CodyMcCodeface69/plantOS-Hydromat/plantos.pdf

# plantos

## started 1 week 13 minutes ago

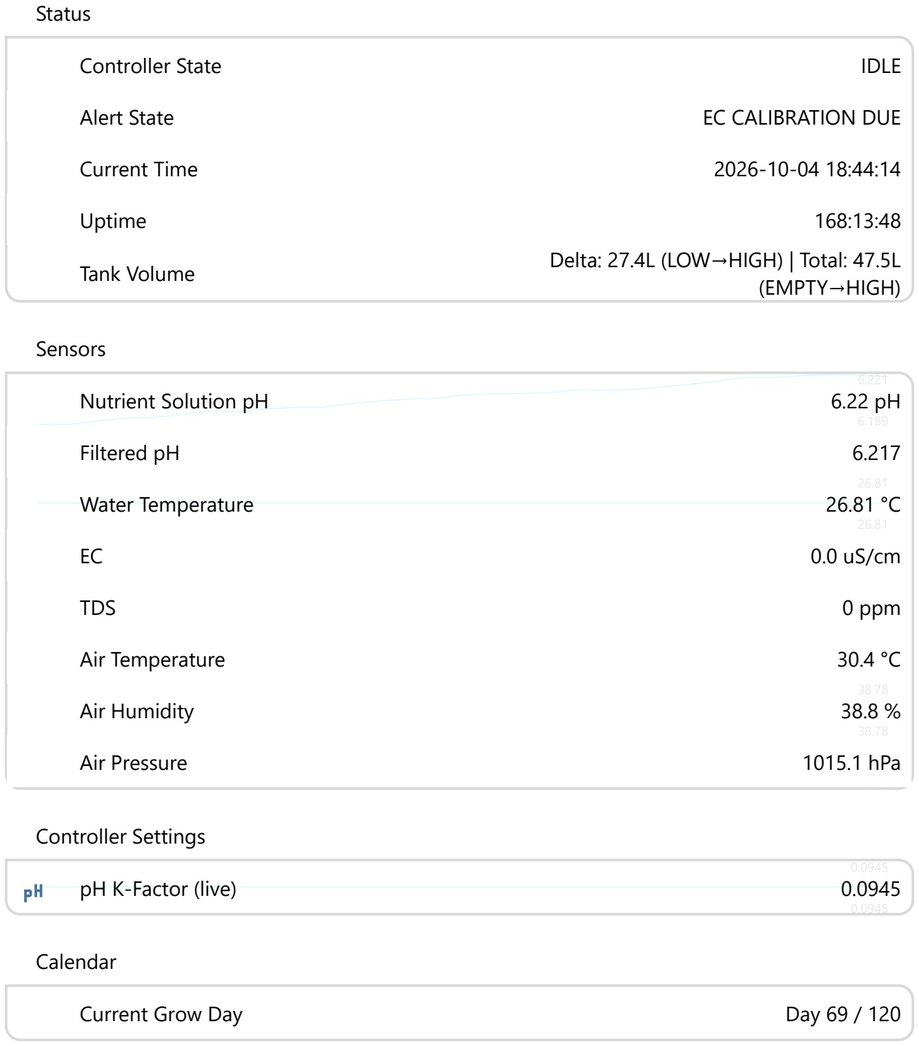
[picture p1: figure]
Status; Sensors; Controller Settings; Calendar; Controller State; IDLE; Alert State; EC CALIBRATION DUE; Current Time; Uptime; (EMPTY→HIGH); Nutrient Solution pH; Filtered pH; Water Temperature; TDS; 0 ppm; Air Temperature; Air Humidity; Air Pressure; 1015.1 hPa; pH K-Factor (live); Current Grow Day; Day 69 / 120

## System

Tank Volume | Delta: 27.4L (LOW→HIGH) | Total: 47.5L
plantos | http://192.168.0.201/
1 von 3 | 04.10.2026, 18:44

## Debug Log

Time | Tag | Message
18:44:07 [status.log… ==============================================================… 18:44:07 [status.log… PLANTOS STATUS - 2026-10-04 18:44:07
18:44:07 [status.log… ==============================================================… 18:44:07 [status.log…
18:44:07 [status.log… **************************************************************… 18:44:07 [status.log… **************************************************************… 18:44:07 [status.log… *** CRITICAL ALERTS ACTIVE ***
18:44:07 [status.log… **************************************************************… 18:44:07 [status.log… **************************************************************… 18:44:07 [status.log…
18:44:07 [status.log… *** ALERT #1: EC_CALIBRATION_DUE
18:44:07 [status.log… *** Brief: EC calibration overdue: 82 days since last
| | calibration
18:44:07 [status.log… *** Active for: 56.0 seconds
18:44:07 [status.log…
18:44:07 [status.log… **************************************************************… 18:44:07 [status.log… **************************************************************… 18:44:07 [status.log… --- NETWORK ---
18:44:07 [status.log… IP: 192.168.0.201 | Web: Online
18:44:07 [status.log… --- HARDWARE ---
18:44:07 [status.log… [✓ 0x76: BME280 Air Sensor[0m
18:44:07 [status.log… [✓ EZO pH Sensor (TX=GPIO18, RX=GPIO19 (uart_bus))[0m 18:44:07 [status.log… [✓ DS18B20 Temperature (GPIO23) - 26.8°C[0m 18:44:07 [status.log… [✓ Shelly Plus 4PM (192.168.0.130) - up 887h37m[0m 18:44:07 [status.log… [✓ Water Level: FULL (H=ON, L=ON)[0m

## Debug: HAL Mirrors

Built-in LED | 0 | 255

255

Water Temperature (HAL) | 26.8°C
Air Temperature (HAL) | 30.4°C
Air Humidity (HAL) | 38.8%
Air Pressure (HAL) | 1015.1 hPa
EC (HAL) | 0 uS/cm

18:44:07 [status.log… --- SENSORS ---
18:44:07 [status.log… pH: 6.22
18:44:07 [status.log… Water Temp: 26.8°C
18:44:07 [status.log… EC: 0 uS/cm / 0.000 mS/cm (TDS: 0 ppm) 18:44:07 [status.log… --- CALENDAR ---
18:44:07 [status.log… Day: 69/120 | pH: 6.0-6.4 | Auto: ON
18:44:07 [status.log… Nutrients (mL/L): A=0.64; B=1.28; C=1.92 18:44:07 [status.log… EC Target: 2200 x 1.00x = 2200 uS/cm
18:44:07 [status.log… --- STATE ---
18:44:07 [status.log… Controller: IDLE | Maintenance: OFF
18:44:07 [status.log… PSM: PH_CORRECTION (Status: 0, Age: 6635815 sec)
18:44:07 [status.log… Active Alerts: 1
18:44:07 [status.log… [31m[1] EC_CALIBRATION_DUE: EC calibration overdue: 82 days since last calibration (56s)[0m 18:44:07 [status.log… ==============================================================… 18:44:07 [status.log… --- WATER LEVEL STATUS ---
18:44:07 [status.log… ┌─────────┐
18:44:07 [status.log… │█████████│ ← HIGH
18:44:07 [status.log… │█████████│
18:44:07 [status.log… │█████████│ ← LOW 18:44:07 [status.log… │█████████│
18:44:07 [status.log… │█████████│ ← EMPTY
18:44:07 [status.log… └─────────┘
18:44:07 [status.log… Water Level: FULL (above HIGH sensor)
18:44:07 [status.log… Sensors: HIGH=ON, LOW=ON, EMPTY=ON
18:44:10 [ezo_ph_uar… pH: 6.22
18:44:11 [plantos_co… [CALIB_REMINDER] EC calibration overdue: 82 days since last calibration
