CodyMcCodeface69/plantOS-Hydromat/Hardware/BOM_HydromatMK1_PCB_HydromatMK1_2026-04-05.csv

No. | Quantity | Comment | Designator | Footprint | Value | Manufacturer Part | Manufacturer | Supplier Part | Supplier | LCSC Part Name | Datasheet
1 | 4 | 5017 | 3V3,5V,12V,GND | TEST-SMD_L2.7-W1.0 |  | 5017 | Keystone | C238130 | LCSC | 5017 | https://item.szlcsc.com/datasheet/5017/237378.html
2 | 1 | 10uF | B_C1 | C0603 | 10uF | CL10A106MO8NQNC | SAMSUNG(三星) | C92487 | LCSC | 10uF ±20% 16V | https://item.szlcsc.com/datasheet/CL10A106MO8NQNC/93680.html
3 | 1 | 100nF | B_C2 | C0603 | 100nF | CC0603KRX7R9BB104 | YAGEO(国巨) | C14663 | LCSC | 100nF ±10% 50V | https://item.szlcsc.com/datasheet/CC0603KRX7R9BB104/15331.html
4 | 1 | 8.2nF | B_C3 | C0805 | 8.2nF | CC0805JRX7R9BB822 | YAGEO(国巨) | C309490 | LCSC | 8.2nF ±5% 50V | https://item.szlcsc.com/datasheet/CC0805JRX7R9BB822/293106.html
5 | 1 | 1nF | B_C4 | C0805 | 1nF | CL21B102KBCNNNC | SAMSUNG(三星) | C46653 | LCSC | 1nF ±10% 50V | https://item.szlcsc.com/datasheet/CL21B102KBCNNNC/47657.html
6 | 1 | 24pF | B_C5 | C0805 | 24pF | 0805CG240J500NT | FH(风华) | C1806 | LCSC | 24pF ±5% 50V | https://item.szlcsc.com/datasheet/0805CG240J500NT/2158.html
7 | 1 | 10uF | B_C6 | C0805 | 10uF | CL21A106KBYQNNE | SAMSUNG(三星) | C2932476 | LCSC | 10uF ±10% 50V | https://item.szlcsc.com/datasheet/CL21A106KBYQNNE/3277789.html
8 | 1 | SS24FL | B_D1 | SOD-123_L2.6-W1.6-LS3.5-RD |  | SS24FL | KEXIN(科信) | C489144 | LCSC | 电压:40V 电流:2A | https://item.szlcsc.com/datasheet/SS24FL/499168.html
9 | 1 | 6.8uH | B_L1 | IND-SMD_L2.5-W2.0_FTC252010S | 6.8uH | FTC252012S6R8MBCA | cjiang(长江微电) | C5832375 | LCSC | 6.8uH ±20% 2A | https://item.szlcsc.com/datasheet/FTC252012S6R8MBCA/6763495.html
10 | 1 | 169kΩ | B_R1 | R0603 | 169kΩ | 0603WAF1693T5E | UNI-ROYAL(厚声) | C22817 | LCSC | 169kΩ ±1% 100mW 厚膜电阻 | https://atta.szlcsc.com/upload/public/pdf/source/20200306/C422600_1E6D84923E4A46A82E41ADD87F860B5C.pdf
11 | 1 | 39.2kΩ | B_R2 | R0603 | 39.2kΩ | 0603WAF3922T5E | UNI-ROYAL(厚声) | C23037 | LCSC | 39.2kΩ ±1% 100mW 厚膜电阻 | https://item.szlcsc.com/datasheet/0603WAF3922T5E/23764.html
12 | 1 | 45.3kΩ | B_R4 | R0805 | 45.3kΩ | FRC0805F4532TS | FOJAN(富捷) | C2933446 | LCSC | 45.3kΩ ±1% 125mW 厚膜电阻 | https://item.szlcsc.com/datasheet/FRC0805F4532TS/3279548.html
13 | 1 | 10.2kΩ | B_R5 | R0805 | 10.2kΩ | FRC0805F1022TS | FOJAN(富捷) | C2933282 | LCSC | 10.2kΩ ±1% 125mW 厚膜电阻
14 | 1 | 10kΩ | B_R6 | R0805 | 10kΩ | FRC0805J103TS | FOJAN(富捷) | C2930231 | LCSC | 10kΩ ±5% 125mW 厚膜电阻
15 | 1 | TPS54232DR | B_U1 | SOIC-8_L4.9-W3.9-P1.27-LS6.0-BL |  | TPS54232DR | TI(德州仪器) | C52653 | LCSC | 28V、2A、1MHz降压DC-DC转换器 | http://www.ti.com/cn/lit/gpn/tps54232
16 | 1 | 22uF | C9 | CASE-B_3528 | 22uF | TAJB226K016RNJ | Kyocera AVX | C8020 | LCSC | 22uF ±10% 16V
17 | 1 | 10uF | C10 | C0805 |  | CL21A106KAYNNNE | SAMSUNG(三星) | C15850 | LCSC
18 | 6 | 100nF | C11,C12,C17,C18,C21,C23 | C0805 | 100nF | CC0805KRX7R9BB104 | YAGEO(国巨) | C49678 | LCSC | 100nF ±10% 50V | https://item.szlcsc.com/datasheet/CC0805KRX7R9BB104/50686.html
19 | 1 | 10uF | C13 | CAP-SMD_L3.2-W1.6-RD-C7171 | 10uF | TAJA106K016RNJ | Kyocera AVX | C7171 | LCSC | 10uF ±10% 16V
20 | 1 | 470uF | C14 | CAP-SMD_BD10.0-L10.3-W10.3-LS11.0-FD | 470uF | RVT1E471M1010 | HONOR(荣誉) | C3351 | LCSC | 470uF ±20% 25V | https://atta.szlcsc.com/upload/public/pdf/source/20210521/C113284_25C86AE95FB541053FE695F13EA8E7D0.pdf
21 | 4 | 10uF | C16,C19,C20,C24 | C0805 | 10uF | GRM21BR71A106KE51L | muRata(村田) | C86038 | LCSC | 10uF ±10% 10V | https://atta.szlcsc.com/upload/public/pdf/source/20200305/C490387_23319AE8C154DEB24C505E6C82A8106A.pdf
22 | 5 | S3B-XH-A-1(LF)(SN) | CN4,CN5,CN6,CN7,CN9 | CONN-TH_S3B-XH-A-1-LF-SN |  | S3B-XH-A-1(LF)(SN) | JST | C163036 | LCSC | 1x3P 间距:2.5mm 弯插 系列:XH | https://item.szlcsc.com/datasheet/S3B-XH-A-1(LF)(SN)/174417.html
23 | 1 | S4B-XH-A(LF)(SN) | CN8 | CONN-TH_S4B-XH-A-LF-SN |  | S4B-XH-A(LF)(SN) | JST | C157925 | LCSC | 1x4P 间距:2.5mm 弯插 系列:XH | https://item.szlcsc.com/datasheet/S4B-XH-A(LF)(SN)/169273.html
24 | 1 | SS54 | D1 | SMA_L4.3-W2.6-LS5.1-RD |  | SS54 | JSMSEMI(杰盛微) | C20609300 | LCSC | 电压:40V 电流:5A | https://item.szlcsc.com/datasheet/SS54/21959862.html
25 | 5 | SS24 | D2,D3,D4,D5,D6 | SMA_L4.3-W2.6-LS5.0-FD |  | SS24 | R+O(宏嘉诚) | C7420362 | LCSC | 电压:40V 电流:2A | https://item.szlcsc.com/datasheet/SS24/8397184.html
26 | 1 | DC-018-2.5A-2.5 | DC2 | DC-IN-TH_DC-018 |  | DC-018-2.5A-2.5 | XKB Connection(中国星坤) | C2880553 | LCSC
27 | 1 | XL-1608UGC-04 | LED1 | LED0603-RD_GREEN |  | XL-1608UGC-04 | XINGLIGHT(成兴光) | C965804 | LCSC | 0603翠绿贴片式发光二极管 | https://item.szlcsc.com/datasheet/XL-1608UGC-04/1051413.html
28 | 4 | ZX-PM2.54-1-16PY | P1,P2,P5,P6 | HDR-TH_16P-P2.54-V-F-1 |  | ZX-PM2.54-1-16PY | Megastar(兆星) | C7499334 | LCSC | 1x16P 间距:2.54mm 直插 | https://item.szlcsc.com/datasheet/ZX-PM2.54-1-16PY/8573995.html
29 | 2 | 2.54-1*8P母环保 | P3,P4 | HDR-TH_8P-P2.54-V-F_2 |  | 2.54-1*8P母环保 | BOOMELE(博穆精密) | C27438 | LCSC | 1x8P 间距:2.54mm 直插 | https://item.szlcsc.com/datasheet/2.54-1*8P%25E6%25AF%258D%25E7%258E%25AF%25E4%25BF%259D/28187.html
30 | 5 | IRLML6244TRPBF | Q1,Q2,Q3,Q4,Q5 | SOT-23-3_L2.9-W1.3-P1.90-LS2.4-BR |  | IRLML6244TRPBF | Infineon(英飞凌) | C143946 | LCSC | 1个N沟道 耐压:20V 电流:6.3A | https://item.szlcsc.com/datasheet/IRLML6244TRPBF/155278.html
31 | 5 | 10kΩ | R1,R4,R5,R14,R16 | R0805 | 10kΩ | 0805W8F1002T5E | UNI-ROYAL(厚声) | C17414 | LCSC | 10kΩ ±1% 125mW 厚膜电阻 | https://item.szlcsc.com/datasheet/0805W8F1002T5E/18102.html
32 | 6 | 100Ω | R2,R3,R13,R15,R17,R22 | R0805 | 100Ω | 0805W8F1000T5E | UNI-ROYAL(厚声) | C17408 | LCSC | 100Ω ±1% 125mW 厚膜电阻 | https://atta.szlcsc.com/upload/public/pdf/source/20200306/C422600_1E6D84923E4A46A82E41ADD87F860B5C.pdf
33 | 1 | 4.7kΩ | R18 | R0805 | 4.7kΩ | 0805W8F4701T5E | UNI-ROYAL(厚声) | C17673 | LCSC | 4.7kΩ ±1% 125mW 厚膜电阻 | https://atta.szlcsc.com/upload/public/pdf/source/20200306/C422600_1E6D84923E4A46A82E41ADD87F860B5C.pdf
34 | 1 | 1kΩ | R23 | R0805 | 1kΩ | FRC0805J102 TS | FOJAN(富捷) | C2907295 | LCSC | 1kΩ ±5% 125mW 厚膜电阻
35 | 5 | S2B-XH-A-1(LF)(SN) | U1,U2,U3,U4,U5 | CONN-TH_S2B-XH-A-1-LF-SN |  | S2B-XH-A-1(LF)(SN) | JST | C163035 | LCSC | 1x2P 间距:2.5mm 弯插 系列:XH | https://item.szlcsc.com/datasheet/S2B-XH-A-1(LF)(SN)/174416.html
36 | 1 | AMS1117-3.3 | U10 | SOT-223-4_L6.5-W3.5-P2.30-LS7.0-BR |  | AMS1117-3.3 | UMW(友台半导体) | C347222 | LCSC | 3.3V 1A 12V | https://item.szlcsc.com/datasheet/AMS1117-3.3/323882.html
37 | 1 | 220kHz | U11 | PWRM-TH_B0303S-1WR3 | 220kHz | B0303S-1WR3 | YLPTEC(易川) | C7468813 | LCSC | DC-DC转换器 | https://item.szlcsc.com/datasheet/B0303S-1WR3/8515946.html
38 | 1 | ADUM1201ARZ-RL7 | U13 | SOIC-8_L4.9-W3.9-P1.27-LS6.0-BL |  | ADUM1201ARZ-RL7 | ADI(亚德诺) | C9669 | LCSC | 双通道数字隔离器（1/1通道方向性） | https://item.szlcsc.com/datasheet/ADUM1201ARZ-RL7/10199.html
