CodyMcCodeface69/plantOS-Hydromat/docs/architecture/MIGRATION_GUIDE.md

# PlantOS Migration Guide: Dual FSM → Unified 3-Layer HAL

This guide helps users migrate from the old dual FSM architecture (Controller + PlantOSLogic) to the new unified 3-layer HAL architecture (PlantOSController).

## Quick Summary

### What Changed?
- **Old**: Two separate FSMs (Controller for hardware, PlantOSLogic for routines)
- **New**: Single unified FSM (PlantOSController) with 12 states
- **Architecture**: Added HAL (Hardware Abstraction Layer) between controller and hardware

### What Stayed The Same?
- ✅ All functionality preserved (pH correction, feeding, water management)
- ✅ Safety features (ActuatorSafetyGate, PSM, WDT)
- ✅ Web interface controls
- ✅ Configuration in plantOS.yaml
- ✅ ESPHome framework and workflow

### Breaking Changes?
- **YAML configuration changes**: Required (component names, IDs)
- **Button lambda calls**: Changed (different API methods)
- **Custom automation**: May need updates (different component IDs)
- **Existing data**: Preserved (NVS, settings, schedules)

## Architecture Comparison

### Old Architecture (Dual FSM)

```
┌─────────────────────────────┐
│ Controller (Hardware FSM)   │
│ - INIT, READY, ERROR       │
│ - LED patterns              │
│ - Sensor monitoring         │
└────────────┬────────────────┘
             │
┌────────────▼────────────────┐
│ PlantOSLogic (App FSM)      │
│ - PH_*, FEEDING_*, WATER_*  │
│ - Routine orchestration     │
└────────────┬────────────────┘
             │
┌────────────▼────────────────┐
│ ActuatorSafetyGate          │
│ - Direct GPIO control       │
└─────────────────────────────┘
```

**Issues**:
- Confusing responsibility split
- Direct hardware access scattered
- Hard to test without hardware
- No clear hardware abstraction

### New Architecture (Unified 3-Layer HAL)

```
┌─────────────────────────────────────┐
│ Layer 1: Unified Controller        │
│ - 12 states (INIT, IDLE, PH_*, etc)│
│ - LED behaviors per state           │
│ - Complete routine orchestration    │
└────────────┬────────────────────────┘
             │ (requests)
┌────────────▼────────────────────────┐
│ Layer 2: ActuatorSafetyGate         │
│ - Validates all commands            │
│ - Enforces safety rules             │
└────────────┬────────────────────────┘
             │ (approved commands)
┌────────────▼────────────────────────┐
│ Layer 3: HAL                        │
│ - Pure hardware interface           │
│ - Wraps ESPHome components          │
└─────────────────────────────────────┘
```

**Benefits**:
- Single unified FSM (clear responsibility)
- Hardware abstraction (testable, portable)
- All hardware access through validation
- Clean layer separation

## Migration Steps

### Step 1: Backup Current Configuration

Before making changes, backup your working configuration:

```bash
# Backup YAML
cp plantOS.yaml plantOS.yaml.backup

# Backup NVS data (if possible via OTA)
# Your PSM events, calendar day, etc. are preserved in NVS
```

### Step 2: Update Git Branch

If you're on the old architecture:

```bash
# Check current branch
git status

# Switch to unified architecture branch
git checkout hydro  # or your main branch with unified controller

# Check what changed
git log --oneline
```

### Step 3: Update plantOS.yaml Configuration

#### 3a. Remove Old Components

**DELETE these sections** (if still present):

```yaml
# OLD - Remove completely
controller:
  id: my_controller
  sensor_source: filtered_ph_sensor
  light_target: system_led

# OLD - Remove completely
plantos_logic:
  id: plant_logic
  hal: hal
  safety_gate: actuator_safety
  calendar: plant_calendar
  persistence: psm
```

#### 3b. Add HAL Component

**ADD this new section**:

```yaml
# Layer 3: Hardware Abstraction Layer
plantos_hal:
  id: hal
  system_led: system_led        # Reference to your RGB LED
  ph_sensor: filtered_ph_sensor # Reference to your pH sensor
```

#### 3c. Update SafetyGate Configuration

**CHANGE**:
```yaml
# OLD
actuator_safety_gate:
  id: actuator_safety
  # ... durations ...
```

**TO**:
```yaml
# NEW - Add HAL dependency
actuator_safety_gate:
  id: actuator_safety
  hal: hal  # NEW: HAL dependency
  acid_pump_max_duration: 30
  nutrient_pump_max_duration: 60
  water_valve_max_duration: 300
  wastewater_pump_max_duration: 180
  air_pump_max_duration: 600
  ramp_duration: 2000
```

#### 3d. Add Unified Controller

**ADD this new section**:

```yaml
# Layer 1: Unified Controller
plantos_controller:
  id: unified_controller
  hal: hal                      # Required
  safety_gate: actuator_safety  # Required
  persistence: psm              # Optional
```

#### 3e. Update Button Configurations

**OLD button calls**:
```yaml
button:
  - platform: template
    name: "Start pH Correction"
    on_press:
      - lambda: id(plant_logic)->start_ph_correction();

  - platform: template
    name: "Toggle Maintenance"
    on_press:
      - lambda: id(plant_logic)->toggle_maintenance_mode(true);
```

**NEW button calls**:
```yaml
button:
  - platform: template
    name: "Start pH Correction"
    on_press:
      - lambda: id(unified_controller)->startPhCorrection();

  - platform: template
    name: "Toggle Maintenance ON"
    on_press:
      - lambda: id(unified_controller)->toggleMaintenanceMode(true);

  - platform: template
    name: "Toggle Maintenance OFF"
    on_press:
      - lambda: id(unified_controller)->toggleMaintenanceMode(false);
```

#### 3f. Update external_components List

**CHANGE**:
```yaml
external_components:
  - source: components
    components: [controller, sensor_dummy, plantos_logic, ...]
```

**TO**:
```yaml
external_components:
  - source: components
    components: [sensor_dummy, sensor_filter, ezo_ph,
                 actuator_safety_gate, calendar_manager,
                 persistent_state_manager, i2c_scanner,
                 time_logger, wdt_manager, i2c_mutex_demo,
                 plantos_hal, plantos_controller]
```

**Removed**: `controller`, `plantos_logic`
**Added**: `plantos_hal`, `plantos_controller`

### Step 4: Build and Flash

```bash
# Clean old build
task clean

# Build new firmware
task build

# Flash to device
task flash

# Monitor logs
task snoop
```

### Step 5: Verify Operation

After flashing, verify these behaviors:

#### Boot Sequence (3 seconds)
- ✅ LED: Red → Yellow → Green
- ✅ Serial: "Boot sequence complete"
- ✅ Transitions to IDLE state

#### IDLE State (Breathing Green)
- ✅ LED: Smooth breathing green (pulsing)
- ✅ Web interface accessible
- ✅ Buttons respond to clicks

#### pH Correction (Manual Test)
1. Click "Start pH Correction" button
2. ✅ LED: Changes to yellow pulse
3. ✅ Serial: "pH measuring: All pumps OFF"
4. ✅ After 5 min: Transitions to PH_CALCULATING
5. ✅ If correction needed: Cyan pulse (PH_INJECTING)
6. ✅ After dosing: Blue pulse (PH_MIXING, 2 min)
7. ✅ Returns to PH_MEASURING or IDLE

#### Maintenance Mode
1. Click "Toggle Maintenance ON"
2. ✅ LED: Solid yellow
3. ✅ Serial: "Maintenance mode ACTIVE - all pumps OFF"
4. ✅ All pumps turned off
5. ✅ Click "Toggle Maintenance OFF"
6. ✅ Returns to IDLE (breathing green)

## API Changes

### Old Controller API (Removed)

```cpp
// components/controller/controller.h
class Controller {
    void reset_to_init();
    void set_verbose(bool verbose);
    bool get_verbose();
    CentralStatusLogger* get_logger();
};
```

### Old PlantOSLogic API (Removed)

```cpp
// components/plantos_logic/PlantOSLogic.h
class PlantOSLogic {
    void start_ph_correction();
    void start_ph_measurement_only();
    void start_feeding();
    void start_fill_tank();
    void start_empty_tank();
    void toggle_maintenance_mode(bool state);
};
```

### New Unified Controller API

```cpp
// components/plantos_controller/controller.h
class PlantOSController {
    // Public API
    void startPhCorrection();           // Start pH correction sequence
    void startFeeding();                // Start nutrient dosing
    void startFillTank();               // Start water fill
    void startEmptyTank();              // Start water empty
    bool toggleMaintenanceMode(bool enable);  // Enter/exit maintenance
    void resetToInit();                 // Reset FSM to INIT

    // Getters
    ControllerState getCurrentState();  // Get current state
    CentralStatusLogger* getStatusLogger();  // Access status logger
};
```

### API Migration Table

| Old API | New API | Notes |
|---|---|---|
| `my_controller->reset_to_init()` | `unified_controller->resetToInit()` | Camel case |
| `plant_logic->start_ph_correction()` | `unified_controller->startPhCorrection()` | Camel case, different ID |
| `plant_logic->start_feeding()` | `unified_controller->startFeeding()` | Camel case, different ID |
| `plant_logic->start_fill_tank()` | `unified_controller->startFillTank()` | Camel case, different ID |
| `plant_logic->start_empty_tank()` | `unified_controller->startEmptyTank()` | Camel case, different ID |
| `plant_logic->toggle_maintenance_mode(true)` | `unified_controller->toggleMaintenanceMode(true)` | Camel case, different ID |
| `my_controller->get_logger()` | `unified_controller->getStatusLogger()` | Camel case, renamed method |
| `my_controller->set_verbose(true)` | ❌ **REMOVED** | Verbose mode removed |
| `plant_logic->start_ph_measurement_only()` | ❌ **REMOVED** | Not implemented yet |

## State Mapping

### Old Controller States → New States

| Old Controller State | New Unified State | Notes |
|---|---|---|
| INIT | INIT | Same (boot sequence) |
| CALIBRATION | ❌ Removed | Not used |
| READY | IDLE | Renamed for clarity |
| ERROR | ERROR | Same |
| ERROR_TEST | ❌ Removed | PSM test removed |

### Old PlantOSLogic States → New States

| Old Logic State | New Unified State | Notes |
|---|---|---|
| IDLE | IDLE | Same |
| PH_CORRECTION_DUE | ❌ Removed | Instant transition |
| PH_MEASURING | PH_MEASURING | Same |
| PH_CALCULATING | PH_CALCULATING | Same |
| PH_INJECTING | PH_INJECTING | Same |
| PH_MIXING | PH_MIXING | Same |
| PH_CALIBRATING | PH_CALIBRATING | Same (not implemented) |
| FEEDING_DUE | ❌ Removed | Instant transition |
| FEEDING_INJECTING | FEEDING | Renamed |
| WATER_MANAGEMENT_DUE | ❌ Removed | Instant transition |
| WATER_FILLING | WATER_FILLING | Same |
| WATER_EMPTYING | WATER_EMPTYING | Same |
| AWAITING_SHUTDOWN | MAINTENANCE | Renamed for clarity |

**Total**: 13 old states → 12 new states (removed redundant "DUE" states)

## LED Patterns

### LED Pattern Changes

| State | Old Pattern | New Pattern | Changed? |
|---|---|---|---|
| INIT | Red→Yellow→Green (3s) | Red→Yellow→Green (3s) | ✅ Same |
| IDLE/READY | Breathing green | Breathing green | ✅ Same |
| MAINTENANCE | Solid yellow | Solid yellow | ✅ Same |
| ERROR | Fast red flash | Fast red flash | ✅ Same |
| PH_MEASURING | Yellow pulse | Yellow pulse | ✅ Same |
| PH_CALCULATING | Yellow fast blink | Yellow fast blink | ✅ Same |
| PH_INJECTING | Cyan pulse | Cyan pulse | ✅ Same |
| PH_MIXING | Blue pulse | Blue pulse | ✅ Same |
| FEEDING | Orange pulse | Orange pulse | ✅ Same |
| WATER_FILLING | Blue solid | Blue solid | ✅ Same |
| WATER_EMPTYING | Purple pulse | Purple pulse | ✅ Same |

**All LED patterns preserved!** Visual behavior unchanged.

## Troubleshooting

### Build Errors

#### Error: "Could not find __init__.py file for component controller"

**Cause**: Old component still referenced in `external_components`

**Fix**: Remove `controller` and `plantos_logic` from components list:
```yaml
external_components:
  - source: components
    components: [sensor_dummy, ..., plantos_hal, plantos_controller]
    # Removed: controller, plantos_logic
```

#### Error: "Component 'my_controller' not found"

**Cause**: Button or automation references old component ID

**Fix**: Change all `my_controller` to `unified_controller`:
```yaml
# OLD
- lambda: id(my_controller)->reset_to_init();

# NEW
- lambda: id(unified_controller)->resetToInit();
```

#### Error: "Component 'plant_logic' not found"

**Cause**: Button or automation references old component ID

**Fix**: Change all `plant_logic` to `unified_controller`:
```yaml
# OLD
- lambda: id(plant_logic)->start_ph_correction();

# NEW
- lambda: id(unified_controller)->startPhCorrection();
```

#### Error: "no member named 'set_verbose'"

**Cause**: Verbose mode was removed (no longer needed)

**Fix**: Remove all verbose mode calls:
```yaml
# OLD - Remove completely
- lambda: id(my_controller)->set_verbose(true);
```

### Runtime Issues

#### LED not lighting up

**Check**:
1. HAL configured with correct LED ID:
   ```yaml
   plantos_hal:
     system_led: system_led  # Must match your light component ID
   ```
2. LED component exists:
   ```yaml
   light:
     - platform: neopixelbus
       id: system_led
   ```

#### pH readings not working

**Check**:
1. HAL configured with correct sensor ID:
   ```yaml
   plantos_hal:
     ph_sensor: filtered_ph_sensor  # Must match your sensor ID
   ```
2. Sensor chain intact:
   ```yaml
   sensor:
     - platform: ezo_ph
       id: raw_ph_sensor
     - platform: sensor_filter
       id: filtered_ph_sensor
       sensor_source: raw_ph_sensor
   ```

#### Pumps not activating

**Check**:
1. SafetyGate has HAL dependency:
   ```yaml
   actuator_safety_gate:
     hal: hal  # REQUIRED
   ```
2. Check serial logs for SafetyGate rejections
3. Verify duration limits not exceeded

#### Buttons don't work

**Check**:
1. Button lambda uses correct ID:
   ```yaml
   - lambda: id(unified_controller)->startPhCorrection();
   ```
2. Method name is camelCase (not snake_case)
3. Controller ID is `unified_controller` (not `my_controller` or `plant_logic`)

## Data Persistence

### What's Preserved Across Migration?

✅ **Preserved** (stored in NVS):
- Calendar Manager current day
- PSM critical events
- Maintenance mode state (if set)
- Component settings

❌ **Not Preserved**:
- Old controller state (irrelevant)
- Old PlantOSLogic state (irrelevant)
- Verbose mode setting (feature removed)

### NVS Namespace Changes

| Old Namespace | New Namespace | Status |
|---|---|---|
| `controller` | ❌ Not used | Old data ignored |
| `plantos_logic` | ❌ Not used | Old data ignored |
| `calendar_manager` | `calendar_manager` | ✅ Preserved |
| `psm` | `psm` | ✅ Preserved |

**Your grow schedule day and PSM events are preserved!**

## Rollback Procedure

If you need to revert to the old architecture:

### Step 1: Git Rollback

```bash
# Find commit before migration
git log --oneline

# Revert to old architecture
git checkout <commit-before-migration>
```

### Step 2: Restore YAML

```bash
# Restore backup
cp plantOS.yaml.backup plantOS.yaml
```

### Step 3: Rebuild and Flash

```bash
task clean
task run
```

**Note**: NVS data preserved, but you'll need to manually restore any YAML configuration changes made during migration.

## Getting Help

### Resources

- **Architecture Docs**: `docs/architecture/` - Diagrams and detailed docs
- **CLAUDE.md**: Updated component reference
- **Performance Analysis**: `docs/PERFORMANCE_ANALYSIS.md`
- **GitHub Issues**: https://github.com/anthropics/claude-code/issues

### Common Questions

**Q: Will my grow schedule be lost?**
A: No, Calendar Manager data is stored in NVS and preserved.

**Q: Do I need to recalibrate my pH sensor?**
A: No, calibration is stored in the EZO chip itself, not affected.

**Q: Will existing automations break?**
A: Only if they reference `my_controller` or `plant_logic`. Update IDs to `unified_controller` and method names to camelCase.

**Q: Is the new architecture slower?**
A: No, it's actually faster! Loop runs at 3,000-9,000 Hz (vs old ~1,000 Hz).

**Q: Can I keep using both architectures?**
A: No, they're incompatible. You must migrate completely.

**Q: What if I have custom components that depend on old controller?**
A: Update them to use `plantos_controller` API instead. See API migration table above.

## Migration Checklist

### Before Migration
- [ ] Backup `plantOS.yaml`
- [ ] Note current grow schedule day (will be preserved, but good to know)
- [ ] Document any custom automations/buttons
- [ ] Git commit current state

### Configuration Changes
- [ ] Add `plantos_hal` component
- [ ] Add `plantos_controller` component
- [ ] Update `actuator_safety_gate` to include `hal` dependency
- [ ] Remove `controller` component (if present)
- [ ] Remove `plantos_logic` component (if present)
- [ ] Update `external_components` list
- [ ] Update all button lambda calls (ID + method names)
- [ ] Update any custom automations

### Testing
- [ ] Build succeeds without errors
- [ ] Flash to device successfully
- [ ] Boot sequence shows Red→Yellow→Green
- [ ] IDLE shows breathing green
- [ ] Web interface loads
- [ ] "Start pH Correction" button works
- [ ] pH correction sequence completes
- [ ] Maintenance mode toggles correctly
- [ ] All pumps respond to commands

### Verification
- [ ] No error logs in serial output
- [ ] Loop frequency ≥1000 Hz (check serial if logging enabled)
- [ ] LED animations smooth
- [ ] All safety features working (SafetyGate, PSM, WDT)

### Documentation
- [ ] Update any custom documentation referencing old architecture
- [ ] Note migration date and version

## Success!

You've successfully migrated to the unified 3-layer HAL architecture! 🎉

**Benefits you now have**:
- ✅ Cleaner, unified FSM (12 states)
- ✅ Better performance (3-9x faster loop)
- ✅ Hardware abstraction (future-proof)
- ✅ Testable architecture (mockable HAL)
- ✅ Clearer responsibility separation
- ✅ All original functionality preserved

Enjoy your upgraded PlantOS system!
