CodyMcCodeface69/plantOS-Hydromat/docs/fixes/RISC-V_ALIGNMENT_FIX.md

# RISC-V Alignment Crash Fix - CriticalEventLog Struct

**Date**: 2026-01-15
**Issue**: Store address misaligned exception (MCAUSE: 0x00000007) at xQueueGiveFromISR
**Platform**: ESP32-C6 (RISC-V), ESPHome
**Status**: ✅ FIXED

## Problem Summary

The ESP32-C6 was experiencing recurring crashes with:

```
MCAUSE: 0x00000007 (Store address misaligned)
Abort PC: 0x420dcf97
RA: 0x40808482 (xQueueGiveFromISR)
Faulty Address (A1): 0x408264fe (NOT 4-byte aligned!)
Stack trace contains: "AutoFeedEnable"
```

## Root Cause: Struct Alignment Issue

The crash was caused by the `CriticalEventLog` struct in the Persistent State Manager component having **misaligned fields** that violated RISC-V alignment requirements.

### The Broken Struct

```cpp
// OLD (CRASHES on ESP32-C6)
struct CriticalEventLog {
    char eventID[32];       // 32 bytes at offset 0
    int64_t timestampSec;   // 8 bytes at offset 32 (MISALIGNED!)
    int32_t status;         // 4 bytes at offset 40
};
```

### Why This Crashed

1. **RISC-V Alignment Requirements**:
   - `int64_t` MUST be on 8-byte boundaries (addresses divisible by 8)
   - `int32_t` MUST be on 4-byte boundaries (addresses divisible by 4)
   - `char` has no alignment requirement

2. **The Problem**:
   - `timestampSec` was at offset 32 (after the 32-byte char array)
   - While 32 is divisible by 4, the compiler may place the struct instance at addresses that aren't 8-byte aligned
   - When NVS operations (which use FreeRTOS queues internally) tried to access `timestampSec`, it caused a hardware exception

3. **Why "AutoFeedEnable" Appeared**:
   - The crash occurred during `psm->loadState(NVS_KEY_AUTO_FEED_ENABLE, true)` in controller.cpp:58
   - This NVS operation internally loaded/saved the `CriticalEventLog` struct
   - The misaligned access to `timestampSec` triggered xQueueGiveFromISR to crash

### ESP32 vs ESP32-C6 Behavior

| Architecture | Behavior on Misaligned Access |
|---|---|
| ESP32 (Xtensa) | Allowed (with performance penalty) |
| ESP32-C6 (RISC-V) | **Hardware exception - instant crash!** |

RISC-V is **strict about alignment** by design. This makes code faster but requires careful struct design.

## The Fix

### 1. Reorder Struct Members (Largest to Smallest)

```cpp
// NEW (FIXED for RISC-V)
struct __attribute__((aligned(8))) CriticalEventLog {
    int64_t timestampSec;   // 8 bytes at offset 0 (8-byte aligned ✓)
    int32_t status;         // 4 bytes at offset 8 (4-byte aligned ✓)
    char eventID[32];       // 32 bytes at offset 12 (no requirement)
};
```

**Why This Works**:
- `timestampSec` is now at offset 0 - guaranteed 8-byte aligned
- `status` is at offset 8 - divisible by 4 ✓
- `eventID` is at offset 12 - char arrays have no alignment requirement
- `__attribute__((aligned(8)))` ensures the struct itself is allocated on 8-byte boundaries

### 2. Updated Constructor

The constructor was updated to match the new field order:

```cpp
CriticalEventLog() {
    timestampSec = 0;      // Initialize first (was third)
    status = 0;            // Initialize second (was fourth)
    memset(eventID, 0, sizeof(eventID));  // Initialize third (was first)
}
```

## Files Modified

### `components/persistent_state_manager/persistent_state_manager.h`

**Lines 13-52**: Complete struct rewrite with:
- Field reordering (largest to smallest)
- Explicit 8-byte alignment attribute
- Detailed comments explaining the RISC-V alignment fix
- Updated constructor initialization order

## Memory Layout Comparison

### Before (BROKEN)
```
Offset  Field           Size  Alignment  Issue
------  ------------    ----  ---------  -----
0       eventID[32]     32    1          OK
32      timestampSec    8     8          MISALIGNED! (if struct base isn't 8-aligned)
40      status          4     4          OK
Total: 48 bytes (with padding)
```

### After (FIXED)
```
Offset  Field           Size  Alignment  Issue
------  ------------    ----  ---------  -----
0       timestampSec    8     8          ✓ ALWAYS ALIGNED
8       status          4     4          ✓ ALWAYS ALIGNED (8 % 4 = 0)
12      eventID[32]     32    1          ✓ OK
Total: 48 bytes (with padding, same size!)
```

## NVS Compatibility Warning

**CRITICAL**: This struct change **breaks NVS compatibility** with old data!

If you have existing NVS data saved with the old struct layout, it will be **corrupted** when read with the new layout.

### Migration Options

#### Option 1: Clear NVS (Recommended for Development)

```bash
# Flash with NVS erase
esphome run plantOS.yaml --device /dev/ttyUSB0 --no-logs
# Then manually trigger:
# Settings → Erase Flash (if available in web UI)
```

Or via esptool:
```bash
esptool.py --chip esp32c6 --port /dev/ttyUSB0 erase_flash
task flash
```

#### Option 2: NVS Migration (Production Systems)

If you have critical data in NVS:

1. **Before updating firmware**: Export current events via serial logs
2. **Update firmware** with new struct
3. **After boot**: Manually restore critical state via web UI

#### Option 3: Versioned NVS Key (Future-Proof)

For production systems, consider versioned keys:
```cpp
static constexpr const char* NVS_KEY = "critical_event_v2";
```

This allows old data to remain in NVS while new data uses the fixed struct.

## Verification Steps

### 1. Build the Firmware

```bash
cd ~/plantOS-testlab
task build
```

Expected: Clean build with no warnings about alignment

### 2. Flash to Device

```bash
task flash
```

### 3. Monitor Boot Sequence

```bash
task snoop
```

Look for:
- No "Store address misaligned" exceptions
- PSM loads/saves correctly
- AutoFeed state persists across reboots
- No crashes during NVS operations

### 4. Test AutoFeed Toggle

1. Open web UI
2. Toggle auto-feed enable/disable multiple times
3. Reboot device
4. Verify setting persisted

### 5. Test Critical Event Logging

```cpp
// From web UI or serial console:
psm->logEvent("TEST_EVENT", 0);  // Should not crash
```

### 6. Stress Test (24 Hours)

Run the system for 24+ hours with:
- Auto-feed enabled
- pH correction running
- Multiple reboots (intentional power cycles)
- NVS writes/reads (event logging)

**Success Criteria**: Zero crashes, all state persists correctly

## RISC-V Alignment Best Practices

### ✅ DO: Order Struct Members Largest to Smallest

```cpp
struct MyStruct {
    double big_value;      // 8 bytes first
    int64_t timestamp;     // 8 bytes
    int32_t counter;       // 4 bytes
    int16_t small;         // 2 bytes
    uint8_t flags;         // 1 byte
    char name[32];         // Arrays last
} __attribute__((aligned(8)));  // Explicit alignment for largest member
```

### ✅ DO: Use Explicit Alignment Attributes

```cpp
struct __attribute__((aligned(8))) MyStruct {
    int64_t timestamp;
    // ...
};
```

### ✅ DO: Check Struct Layout at Compile Time

```cpp
static_assert(offsetof(CriticalEventLog, timestampSec) % 8 == 0,
              "timestampSec must be 8-byte aligned");
```

### ❌ DON'T: Use `__attribute__((packed))` Without Understanding Consequences

```cpp
// BAD: Forces misalignment!
struct __attribute__((packed)) BrokenStruct {
    char flag;           // 1 byte at offset 0
    int64_t timestamp;   // 8 bytes at offset 1 - MISALIGNED!
};  // WILL CRASH ON RISC-V!
```

### ❌ DON'T: Mix Alignment Requirements Randomly

```cpp
// BAD: Random order causes padding waste and potential misalignment
struct BadStruct {
    uint8_t flag1;       // 1 byte, 7 bytes padding
    int64_t timestamp;   // 8 bytes
    uint8_t flag2;       // 1 byte, 7 bytes padding
    int64_t counter;     // 8 bytes
};  // Total: 32 bytes with wasted padding
```

## Why RISC-V Is Different

### Xtensa (ESP32) Architecture
- **Allows misaligned access** (with performance penalty)
- Code that works on ESP32 may crash on ESP32-C6
- Many Arduino sketches assume this leniency

### RISC-V (ESP32-C6) Architecture
- **Strict alignment enforcement** (hardware exception)
- Crashes immediately on misaligned access
- Forces developers to write correct code
- **Faster execution** when aligned correctly

### Philosophy
RISC-V prioritizes **simplicity and speed** over convenience. The hardware doesn't waste cycles handling misalignment - it just crashes, forcing you to fix the code.

## Debugging Misalignment Crashes

If you encounter similar crashes in the future:

### 1. Decode the Crash Address

```bash
~/.platformio/packages/toolchain-riscv32-esp/bin/riscv32-esp-elf-addr2line \
  -e ~/plantOS-testlab/.esphome/build/plantos-testlab/.pioenvs/plantos-testlab/firmware.elf \
  -f -C 0x<CRASH_ADDRESS>
```

### 2. Check Crash Type

```
MCAUSE: 0x00000006 = Load address misaligned
MCAUSE: 0x00000007 = Store address misaligned
```

Both indicate alignment violations.

### 3. Look for FreeRTOS Queue Operations

Crashes in `xQueueSendFromISR`, `xQueueGiveFromISR`, or `xSemaphoreGiveFromISR` often indicate **data structures with alignment issues** being passed to queues.

### 4. Inspect Nearby Strings in Stack

Stack memory often reveals which component/variable is involved (like "AutoFeedEnable" in this case).

### 5. Audit All Structs

```bash
# Find all struct definitions with int64_t or double
cd ~/plantOS-testlab
grep -r "struct.*{" components/ --include="*.h" -A 20 | grep -B 5 -E "(int64_t|double)"
```

Check each one for proper field ordering.

## Testing Checklist

- [ ] Build succeeds without warnings
- [ ] Flash to device successfully
- [ ] No crashes during boot sequence
- [ ] PSM loads existing events (if NVS not erased)
- [ ] AutoFeed state persists across reboots
- [ ] pH correction works (triggers PSM logging)
- [ ] Feeding works (triggers PSM logging)
- [ ] Multiple power cycles without crashes
- [ ] 24-hour stability test passes
- [ ] NVS read/write stress test (1000+ operations)

## Related Issues

- ESP32-C6 Alignment Requirements: https://www.espressif.com/sites/default/files/documentation/esp32-c6_technical_reference_manual_en.pdf
- RISC-V Spec (Memory Model): https://riscv.org/wp-content/uploads/2017/05/riscv-spec-v2.2.pdf
- FreeRTOS Queue Internals: https://www.freertos.org/a00118.html

## Commit Message Template

```
Fix RISC-V alignment crash in CriticalEventLog struct

CRITICAL FIX: Reorder struct members to ensure proper alignment on ESP32-C6.

The CriticalEventLog struct had int64_t at offset 32, which violated RISC-V's
strict 8-byte alignment requirement. When NVS operations (using FreeRTOS queues
internally) accessed this field, it caused "Store address misaligned" exceptions.

Changes:
- Reorder struct fields: int64_t → int32_t → char[32] (largest to smallest)
- Add __attribute__((aligned(8))) to ensure struct base alignment
- Update constructor to match new field order
- Add detailed comments explaining RISC-V alignment requirements

Breaking Change: NVS compatibility broken - requires NVS erase or migration.

Resolves crash with MCAUSE: 0x00000007 in xQueueGiveFromISR involving
"AutoFeedEnable" NVS key during PSM operations.

Component: persistent_state_manager
File: components/persistent_state_manager/persistent_state_manager.h
```

---

**Author**: Claude Code
**Platform**: ESP32-C6 (RISC-V)
**ESPHome Version**: 2025.4.2
**Framework**: ESP-IDF 5.1.5
**Compiler**: GCC 12.2.0 (RISC-V)
