CodyMcCodeface69/plantOS-Hydromat/Hardware/PCB_PCB_HydromatMK1_2026-04-05.pdf

v0.1

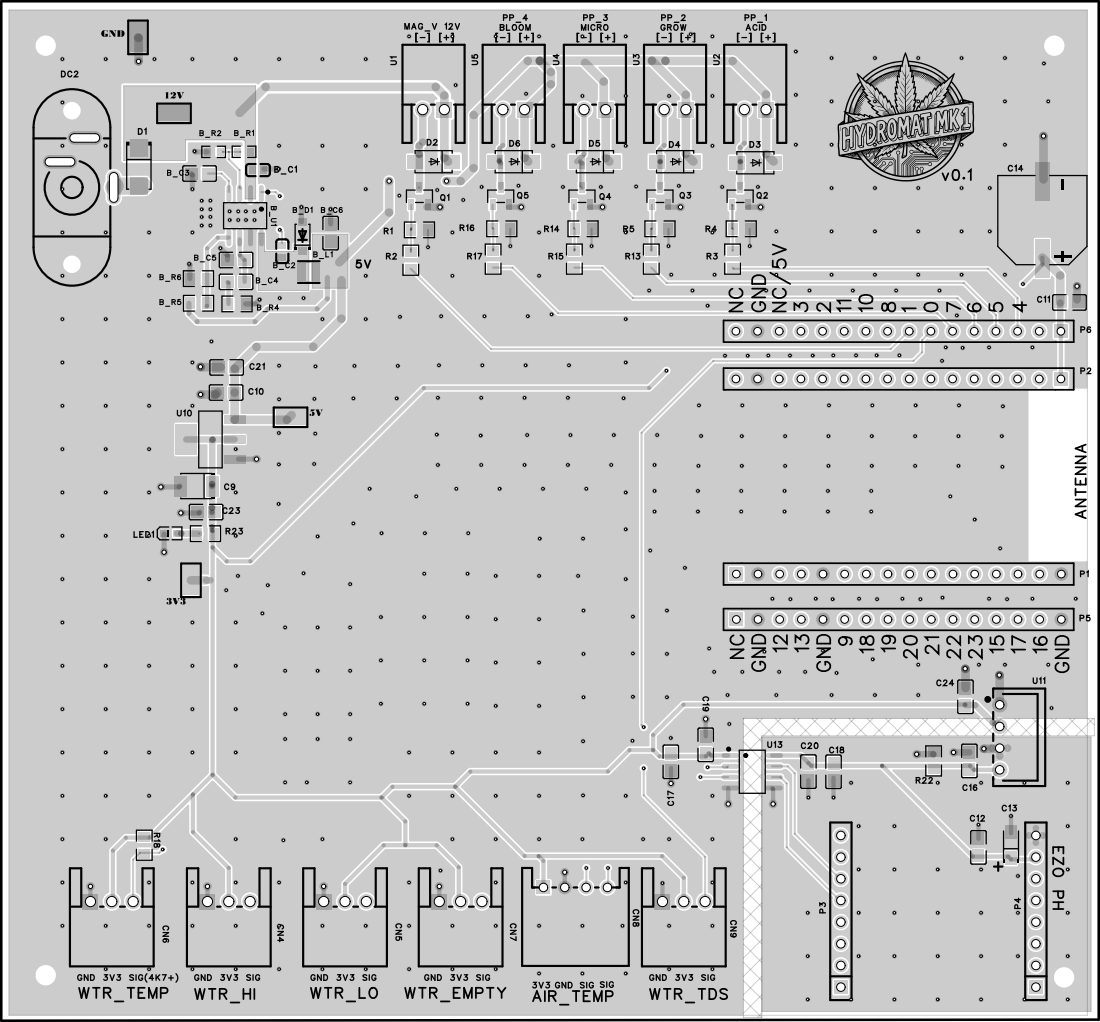
[picture p2: page 1]

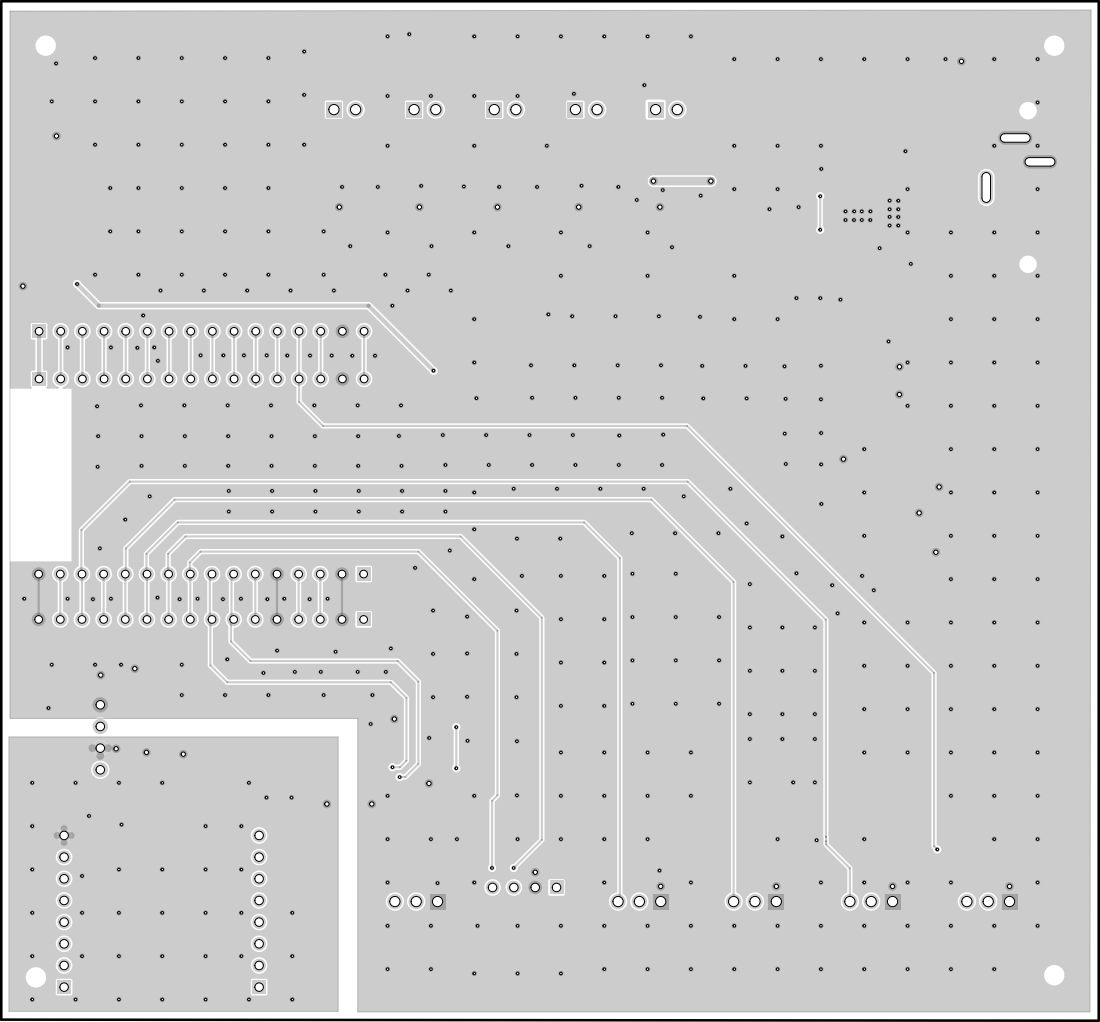
[picture p3: page 2]

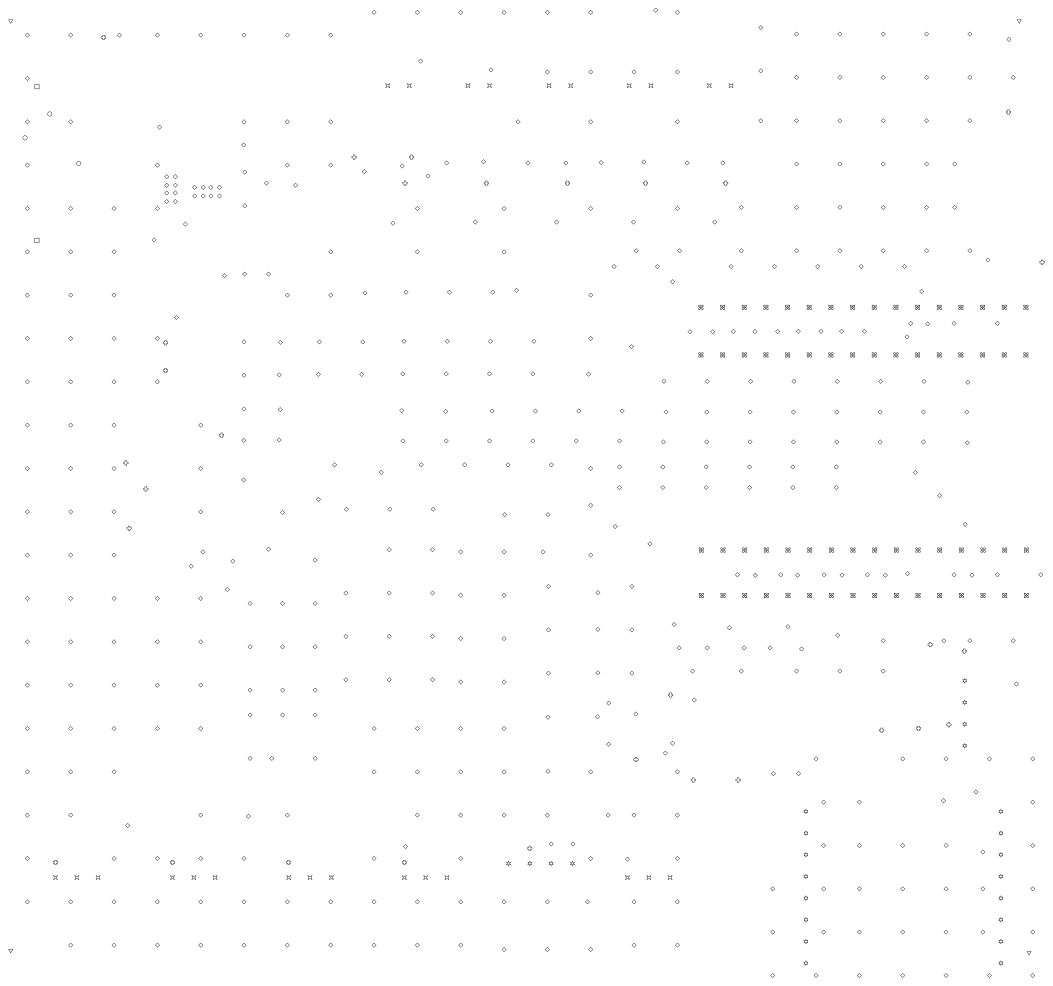
[picture p4: page 3]
