CodyMcCodeface69/plantOS-Hydromat/(list of files, drawings)

Other design files:
Hardware/ProPrj_HydromatMK1_2025-12-27_13-47-41_2026-04-05.epro
