CodyMcCodeface69/plantOS-Hydromat/plantOS.yaml

################################################################################
# PlantOS Hardware Configuration
#
# This file defines the complete hardware setup and component interconnections
# for the ESP32-C6 based plant monitoring system.
################################################################################

################################################################################
# Packages
#
# packages/debug.yaml holds debug-only entities (verbose log switches, GPIO bypass,
# HAL mirror text sensors, Shelly test buttons). They cost RAM, web UI sync time and
# MQTT topics just by existing, so production builds leave them out.
# Debug build: uncomment both lines below and flash.
################################################################################
# packages:
#   debug: !include packages/debug.yaml

esphome:
  name: plantos
  includes:
    - wifi_scan.h
  on_boot:
    # Configure actuator safety gate max durations (in seconds) on boot
    # Each actuator has a safety timeout to prevent accidents
    priority: -100  # Run after all components are initialized
    then:
      - lambda: |-
          ESP_LOGI("esphome", "Configuring actuator safety gate max durations");
          id(actuator_safety)->setMaxDuration("WaterValve", 600);       // 10 min - water fill max
          id(actuator_safety)->setMaxDuration("AcidPump", 30);          // 30 sec - pH dosing (covers PH_MAX_DOSE_ML=10mL at lowered flow rate)
          id(actuator_safety)->setMaxDuration("NutrientPumpA", 120);    // 120 sec - nutrient A (large doses at peak grow days)
          id(actuator_safety)->setMaxDuration("NutrientPumpB", 120);    // 120 sec - nutrient B
          id(actuator_safety)->setMaxDuration("NutrientPumpC", 120);    // 120 sec - nutrient C
          id(actuator_safety)->setMaxDuration("AirPump", 0);            // 0 = unlimited (24/7 operation)
          id(actuator_safety)->setMaxDuration("WastewaterPump", 1800);  // 30 min - slow pump

          // Configure air pump cycling (disabled by default for Normal mode 24/7)
          ESP_LOGI("esphome", "Configuring air pump cycling");
          id(actuator_safety)->setCyclingPeriods("AirPump", 120, 60);  // Default: 2 min ON, 1 min OFF
          id(actuator_safety)->enableCycling("AirPump", false);        // Default: Normal mode (24/7)

          // Sync restored §15 PWM slider values into the HAL pump config so the
          // slider is the single source of truth for pump duty cycle across reboots
          ESP_LOGI("esphome", "Syncing PWM slider values into HAL pump config");
          id(hal)->setPumpPwm("AcidPump",      id(pwm_gpio4_slider).state / 100.0f);
          id(hal)->setPumpPwm("NutrientPumpA", id(pwm_gpio5_slider).state / 100.0f);
          id(hal)->setPumpPwm("NutrientPumpB", id(pwm_gpio6_slider).state / 100.0f);
          id(hal)->setPumpPwm("NutrientPumpC", id(pwm_gpio7_slider).state / 100.0f);

          // Push EMA K-factor updates to the slider (only fires after a correction cycle, not on manual drag)
          id(unified_controller)->set_ph_k_update_callback([](float k) {
              id(ph_k_factor_slider).publish_state(k);
          });

esp32:
  board: esp32-c6-devkitc-1
  variant: esp32c6
  framework:
    # ESP-IDF is chosen over Arduino for:
    # - Better RISC-V support on ESP32-C6 (newer chip architecture)
    # - More direct hardware access and lower-level control
    # - Better performance for real-time LED control (RMT peripheral)
    # - Official Espressif support and documentation
    type: esp-idf
    version: recommended
    sdkconfig_options:
      # HTTP Connection Fix: Reduce TIME_WAIT socket exhaustion
      # Problem: Each HTTP request creates a TCP connection that enters TIME_WAIT for 120s
      # ESP32 lwIP has only 10 max sockets by default, causing ESP_ERR_HTTP_CONNECT errors
      # Solution: Reduce TCP_MSL from 60s to 5s (TIME_WAIT = 2×MSL = 10s instead of 120s)
      CONFIG_LWIP_TCP_MSL: "5000"        # 5s MSL = 10s TIME_WAIT (was 60s = 120s TIME_WAIT)
      CONFIG_LWIP_MAX_SOCKETS: "16"      # 16 sockets (was 10) for headroom

logger:
  # DEBUG level enables detailed component logging for development
  # This helps diagnose FSM state transitions and sensor callbacks
  # In production, consider INFO or WARN to reduce log noise
  level: DEBUG
  initial_level: DEBUG
  # ESP32-C6 uses built-in USB Serial/JTAG controller for logging
  # This must be explicitly configured or boot will hang
  hardware_uart: USB_SERIAL_JTAG

  # Component-specific log level overrides
  # Use the "Debug: Logging" web UI switches to toggle verbose logging for these components
  logs:
    adc: NONE              # Suppress ADC component messages
    light: INFO            # Suppress LED brightness/color debug messages
    sensor: INFO           # Suppress sensor state updates (web UI verbose toggle)
    text_sensor: INFO      # Suppress text sensor state updates (web UI verbose toggle)
    ezo_ph_uart: DEBUG      # Suppress EZO pH UART debug logs (web UI verbose toggle)
    sensor_filter: WARN    # Suppress sensor filter buffer logs (web UI verbose toggle)
    dallas.temp.sensor: INFO  # Suppress Dallas temp sensor logs (web UI verbose toggle)
    plantos_controller: INFO  # Suppress controller PSM check logs (web UI verbose toggle)
    plantos_hal: WARN       # Suppress HAL debug logs
    gpio_status: INFO      # Suppress GPIO status logs (web UI verbose toggle)
    component: ERROR       # Suppress component timing warnings (web UI verbose toggle)
    esp-idf: INFO          # Suppress ESP-IDF GPIO logs (web UI verbose toggle)
    time: WARN             # Suppress time synchronization logs (web UI verbose toggle)
    http_request: WARN
    wifi: WARN
    shelly_poll: WARN   # Suppress Shelly polling logs
    ledc.output: WARN  # Suppress LEDC output logs
    tds_sensor: INFO   # TDS/EC sensor logs
    template.number: INFO  # Suppress template number logs


wifi:
  # Credentials stored in secrets.yaml (gitignored) for security
  # This allows OTA updates and web interface access
  networks:
    - ssid: !secret wifi_ssid
      password: !secret wifi_password
      bssid: !secret wifi_bssid  # Optional: Fix to specific AP for stability

  # Static IP configuration for consistent web UI access
  # Uncomment if you want a fixed IP address
  manual_ip:
    static_ip: 192.168.0.201
    gateway: 192.168.0.1
    subnet: 255.255.255.0
    # DNS is REQUIRED with a static IP: setting manual_ip stops DHCP, so without
    # an explicit resolver the device has none (dns1 defaults to 0.0.0.0 = unset).
    # NTP pool hostnames then never resolve and the SNTP clock never syncs, even
    # though raw-IP traffic (Shelly, web UI, API) keeps working.
    dns1: 1.1.1.1     # router/gateway resolver
    dns2: 192.168.0.1         # public fallback

  # WiFi optimization for mesh networks (TP-Link Deco, etc.)
  # These settings improve compatibility with WiFi mesh systems
  # Mesh settings: Deactivate Fast Roaming and Beamforming, Deactivate Mesh for plantOS client, Deactivate 5 GHz band
  power_save_mode: none    # Disable power saving for better connectivity
  # fast_connect: true       # Skip channel scanning for faster connection

  # Force WiFi B/G mode by disabling 802.11n/ac features
  # This helps with mesh network compatibility and web server access
  # output_power: 8.5dB      # Lower output power for better mesh compatibility
  # enable_btm: false        # Disable 802.11v BSS Transition Management
  # enable_rrm: false        # Disable 802.11k Radio Resource Management

  # Reboot on connection failure after timeout
  # Helps recover from transient WiFi issues without manual intervention
  reboot_timeout: 2min

  # Update status logger with IP address when WiFi connects
  # Also activate air pump once on connection
  on_connect:
    - lambda: |-
        auto ip = wifi::global_wifi_component->get_ip_addresses()[0].str();
        id(unified_controller)->getStatusLogger()->updateIP(ip);
        id(unified_controller)->getStatusLogger()->updateWebServerStatus(true, false);
        ESP_LOGI("wifi", "IP address: %s", ip.c_str());

    # Wait 2 seconds for network stack to fully initialize
    - delay: 2s

    # Activate air pump once on WiFi connect (single command, no periodic health checks)
    # DISABLED: Boot-time HTTP causes socket exhaustion - manually ensure Shelly air pump is ON
    - lambda: |-
        ESP_LOGI("wifi", "WiFi connected - air pump activation disabled (manual control)");
        // id(unified_controller)->activateAirPump();

    # # Perform online connectivity check
    # - logger.log: "Performing online connectivity check (ping www.google.com)..."
    # # Start timeout handler first (will be stopped if HTTP succeeds)
    # - script.execute: connectivity_check_timeout
    # - http_request.get:
    #     url: http://www.google.com/generate_204
    #     on_response:
    #       then:
    #         - lambda: |-
    #             // Note: Any successful response (even error codes) means network is working
    #             // Only timeouts indicate mesh network issues
    #             ESP_LOGI("wifi", "✓ Online connectivity check PASSED - HTTP response received");
    #             id(unified_controller)->getStatusLogger()->updateWebServerStatus(true, true);
    #         # Stop the timeout script since we got a response
    #         - script.stop: connectivity_check_timeout

  # ==============================================================
  # FALLBACK ACCESS POINT (AP) FOR DEBUGGING
  # IMPORTANT: If the device cannot connect to the main WiFi network,
  # it creates this temporary WiFi network. Connect to it to view
  # live logs in your browser at http://192.168.4.1
  # ==============================================================
  ap:
    ssid: "PlantOS-Fallback"
    password: "debug123"
ota:
  # ESPHome OTA allows firmware updates over WiFi without USB cable
  # Critical for deployed devices in hard-to-reach locations (e.g., greenhouse)
  - platform: esphome

web_server:
  # Provides real-time sensor data and component control via browser
  # Accessible at device IP on port 80 (standard HTTP)
  # Useful for debugging and monitoring without serial connection
  version: 3
  port: 80
  # local: embed the frontend that ships with this ESPHome version (2025.4.2).
  # The default js_url (https://oi.esphome.io/v3/www.js) always serves the LATEST
  # frontend, which expects a `domain` field in SSE state events that 2025.4 doesn't
  # send. It then ignores an entity until it has seen 3 state events, so buttons,
  # switches and numbers (one event each) never appeared. Drop this after an ESPHome upgrade
  # only if the remote frontend matches the firmware again.
  local: true
  # UI categories - every entity is assigned via web_server.sorting_group_id.
  # Lower sorting_weight appears first. Debug groups sit at the bottom.
  sorting_groups:
    - id: sg_status
      name: "Status"
      sorting_weight: 10
    - id: sg_sensors
      name: "Sensors"
      sorting_weight: 20
    - id: sg_controller_actions
      name: "Controller"
      sorting_weight: 30
    - id: sg_controller_settings
      name: "Controller Settings"
      sorting_weight: 40
    - id: sg_calendar
      name: "Calendar"
      sorting_weight: 50
    - id: sg_actuators
      name: "Actuators"
      sorting_weight: 60
    - id: sg_system
      name: "System"
      sorting_weight: 70
    - id: sg_debug_logging
      name: "Debug: Logging"
      sorting_weight: 80
    - id: sg_debug_gpio
      name: "Debug: GPIO Bypass & PWM"
      sorting_weight: 90
    - id: sg_debug_hal
      name: "Debug: HAL Mirrors"
      sorting_weight: 100

# API for Home Assistant integration and external service calls
# reboot_timeout: 0s disables the "no API client connected" reboot behavior
# (web UI uses HTTP on port 80, not the ESPHome API)
api:
  reboot_timeout: 0s

################################################################################
# MQTT - Time-Series Vitals Logging
#
# Publishes a clean JSON snapshot of all vitals (pH, EC, temps, water levels) to
# `plantos/vitals` every 30s for off-device, long-term storage. Coexists with the
# native `api:` above (both stay enabled) so OTA, web UI, and Home Assistant keep
# working unchanged. Broker lives on Hetzner; the ESP32 connects OUTBOUND over TLS,
# so no inbound ports need to be opened on the home router.
#
# `discovery: false` because consumers (Telegraf) read the raw `plantos/vitals`
# topic, not Home Assistant MQTT discovery. Flip to true later if HA is added.
# `reboot_timeout: 0s` keeps the device running normally if the broker is down.
################################################################################
mqtt:
  broker: !secret mqtt_broker
  port: 8883
  username: !secret mqtt_user
  password: !secret mqtt_password
  topic_prefix: plantos
  discovery: false
  reboot_timeout: 0s
  certificate_authority: !secret mqtt_ca_cert

################################################################################
# HTTP Request Component - For Online Connectivity Check
#
# Used to verify internet connectivity by attempting to fetch a known URL.
# Google's connectivity check endpoint returns HTTP 204 (No Content) when
# online, which is a lightweight test that doesn't consume bandwidth.
################################################################################
http_request:
  id: http_client
  useragent: esphome/plantOS
  timeout: 5s  # Reduced from 5s - fail fast, rely on multi-attempt retries
  verify_ssl: false  # Skip SSL verification for simple connectivity test

################################################################################
# Time Synchronization: NTP
#
# Synchronizes the ESP32's system time with Network Time Protocol (NTP) servers.
# This enables accurate timestamping for logs, sensor data, and scheduled actions.
################################################################################
time:
  - platform: sntp
    id: sntp_time
    servers:
      - 0.pool.ntp.org
      - 1.pool.ntp.org
      - 2.pool.ntp.org
    timezone: "CET-1CEST,M3.5.0,M10.5.0/3"
    update_interval: 60s
    on_time_sync:
      then:
        - logger.log:
            level: WARN
            format: "NTP sync OK: time is now valid"

external_components:
  # Points to local custom components directory
  # ESPHome will compile and link C++ code from here alongside generated code
  - source: components
    components: [sensor_dummy, sensor_filter, ezo_ph_uart,
                 actuator_safety_gate, calendar_manager, persistent_state_manager,
                 i2c_scanner, wdt_manager, plantos_hal,
                 plantos_controller, tds_sensor, alert_service]
  # ADC fix for ESP32-C6 (oneshot API - built-in ADC doesn't compile on C6)
  # Ref: https://github.com/esphome/issues/issues/5363
  - source:
      type: git
      url: https://github.com/leon-v/esphome
      ref: adc_one_shot_C2
    components: [adc]
    refresh: 0s

# I²C Buses - Requires 4.7kΩ external pull-ups to 3.3V on each bus
i2c:
  - id: i2c_bus
    sda: GPIO20  # BME280 air temperature sensor
    scl: GPIO21
    scan: false  # Disable ESPHome's automatic scan (we use our custom scanner)
    frequency: 100kHz

# UART for EZO pH sensor - TX: GPIO18, RX: GPIO19, 9600 baud
uart:
  id: uart_bus
  tx_pin: GPIO18  # ESP32-C6 TX → EZO RX
  rx_pin: GPIO19  # ESP32-C6 RX ← EZO TX
  baud_rate: 9600
  data_bits: 8
  parity: NONE
  stop_bits: 1

# I²C Scanner - validates critical devices at boot and periodically
i2c_scanner:
  - id: my_i2c_scanner
    i2c_id: i2c_bus
    scan_on_boot: true
    scan_interval: 60s
    verbose: false
    status_logger: unified_controller
    critical_devices:
      - address: 0x76
        name: "BME280 Air Sensor"


################################################################################
# Visual Feedback: WS2812 RGB LED
#
# The built-in LED serves as the primary user interface, displaying system
# state via color and animation patterns controlled by the FSM.
################################################################################
light:
  - platform: esp32_rmt_led_strip
    # ESP32-C6-DevKitC-1 has a WS2812 RGB LED hard-wired to GPIO 8
    pin: 8
    num_leds: 1
    rgb_order: RGB
    name: "Built-in LED"
    id: system_led
    chipset: WS2812
    # internal: the FSM animates this LED; publishing every frame flooded the web UI (SSE),
    # MQTT and API. The HAL also throttles updates (ESPHomeHAL::setSystemLED).
    internal: true

    # default_transition_length: 0s disables automatic color smoothing
    # WHY: The FSM controller implements its own timing and animations
    # (breathing effect, blinking). ESPHome's built-in transitions would
    # interfere with precise FSM-driven visual feedback, creating lag or
    # blending between states. Instant transitions give the controller
    # full control over every frame.
    default_transition_length: 0s

################################################################################
# PWM Outputs: Actuator Control via Logic Level MOSFETs
#
# Five actuators controlled by 3.3V logic level MOSFETs with PWM support:
# - GPIO1: Magnetic Valve (fresh water inlet) - MagValve on PCB
# - GPIO4: pH Pump (acid dosing for pH down) - PP_1 on PCB
# - GPIO5: Grow Pump (grow phase nutrients)  - PP_2 on PCB → HAL: NutrientPumpA → Calendar: nutrient_A_ml_per_liter
# - GPIO6: Micro Pump (micronutrients)       - PP_3 on PCB → HAL: NutrientPumpB → Calendar: nutrient_B_ml_per_liter
# - GPIO7: Bloom Pump (bloom phase nutrients)- PP_4 on PCB → HAL: NutrientPumpC → Calendar: nutrient_C_ml_per_liter
#
# Using LEDC (LED PWM Controller) for both on/off and PWM control
# Frequency: 1000 Hz (1 kHz) - suitable for most pumps and valves
# All outputs are active HIGH (3.3V = ON/OPEN, 0V = OFF/CLOSED)
################################################################################
output:
  - platform: ledc
    id: mag_valve_output
    pin: GPIO1
    frequency: 1000 Hz
    zero_means_zero: true  # 0% duty cycle = truly off

  - platform: ledc
    id: pump_ph_output
    pin: GPIO4
    frequency: 1000 Hz
    zero_means_zero: true

  - platform: ledc
    id: pump_grow_output
    pin: GPIO5
    frequency: 1000 Hz
    zero_means_zero: true

  - platform: ledc
    id: pump_micro_output
    pin: GPIO6
    frequency: 1000 Hz
    zero_means_zero: true

  - platform: ledc
    id: pump_bloom_output
    pin: GPIO7
    frequency: 1000 Hz
    zero_means_zero: true

  # NOTE: Wastewater pump now controlled via Shelly Plus 4PM Socket 2 (HTTP control)
  # GPIO-based control removed to free GPIO23 for DS18B20 temperature sensor
  # - platform: ledc
  #   id: pump_wastewater_output
  #   pin: GPIO23
  #   frequency: 1000 Hz
  #   zero_means_zero: true

################################################################################
# 1-Wire Bus: For DS18B20 Temperature Sensor
#
# DS18B20 is a digital temperature sensor that uses the 1-Wire protocol.
# Only requires a single data line plus ground (can parasitic power from data).
# Requires 4.7kΩ pull-up resistor between data line and 3.3V.
#
# GPIO3 - WTR_TEMP on PCB
# Wastewater pump now controlled via Shelly Plus 4PM Socket 2 (HTTP control).
# AirPump actuator now controlled via Shelly Plus 4PM Socket 0 (HTTP control).
################################################################################
one_wire:
  - platform: gpio
    pin: GPIO3
    id: one_wire_bus

# Sensor Configuration
sensor:
  # Temperature Sensor: DS18B20 Digital Temperature Sensor
  #
  # DS18B20 is a 1-Wire digital temperature sensor providing accurate readings
  # from -55°C to +125°C with ±0.5°C accuracy between -10°C and +85°C.
  # Connected to GPIO3 (WTR_TEMP on PCB) via one_wire bus.
  #
  # HARDWARE: Requires 4.7kΩ pull-up resistor between data line (GPIO3) and 3.3V
  # WIRING:
  #   - Red wire (VCC) -> 3.3V
  #   - Black wire (GND) -> GND
  #   - Yellow wire (DATA) -> GPIO3 (with 4.7kΩ pull-up to 3.3V)
  - platform: dallas_temp
    one_wire_id: one_wire_bus
    id: water_temperature
    name: "Water Temperature"
    update_interval: 60s     # Update temperature every 60 seconds
    accuracy_decimals: 2     # Display 2 decimal places (e.g., 24.50°C)
    resolution: 12           # 12-bit resolution (0.0625°C per bit, ~750ms conversion)
    web_server:
      sorting_group_id: sg_sensors
      sorting_weight: 30

  # Environmental Sensor: BME280 Temperature/Humidity/Pressure Sensor
  #
  # BME280 is a combined environmental sensor providing:
  # - Temperature: -40°C to +85°C (±1°C accuracy)
  # - Humidity: 0-100% RH (±3% accuracy)
  # - Pressure: 300-1100 hPa (±1 hPa accuracy)
  #
  # Connected via I²C bus (GPIO20=SDA, GPIO21=SCL) at address 0x76 or 0x77
  # AIR_TEMP on PCB
  #
  # HARDWARE: Requires 4.7kΩ pull-up resistors on SDA/SCL to 3.3V (already present on I²C bus)
  # WIRING:
  #   - VCC -> 3.3V
  #   - GND -> GND
  #   - SDA -> GPIO20 (I²C SDA with 4.7kΩ pull-up)
  #   - SCL -> GPIO21 (I²C SCL with 4.7kΩ pull-up)
  #
  # NOTE: This sensor is non-critical - system operates normally if not present
  # FIXED: Changed platform from 'bme280' to 'bme280_i2c' (ESPHome 2024.2.0+ requirement)
  - platform: bme280_i2c
    i2c_id: i2c_bus
    address: 0x76           # Default address (some modules use 0x77)
    update_interval: 60s    # Update environmental data every 60 seconds

    temperature:
      id: bme280_temperature
      name: "Air Temperature"
      accuracy_decimals: 1
      oversampling: 16x     # High oversampling for accuracy
      web_server:
        sorting_group_id: sg_sensors
        sorting_weight: 60

    humidity:
      id: bme280_humidity
      name: "Air Humidity"
      accuracy_decimals: 1
      oversampling: 16x
      web_server:
        sorting_group_id: sg_sensors
        sorting_weight: 70

    pressure:
      id: bme280_pressure
      name: "Air Pressure"
      accuracy_decimals: 1
      oversampling: 16x
      web_server:
        sorting_group_id: sg_sensors
        sorting_weight: 80

  # TDS/EC Sensor: KS0429 TDS Meter V1.0 via ADC
  #
  # Reads water conductivity (EC) for nutrient monitoring.
  # Uses leon-v ADC fork for ESP32-C6 compatibility (oneshot API).
  # Signal chain: ADC voltage → tds_sensor (median filter + temp comp + polynomial) → EC (uS/cm)
  #
  # HARDWARE: KS0429 TDS Meter V1.0
  #   - VCC -> 3.3V (supports 3.3-5.5V)
  #   - GND -> GND
  #   - Signal -> GPIO0 (ADC1_CH0)
  #   - Output range: 0-2.3V (0-1000ppm TDS)
  - platform: adc
    id: tds_adc_raw
    pin: GPIO0
    name: "TDS ADC Raw Voltage"
    internal: true
    update_interval: 100ms
    samples: 5

  # TDS Sensor: Median filter + temperature compensation + KS0429 polynomial
  # Converts raw ADC voltage to EC (uS/cm)
  # EC (uS/cm) = 133.42*V^3 - 255.86*V^2 + 857.39*V (compensated for temperature)
  - platform: tds_sensor
    id: ec_sensor
    name: "EC"
    sensor_source: tds_adc_raw
    temperature_sensor: water_temperature
    sample_count: 30
    default_temperature: 25.0
    update_interval: 5s
    accuracy_decimals: 1
    web_server:
      sorting_group_id: sg_sensors
      sorting_weight: 40

  # Sensor Filter: Robust Averaging with Outlier Rejection
  #
  # Filters the raw sensor data using robust averaging to reject outliers.
  # This improves data quality by removing sensor spikes, noise, and glitches.
  - id: sensor_filtered_id
    platform: sensor_filter
    name: "Filtered pH"
    accuracy_decimals: 3  # Display 3 decimal places (e.g., 2.936)
    web_server:
      sorting_group_id: sg_sensors
      sorting_weight: 20

    # sensor_source: The raw sensor to filter
    sensor_source: ph_sensor_real

    # window_size: Number of readings to collect before calculating average
    # 5 readings = faster first result (5 minutes with 60s update interval)
    # Note: EZO pH sensor already has sliding_window_moving_average filter
    window_size: 5

    # reject_percentage: Percentage to reject from each end (0.0 to 0.5)
    # 0.10 = reject 10% lowest + 10% highest = 20% total outlier rejection
    # With 5 readings: rejects 0.5 from each end (rounds to nearest)
    reject_percentage: 0.10


  # Live EMA-adapted K-factor used by the acid dosing formula
  - platform: template
    name: "pH K-Factor (live)"
    id: ph_k_factor_sensor
    icon: "mdi:ph"
    accuracy_decimals: 4
    update_interval: 30s
    lambda: 'return id(unified_controller)->get_ph_k_factor();'
    web_server:
      sorting_group_id: sg_controller_settings
      sorting_weight: 160

################################################################################
# Binary Sensors: Water Level Sensors (XKC-Y23-V)
#
# Three capacitive non-contact water level sensors for tank monitoring and
# automatic feeding:
# - HIGH sensor (GPIO17): Tank full indicator - WTR_HI on PCB
# - LOW sensor (GPIO23): Auto-feed trigger level - WTR_LO on PCB
# - EMPTY sensor (GPIO22): Minimum safe level (prevents pump dry-running) - WTR_Empty on PCB
#
# 5 Tank States (3-Sensor System):
# - HIGH=ON, LOW=ON:         FULL (above HIGH)
# - HIGH=OFF, LOW=ON:        NORMAL (between HIGH and LOW)
# - HIGH=OFF, LOW=OFF, EMPTY=ON:  LOW (auto-feed trigger zone ⚡)
# - HIGH=OFF, LOW=OFF, EMPTY=OFF: EMPTY (danger - below safe level ⚠️)
# - HIGH=ON, LOW=OFF:        ERROR (invalid - check wiring)
################################################################################
binary_sensor:
  # XKC-Y23-V Water Level HIGH Sensor (GPIO17 - WTR_HI)
  # Triggers when water reaches high level (tank near full)
  - platform: gpio
    id: water_level_high_sensor
    name: "Water Level HIGH"
    web_server:
      sorting_group_id: sg_sensors
      sorting_weight: 90
    pin:
      number: GPIO17
      mode:
        input: true
        pulldown: true  # Pull down when sensor not active
    filters:
      # Debounce: sensor must be stable for 500ms to prevent water ripple false triggers
      - delayed_on: 500ms
      - delayed_off: 500ms
    on_press:
      then:
        - logger.log: "Water level HIGH detected - tank near full"
    on_release:
      then:
        - logger.log: "Water level HIGH cleared - tank below high level"

  # XKC-Y23-V Water Level LOW Sensor (GPIO23 - WTR_LO)
  # Triggers when water reaches auto-feed trigger level (moved up from original position)
  # When OFF (with EMPTY=ON), triggers automatic feeding once per day
  - platform: gpio
    id: water_level_low_sensor
    name: "Water Level LOW"
    web_server:
      sorting_group_id: sg_sensors
      sorting_weight: 100
    pin:
      number: GPIO23
      mode:
        input: true
        pulldown: true  # Pull down when sensor not active
    filters:
      # Debounce: sensor must be stable for 500ms to prevent water ripple false triggers
      - delayed_on: 500ms
      - delayed_off: 500ms
    on_press:
      then:
        - logger.log: "Water level LOW detected - tank above auto-feed trigger"
    on_release:
      then:
        - logger.log: "Water level LOW cleared - entering auto-feed trigger zone"

  # XKC-Y23-V Water Level EMPTY Sensor (GPIO22 - WTR_Empty)
  # Triggers when water is at absolute minimum safe level
  # Prevents pump dry-running during drain operations
  - platform: gpio
    id: water_level_empty_sensor
    name: "Water Level EMPTY"
    web_server:
      sorting_group_id: sg_sensors
      sorting_weight: 110
    pin:
      number: GPIO22
      mode:
        input: true
        pulldown: true  # Pull down when sensor not active
    filters:
      # Debounce: sensor must be stable for 500ms to prevent water ripple false triggers
      - delayed_on: 500ms
      - delayed_off: 500ms
    on_press:
      then:
        - logger.log: "Water level EMPTY detected - water at minimum safe level"
    on_release:
      then:
        - logger.log: "Water level EMPTY cleared - DANGER: Tank below safe level!"


################################################################################
# Text Sensor: Controller State (00 - Kern-Status)
#
# Publishes the current unified controller FSM state to the web UI.
# Shows state names: INIT, IDLE, SHUTDOWN, PAUSE, ERROR, PH_MEASURING,
#                    PH_CALCULATING, PH_INJECTING, PH_MIXING, PH_CALIBRATING,
#                    FEEDING, WATER_FILLING, WATER_EMPTYING
################################################################################
text_sensor:
  - platform: template
    name: "Controller State"
    id: controller_state_text
    # Lambda returns current controller state as string
    lambda: |-
      return id(unified_controller)->getStateAsString();
    # Update every 5s to show real-time state changes
    update_interval: 5s
    web_server:
      sorting_group_id: sg_status
      sorting_weight: 10

  - platform: template
    name: "Alert State"
    id: alert_state_text
    # Lambda returns current alert state in short form (Clear, pH Critical, etc.)
    lambda: |-
      return id(unified_controller)->getStatusLogger()->getAlertStateShort();
    # Update every 5s to show real-time alert changes
    update_interval: 5s
    web_server:
      sorting_group_id: sg_status
      sorting_weight: 20

  - platform: template
    name: "Uptime"
    id: uptime_text
    web_server:
      sorting_group_id: sg_status
      sorting_weight: 40
    lambda: |-
      uint32_t sec = millis() / 1000;
      uint32_t h = sec / 3600;
      uint32_t m = (sec % 3600) / 60;
      uint32_t s = sec % 60;
      char buf[12];
      snprintf(buf, sizeof(buf), "%02u:%02u:%02u", h, m, s);
      return {buf};
    update_interval: 1s

  # TDS in ppm derived from EC (EC * 0.5) - only exists as this text sensor
  - platform: template
    name: "TDS"
    id: tds_ppm_text
    web_server:
      sorting_group_id: sg_sensors
      sorting_weight: 50
    lambda: |-
      if (id(hal)->hasECValue()) {
        char buf[32];
        snprintf(buf, sizeof(buf), "%.0f ppm", id(hal)->readEC() * 0.5f);
        return {buf};
      } else {
        return {"N/A"};
      }
    update_interval: 10s

  - platform: template
    name: "Tank Volume"
    id: tank_volume_text
    web_server:
      sorting_group_id: sg_status
      sorting_weight: 50
    # Lambda returns configured tank volumes from HAL
    # Delta: Volume from LOW to HIGH (for normal daily feeding)
    # Total: Volume from EMPTY to HIGH (for reservoir change)
    lambda: |-
      char buf[80];
      float delta = id(hal)->getTankVolumeDelta();
      float total = id(hal)->getTotalTankVolume();
      snprintf(buf, sizeof(buf), "Delta: %.1fL (LOW→HIGH) | Total: %.1fL (EMPTY→HIGH)", delta, total);
      return {buf};
    # Update every 60 seconds (static configuration value)
    update_interval: 60s

  - platform: template
    name: "Current Time"
    id: current_time_text
    web_server:
      sorting_group_id: sg_status
      sorting_weight: 30
    # Lambda returns current time from SNTP
    lambda: |-
      auto time = id(sntp_time)->now();
      if (time.is_valid()) {
        char buf[64];
        snprintf(buf, sizeof(buf), "%04d-%02d-%02d %02d:%02d:%02d",
                 time.year, time.month, time.day_of_month,
                 time.hour, time.minute, time.second);
        return {buf};
      } else {
        return {"Not initialized"};
      }
    # Update every 1 second to show real-time clock
    update_interval: 1s

  - platform: template
    name: "Current Grow Day"
    id: current_grow_day_text
    web_server:
      sorting_group_id: sg_calendar
      sorting_weight: 10
    # Lambda returns current grow day from calendar manager
    lambda: |-
      uint8_t day = id(plant_calendar)->get_current_day();
      char buf[32];
      snprintf(buf, sizeof(buf), "Day %d / 120", day);
      return {buf};
    # Update every 60 seconds
    update_interval: 60s

################################################################################
# Button: Controller Management and Manual Routines
#
# Provides manual control over the system controller and PlantOS routines.
################################################################################
button:
  # === System Control & Restart ===
  - platform: restart
    name: "Reboot Device"
    id: restart_button
    web_server:
      sorting_group_id: sg_system
      sorting_weight: 10

  - platform: template
    name: "Set to INIT"
    web_server:
      sorting_group_id: sg_controller_actions
      sorting_weight: 40
    on_press:
      # Lambda action calls the unified controller's resetToInit() method
      # This triggers an immediate transition to INIT state (clears errors, resets FSM)
      then:
        - lambda: |-
            ESP_LOGI("button", "Reset Controller button pressed");
            id(unified_controller)->resetToInit();

  # === Operation Sequences ===
  # State: FEEDING
  - platform: template
    name: "Add Nutrients"
    web_server:
      sorting_group_id: sg_controller_actions
      sorting_weight: 50
    on_press:
      # Start nutrient dosing only (assumes tank is already filled)
      # State: FEEDING
      # Use when tank is already at correct level and just needs nutrients
      then:
        - lambda: |-
            ESP_LOGI("button", "========================================");
            ESP_LOGI("button", "ADD NUTRIENTS REQUESTED");
            ESP_LOGI("button", "State: FEEDING");
            ESP_LOGI("button", "========================================");
            id(unified_controller)->startFeeding();

  # States: WATER_FILLING -> PH_PROCESSING
  - platform: template
    name: "Fill Tank"
    web_server:
      sorting_group_id: sg_controller_actions
      sorting_weight: 60
    on_press:
      # Fill tank then check/correct pH
      # States: WATER_FILLING → PH_PROCESSING
      then:
        - lambda: |-
            ESP_LOGI("button", "========================================");
            ESP_LOGI("button", "FILL TANK REQUESTED");
            ESP_LOGI("button", "States: WATER_FILLING → PH_PROCESSING");
            ESP_LOGI("button", "========================================");
            id(unified_controller)->startFillTank();

  # State: WATER_EMPTYING
  - platform: template
    name: "Empty Tank"
    web_server:
      sorting_group_id: sg_controller_actions
      sorting_weight: 70
    on_press:
      # Drain tank until EMPTY sensor triggers
      # State: WATER_EMPTYING
      then:
        - lambda: |-
            ESP_LOGI("button", "========================================");
            ESP_LOGI("button", "EMPTY TANK REQUESTED");
            ESP_LOGI("button", "State: WATER_EMPTYING");
            ESP_LOGI("button", "========================================");
            id(unified_controller)->startEmptyTank();

  # States: FEED_FILLING -> FEEDING -> PH_PROCESSING
  - platform: template
    name: "Feed"
    web_server:
      sorting_group_id: sg_controller_actions
      sorting_weight: 80
    on_press:
      # Complete feeding operation: fill tank, add nutrients, correct pH
      # States: FEED_FILLING → FEEDING → PH_PROCESSING
      # Uses Tank Volume Delta for nutrient dosing
      then:
        - lambda: |-
            ESP_LOGI("button", "========================================");
            ESP_LOGI("button", "FEED OPERATION REQUESTED");
            ESP_LOGI("button", "States: FEED_FILLING → FEEDING → PH_PROCESSING");
            ESP_LOGI("button", "Using: Tank Volume Delta (normal feed)");
            ESP_LOGI("button", "========================================");
            id(unified_controller)->startFeed();

  # States: WATER_EMPTYING -> FEED_FILLING -> FEEDING -> PH_PROCESSING
  - platform: template
    name: "Reservoir Change"
    web_server:
      sorting_group_id: sg_controller_actions
      sorting_weight: 90
    on_press:
      # Complete reservoir change: empty, fill, add nutrients, correct pH
      # States: WATER_EMPTYING → FEED_FILLING → FEEDING → PH_PROCESSING
      # Uses Total Tank Volume for nutrient dosing
      then:
        - lambda: |-
            ESP_LOGI("button", "========================================");
            ESP_LOGI("button", "RESERVOIR CHANGE REQUESTED");
            ESP_LOGI("button", "States: WATER_EMPTYING → FEED_FILLING → FEEDING → PH_PROCESSING");
            ESP_LOGI("button", "Using: Total Tank Volume (reservoir change)");
            ESP_LOGI("button", "========================================");
            id(unified_controller)->startReservoirChange();

  - platform: template
    name: "Print Status Report"
    icon: "mdi:file-document-outline"
    web_server:
      sorting_group_id: sg_system
      sorting_weight: 15
    on_press:
      - lambda: id(unified_controller)->requestStatusReport();

  - platform: template
    name: "Reconnect WiFi"
    web_server:
      sorting_group_id: sg_system
      sorting_weight: 20
    on_press:
      # Force WiFi to disconnect and reconnect
      # Useful for troubleshooting mesh network connectivity issues
      then:
        - logger.log: "Forcing WiFi reconnection..."
        - wifi.disable:
        - delay: 2s
        - wifi.enable:
        - logger.log: "WiFi reconnection initiated"

  - platform: template
    name: "WiFi Scan"
    web_server:
      sorting_group_id: sg_system
      sorting_weight: 30
    on_press:
      then:
        - lambda: |-
            ESP_LOGI("wifi_scan", "=== WiFi Scan started ===");
            wifi_scan_config_t scan_config = {};
            scan_config.show_hidden = true;
            scan_config.scan_type = WIFI_SCAN_TYPE_ACTIVE;
            scan_config.scan_time.active.min = 50;
            scan_config.scan_time.active.max = 150;
            esp_err_t err = esp_wifi_scan_start(&scan_config, true);
            if (err != ESP_OK) {
              ESP_LOGE("wifi_scan", "Scan failed: %s", esp_err_to_name(err));
              return;
            }
            uint16_t ap_count = 0;
            esp_wifi_scan_get_ap_num(&ap_count);
            ESP_LOGI("wifi_scan", "Found: %d access points", ap_count);
            if (ap_count == 0) return;
            wifi_ap_record_t *ap_list = (wifi_ap_record_t*)malloc(ap_count * sizeof(wifi_ap_record_t));
            if (!ap_list) { ESP_LOGE("wifi_scan", "malloc failed"); return; }
            esp_wifi_scan_get_ap_records(&ap_count, ap_list);
            for (int i = 0; i < ap_count; i++) {
              ESP_LOGI("wifi_scan", "[%2d] SSID: %-32s  BSSID: %02X:%02X:%02X:%02X:%02X:%02X  RSSI: %4d dBm  Ch: %2d",
                       i + 1, (char*)ap_list[i].ssid,
                       ap_list[i].bssid[0], ap_list[i].bssid[1], ap_list[i].bssid[2],
                       ap_list[i].bssid[3], ap_list[i].bssid[4], ap_list[i].bssid[5],
                       (int)ap_list[i].rssi, ap_list[i].primary);
            }
            free(ap_list);
            ESP_LOGI("wifi_scan", "=== WiFi Scan complete ===");

  # === System State Control ===
  # All actuators OFF, calendar disabled
  - platform: template
    name: "Set to SHUTDOWN"
    web_server:
      sorting_group_id: sg_controller_actions
      sorting_weight: 10
    on_press:
      # Transition to SHUTDOWN state
      # - Turns off all actuators
      # - Disables calendar and time-based events
      # - Persists across power cycles
      # - Only "Set to IDLE" can exit this state
      then:
        - lambda: |-
            ESP_LOGI("button", "Set to SHUTDOWN button pressed");
            id(unified_controller)->setToShutdown();

  # Actuator states kept, calendar disabled
  - platform: template
    name: "Set to PAUSE"
    web_server:
      sorting_group_id: sg_controller_actions
      sorting_weight: 20
    on_press:
      # Transition to PAUSE state
      # - Maintains actuator states
      # - Disables calendar and time-based events
      # - Persists across power cycles
      # - Only "Set to IDLE" can exit this state
      then:
        - lambda: |-
            ESP_LOGI("button", "Set to PAUSE button pressed");
            id(unified_controller)->setToPause();

  - platform: template
    name: "Set to IDLE"
    web_server:
      sorting_group_id: sg_controller_actions
      sorting_weight: 30
    on_press:
      # Transition to IDLE state
      # - Only way to exit SHUTDOWN or PAUSE states
      # - Clears state persistence from NVS
      # - Re-enables calendar and time-based events
      then:
        - lambda: |-
            ESP_LOGI("button", "Set to IDLE button pressed");
            id(unified_controller)->setToIdle();

  # === Operations & Override ===
  # States: EC_PROCESSING -> EC_CALCULATING -> EC_FEEDING -> EC_MIXING -> EC_MEASURING -> PH_PROCESSING
  - platform: template
    name: "EC Correction"
    web_server:
      sorting_group_id: sg_controller_actions
      sorting_weight: 100
    on_press:
      then:
        - lambda: |-
            ESP_LOGI("button", "========================================");
            ESP_LOGI("button", "EC CORRECTION REQUESTED");
            ESP_LOGI("button", "States: EC_PROCESSING → EC_CALCULATING → EC_FEEDING → EC_MIXING → EC_MEASURING → PH_PROCESSING");
            ESP_LOGI("button", "========================================");
            id(unified_controller)->startEcCheck();

  # All pumps OFF immediately, then SHUTDOWN
  - platform: template
    name: "Emergency Stop"
    web_server:
      sorting_group_id: sg_controller_actions
      sorting_weight: 110
    on_press:
      then:
        - lambda: |-
            ESP_LOGW("button", "========================================");
            ESP_LOGW("button", "EMERGENCY STOP REQUESTED");
            ESP_LOGW("button", "All pumps OFF immediately → SHUTDOWN");
            ESP_LOGW("button", "========================================");
            id(unified_controller)->emergencyStop();

  # Nutrient mix for the mother plant, volume set via "Mother Mix Volume"
  - platform: template
    name: "Mother Plant Nutrients"
    web_server:
      sorting_group_id: sg_controller_actions
      sorting_weight: 120
    on_press:
      then:
        - lambda: |-
            float vol = id(mother_volume_liters).state;
            ESP_LOGI("button", "========================================");
            ESP_LOGI("button", "MOTHER PLANT NUTRIENT MIX REQUESTED");
            ESP_LOGI("button", "  Volume : %.1f L", vol);
            ESP_LOGI("button", "  Dose A : %.2f mL", vol * 1.44f);
            ESP_LOGI("button", "  Dose B : %.2f mL", vol * 0.96f);
            ESP_LOGI("button", "  Dose C : %.2f mL", vol * 0.48f);
            ESP_LOGI("button", "========================================");
            id(unified_controller)->startMotherNutrients(vol);

  # === Logging & Cleanup ===
  - platform: template
    name: "Clear PSM Alerts"
    web_server:
      sorting_group_id: sg_controller_actions
      sorting_weight: 140
    on_press:
      # Lambda action calls the PSM's clearEvent() method
      # This clears any critical events logged to NVS
      then:
        - lambda: |-
            id(psm)->clearEvent();

  # === Time & NTP ===
  - platform: template
    name: "Force NTP Sync"
    web_server:
      sorting_group_id: sg_system
      sorting_weight: 40
    on_press:
      then:
        - lambda: |-
            // SNTPComponent::update() is a no-op for USE_ESP_IDF; call setup() to properly
            // stop and restart SNTP (stops running daemon, reconfigures servers, re-inits).
            ESP_LOGW("ntp", "Force NTP sync — restarting SNTP daemon");
            ESP_LOGW("ntp", "  Time valid before restart: %s",
                     id(sntp_time)->now().is_valid() ? "YES" : "NO");
            id(sntp_time)->setup();
            ESP_LOGW("ntp", "  SNTP restarted — on_time_sync callback will fire when synced");

  # === pH & Measurement ===
  - platform: template
    name: "Start pH Calibration"
    web_server:
      sorting_group_id: sg_controller_settings
      sorting_weight: 200
    on_press:
      # Start 3-point pH calibration sequence
      # Calibration points: 4.00 (low), 7.00 (mid), 10.01 (high)
      # Follow serial log prompts to insert probe into each buffer solution
      then:
        - lambda: |-
            ESP_LOGI("button", "Start pH Calibration button pressed");
            id(unified_controller)->startPhCalibration();

  - platform: template
    name: "Start pH Correction"
    web_server:
      sorting_group_id: sg_controller_actions
      sorting_weight: 130
    on_press:
      # Start the full pH correction sequence
      # Includes measurement, calculation, dosing, and mixing
      then:
        - lambda: |-
            id(unified_controller)->startPhCorrection();

  # === pH Temperature Compensation ===
  - platform: template
    name: "pH Temp Compensation (Auto)"
    web_server:
      sorting_group_id: sg_controller_settings
      sorting_weight: 220
    on_press:
      # Read current water temperature and send to EZO pH sensor
      # This ensures pH readings are compensated for current temperature
      then:
        - logger.log: "Reading current water temperature for pH compensation"
        - lambda: |-
            if (id(hal)->hasTemperature()) {
              float temp = id(hal)->readTemperature();
              ESP_LOGI("button", "Sending temperature compensation: %.1f°C", temp);
              if (id(hal)->sendPhTemperatureCompensation(temp)) {
                ESP_LOGI("button", "Temperature compensation successful");
              } else {
                ESP_LOGE("button", "Temperature compensation failed");
              }
            } else {
              ESP_LOGE("button", "Temperature sensor not available");
            }

  - platform: template
    name: "pH Temp Compensation (Manual)"
    web_server:
      sorting_group_id: sg_controller_settings
      sorting_weight: 230
    on_press:
      # Manual temperature compensation for testing or when temp sensor fails
      # Default: 19.5°C (typical hydroponic solution temperature)
      then:
        - logger.log: "Sending manual temperature compensation (19.5°C)"
        - lambda: |-
            float manual_temp = 19.5;  // Default temperature
            ESP_LOGI("button", "Sending manual temperature compensation: %.1f°C", manual_temp);
            if (id(hal)->sendPhTemperatureCompensation(manual_temp)) {
              ESP_LOGI("button", "Manual temperature compensation successful");
            } else {
              ESP_LOGE("button", "Manual temperature compensation failed");
            }

  - platform: template
    name: "Check pH Calibration Status"
    web_server:
      sorting_group_id: sg_controller_settings
      sorting_weight: 210
    on_press:
      # Query EZO pH sensor calibration status
      # Returns number of calibration points: 0, 1, 2, or 3
      # 3 points = fully calibrated (mid, low, high)
      then:
        - logger.log: "Querying EZO pH calibration status (Cal,?)"
        - lambda: |-
            id(hal)->queryPhCalibrationStatus();

  # === EC Calibration ===
  - platform: template
    name: "Start EC Calibration"
    web_server:
      sorting_group_id: sg_controller_settings
      sorting_weight: 240
    on_press:
      then:
        - lambda: |-
            id(unified_controller)->setEcCalibrationTarget(id(ec_calibration_target).state);
            id(unified_controller)->startEcCalibration();

  # Resets the EC calibration factor back to 1.0
  - platform: template
    name: "Reset EC Calibration"
    web_server:
      sorting_group_id: sg_controller_settings
      sorting_weight: 260
    on_press:
      then:
        - lambda: id(unified_controller)->resetEcCalibration();

  # === Actuator Timed Tests ===
  - platform: template
    name: "Test Magnetic Valve (3s)"
    web_server:
      sorting_group_id: sg_actuators
      sorting_weight: 110
    on_press:
      # Turn ON magnetic valve for 3 seconds, then auto turn OFF
      # Maps to "WaterValve" actuator ID
      then:
        - lambda: |-
            ESP_LOGI("button", "Testing Magnetic Valve for 3 seconds");
            if (id(actuator_safety)->executeCommand("WaterValve", true, 10)) {
              ESP_LOGI("button", "Magnetic Valve ON - will auto turn OFF after 3s");
            } else {
              ESP_LOGW("button", "Magnetic Valve test command rejected");
            }
        - delay: 3s
        - lambda: |-
            if (id(actuator_safety)->executeCommand("WaterValve", false)) {
              ESP_LOGI("button", "Magnetic Valve auto-OFF after 3s");
            }

  - platform: template
    name: "Test pH Pump (10s)"
    web_server:
      sorting_group_id: sg_actuators
      sorting_weight: 120
    on_press:
      # Turn ON pH pump for 10 seconds at current PWM slider value
      # Maps to "AcidPump" actuator ID
      then:
        - lambda: |-
            // PWM comes from the configured value (set via the "Acid Pump PWM" slider)
            float pwm_percent = id(hal)->getPumpConfig("AcidPump").pwm_intensity * 100.0f;

            // Log calibration instructions
            ESP_LOGI("button", "=== pH Pump Calibration Test ===");
            ESP_LOGI("button", "Test run started (10s) at %.0f%% PWM", pwm_percent);
            ESP_LOGI("button", "Please measure the volume in mL.");
            ESP_LOGI("button", "After measurement: Divide mL by 10 to get mL/s flow rate.");
            ESP_LOGI("button", "Update 'pump_ph_flow_rate_ml_s' and the 'Acid Pump PWM' slider.");

            // Turn on pump (PWM intensity read from config inside HAL)
            id(hal)->setPump("AcidPump", true);

        - delay: 10s
        - lambda: |-
            // Turn off pump
            id(hal)->setPump("AcidPump", false);
            ESP_LOGI("button", "pH Pump auto-OFF after 10s");
            ESP_LOGI("button", "================================");

  - platform: template
    name: "Test Grow Pump (10s)"
    web_server:
      sorting_group_id: sg_actuators
      sorting_weight: 130
    on_press:
      # Turn ON grow pump for 10 seconds at current PWM slider value
      # Maps to "NutrientPumpA" actuator ID
      then:
        - lambda: |-
            // PWM comes from the configured value (set via the "Grow Pump PWM" slider)
            float pwm_percent = id(hal)->getPumpConfig("NutrientPumpA").pwm_intensity * 100.0f;

            // Log calibration instructions
            ESP_LOGI("button", "=== Grow Pump Calibration Test ===");
            ESP_LOGI("button", "Test run started (10s) at %.0f%% PWM", pwm_percent);
            ESP_LOGI("button", "Please measure the volume in mL.");
            ESP_LOGI("button", "After measurement: Divide mL by 10 to get mL/s flow rate.");
            ESP_LOGI("button", "Update 'pump_grow_flow_rate_ml_s' and the 'Grow Pump PWM' slider.");

            // Turn on pump (PWM intensity read from config inside HAL)
            id(hal)->setPump("NutrientPumpA", true);

        - delay: 10s
        - lambda: |-
            // Turn off pump
            id(hal)->setPump("NutrientPumpA", false);
            ESP_LOGI("button", "Grow Pump auto-OFF after 10s");
            ESP_LOGI("button", "===================================");

  - platform: template
    name: "Test Micro Pump (10s)"
    web_server:
      sorting_group_id: sg_actuators
      sorting_weight: 140
    on_press:
      # Turn ON micro pump for 10 seconds at current PWM slider value
      # Maps to "NutrientPumpB" actuator ID
      then:
        - lambda: |-
            // PWM comes from the configured value (set via the "Micro Pump PWM" slider)
            float pwm_percent = id(hal)->getPumpConfig("NutrientPumpB").pwm_intensity * 100.0f;

            // Log calibration instructions
            ESP_LOGI("button", "=== Micro Pump Calibration Test ===");
            ESP_LOGI("button", "Test run started (10s) at %.0f%% PWM", pwm_percent);
            ESP_LOGI("button", "Please measure the volume in mL.");
            ESP_LOGI("button", "After measurement: Divide mL by 10 to get mL/s flow rate.");
            ESP_LOGI("button", "Update 'pump_micro_flow_rate_ml_s' and the 'Micro Pump PWM' slider.");

            // Turn on pump (PWM intensity read from config inside HAL)
            id(hal)->setPump("NutrientPumpB", true);

        - delay: 10s
        - lambda: |-
            // Turn off pump
            id(hal)->setPump("NutrientPumpB", false);
            ESP_LOGI("button", "Micro Pump auto-OFF after 10s");
            ESP_LOGI("button", "====================================");

  - platform: template
    name: "Test Bloom Pump (10s)"
    web_server:
      sorting_group_id: sg_actuators
      sorting_weight: 150
    on_press:
      # Turn ON bloom pump for 10 seconds at current PWM slider value
      # Maps to "NutrientPumpC" actuator ID
      then:
        - lambda: |-
            // PWM comes from the configured value (set via the "Bloom Pump PWM" slider)
            float pwm_percent = id(hal)->getPumpConfig("NutrientPumpC").pwm_intensity * 100.0f;

            // Log calibration instructions
            ESP_LOGI("button", "=== Bloom Pump Calibration Test ===");
            ESP_LOGI("button", "Test run started (10s) at %.0f%% PWM", pwm_percent);
            ESP_LOGI("button", "Please measure the volume in mL.");
            ESP_LOGI("button", "After measurement: Divide mL by 10 to get mL/s flow rate.");
            ESP_LOGI("button", "Update 'pump_bloom_flow_rate_ml_s' and the 'Bloom Pump PWM' slider.");

            // Turn on pump (PWM intensity read from config inside HAL)
            id(hal)->setPump("NutrientPumpC", true);

        - delay: 10s
        - lambda: |-
            // Turn off pump
            id(hal)->setPump("NutrientPumpC", false);
            ESP_LOGI("button", "Bloom Pump auto-OFF after 10s");
            ESP_LOGI("button", "====================================");

  # === Precision Dosing Tests (2cl/20mL) ===
  - platform: template
    name: "Test Grow Pump (2cl = 20mL)"
    web_server:
      sorting_group_id: sg_actuators
      sorting_weight: 210
    on_press:
      # Test precise volume output: 2cl (20mL) from Grow Pump
      # Uses HAL pumpflow() to convert mL to seconds based on calibration
      then:
        - lambda: |-
            // Use HAL pumpflow to calculate duration for 20mL
            float target_ml = 20.0f;
            float duration_s = id(hal)->pumpflow("NutrientPumpA", target_ml);

            ESP_LOGI("button", "=== Grow Pump 2cl Test ===");
            ESP_LOGI("button", "Target: %.1f mL (2cl)", target_ml);
            ESP_LOGI("button", "Calculated duration: %.2f seconds", duration_s);
            ESP_LOGI("button", "Using configured PWM and flow rate from HAL");

            // Turn on pump using configured PWM intensity
            id(hal)->setPump("NutrientPumpA", true);

        # Wait for calculated duration (convert to milliseconds)
        - delay: !lambda "return (uint32_t)(id(hal)->pumpflow(\"NutrientPumpA\", 20.0f) * 1000);"

        - lambda: |-
            // Turn off pump
            id(hal)->setPump("NutrientPumpA", false);
            ESP_LOGI("button", "Grow Pump OFF - 2cl test complete");
            ESP_LOGI("button", "Please verify 20mL was dispensed");
            ESP_LOGI("button", "==========================");

  - platform: template
    name: "Test pH Pump (2cl = 20mL)"
    web_server:
      sorting_group_id: sg_actuators
      sorting_weight: 220
    on_press:
      # Test precise volume output: 2cl (20mL) from pH Pump
      # Uses HAL pumpflow() to convert mL to seconds based on calibration
      then:
        - lambda: |-
            // Use HAL pumpflow to calculate duration for 20mL
            float target_ml = 20.0f;
            float duration_s = id(hal)->pumpflow("AcidPump", target_ml);

            ESP_LOGI("button", "=== pH Pump 2cl Test ===");
            ESP_LOGI("button", "Target: %.1f mL (2cl)", target_ml);
            ESP_LOGI("button", "Calculated duration: %.2f seconds", duration_s);
            ESP_LOGI("button", "Using configured PWM and flow rate from HAL");

            // Turn on pump using configured PWM intensity
            id(hal)->setPump("AcidPump", true);

        # Wait for calculated duration (convert to milliseconds)
        - delay: !lambda "return (uint32_t)(id(hal)->pumpflow(\"AcidPump\", 20.0f) * 1000);"

        - lambda: |-
            // Turn off pump
            id(hal)->setPump("AcidPump", false);
            ESP_LOGI("button", "pH Pump OFF - 2cl test complete");
            ESP_LOGI("button", "Please verify 20mL was dispensed");
            ESP_LOGI("button", "==========================");

  - platform: template
    name: "Test Micro Pump (2cl = 20mL)"
    web_server:
      sorting_group_id: sg_actuators
      sorting_weight: 230
    on_press:
      # Test precise volume output: 2cl (20mL) from Micro Pump
      # Uses HAL pumpflow() to convert mL to seconds based on calibration
      then:
        - lambda: |-
            // Use HAL pumpflow to calculate duration for 20mL
            float target_ml = 20.0f;
            float duration_s = id(hal)->pumpflow("NutrientPumpB", target_ml);

            ESP_LOGI("button", "=== Micro Pump 2cl Test ===");
            ESP_LOGI("button", "Target: %.1f mL (2cl)", target_ml);
            ESP_LOGI("button", "Calculated duration: %.2f seconds", duration_s);
            ESP_LOGI("button", "Using configured PWM and flow rate from HAL");

            // Turn on pump using configured PWM intensity
            id(hal)->setPump("NutrientPumpB", true);

        # Wait for calculated duration (convert to milliseconds)
        - delay: !lambda "return (uint32_t)(id(hal)->pumpflow(\"NutrientPumpB\", 20.0f) * 1000);"

        - lambda: |-
            // Turn off pump
            id(hal)->setPump("NutrientPumpB", false);
            ESP_LOGI("button", "Micro Pump OFF - 2cl test complete");
            ESP_LOGI("button", "Please verify 20mL was dispensed");
            ESP_LOGI("button", "==========================");

  - platform: template
    name: "Test Bloom Pump (2cl = 20mL)"
    web_server:
      sorting_group_id: sg_actuators
      sorting_weight: 240
    on_press:
      # Test precise volume output: 2cl (20mL) from Bloom Pump
      # Uses HAL pumpflow() to convert mL to seconds based on calibration
      then:
        - lambda: |-
            // Use HAL pumpflow to calculate duration for 20mL
            float target_ml = 20.0f;
            float duration_s = id(hal)->pumpflow("NutrientPumpC", target_ml);

            ESP_LOGI("button", "=== Bloom Pump 2cl Test ===");
            ESP_LOGI("button", "Target: %.1f mL (2cl)", target_ml);
            ESP_LOGI("button", "Calculated duration: %.2f seconds", duration_s);
            ESP_LOGI("button", "Using configured PWM and flow rate from HAL");

            // Turn on pump using configured PWM intensity
            id(hal)->setPump("NutrientPumpC", true);

        # Wait for calculated duration (convert to milliseconds)
        - delay: !lambda "return (uint32_t)(id(hal)->pumpflow(\"NutrientPumpC\", 20.0f) * 1000);"

        - lambda: |-
            // Turn off pump
            id(hal)->setPump("NutrientPumpC", false);
            ESP_LOGI("button", "Bloom Pump OFF - 2cl test complete");
            ESP_LOGI("button", "Please verify 20mL was dispensed");
            ESP_LOGI("button", "==========================");

  # === Calendar Day Control ===
  - platform: template
    name: "Calendar Day +1"
    web_server:
      sorting_group_id: sg_calendar
      sorting_weight: 20
    on_press:
      # Advance calendar to next day
      # Useful for manually advancing grow cycle or skipping days
      then:
        - lambda: |-
            ESP_LOGI("button", "Calendar Day +1 button pressed");
            if (id(plant_calendar)->advance_day()) {
              ESP_LOGI("button", "Advanced to day %d", id(plant_calendar)->get_current_day());
              // Update text sensor immediately
              id(current_grow_day_text).update();
            } else {
              ESP_LOGE("button", "Failed to advance calendar day");
            }

  - platform: template
    name: "Calendar Day -1"
    web_server:
      sorting_group_id: sg_calendar
      sorting_weight: 30
    on_press:
      # Go back to previous calendar day
      # Useful for extending a growth phase or correcting accidental advances
      then:
        - lambda: |-
            ESP_LOGI("button", "Calendar Day -1 button pressed");
            if (id(plant_calendar)->go_back_day()) {
              ESP_LOGI("button", "Went back to day %d", id(plant_calendar)->get_current_day());
              // Update text sensor immediately
              id(current_grow_day_text).update();
            } else {
              ESP_LOGE("button", "Failed to go back calendar day");
            }

################################################################################
# PlantOS HAL (Hardware Abstraction Layer) - Layer 3
#
# Provides platform-agnostic hardware interface for the unified Controller.
# Phase 2 implementation - hardware actuators connected.
################################################################################
plantos_hal:
  id: hal
  system_led: system_led
  ph_sensor: ph_sensor_real  # Real EZO pH UART sensor with filtering
  ph_sensor_component: ezo_ph_uart_component  # EZO pH UART component for calibration and direct readings
  temperature_sensor: water_temperature  # DS18B20 temperature sensor on GPIO3 (WTR_TEMP)
  ec_sensor: ec_sensor                   # TDS/EC sensor (KS0429 via ADC on GPIO0)
  tds_sensor_component: ec_sensor        # TDS sensor component for EC calibration factor (NVS)
  water_level_high_sensor: water_level_high_sensor  # XKC-Y23-V capacitive sensor on GPIO17 (WTR_HI)
  water_level_low_sensor: water_level_low_sensor  # XKC-Y23-V capacitive sensor on GPIO23 (WTR_LO - auto-feed trigger level)
  water_level_empty_sensor: water_level_empty_sensor  # XKC-Y23-V capacitive sensor on GPIO22 (WTR_Empty - minimum safe level)
  time_source: sntp_time  # SNTP time source for clock-based scheduling

  # Actuator GPIO Outputs (Phase 2: Hardware Control - 5 GPIO actuators)
  # NOTE: Using outputs instead of switches to avoid circular dependency
  # Pump Mapping: Grow=NutrientPumpA, Micro=NutrientPumpB, Bloom=NutrientPumpC
  mag_valve_output: mag_valve_output        # GPIO1 - Magnetic valve (fresh water inlet) - MagValve on PCB
  pump_ph_output: pump_ph_output            # GPIO4 - pH pump (acid dosing) - PP_1 on PCB
  pump_grow_output: pump_grow_output        # GPIO5 - Grow pump (NutrientPumpA → nutrient_A_ml_per_liter) - PP_2 on PCB
  pump_micro_output: pump_micro_output      # GPIO6 - Micro pump (NutrientPumpB → nutrient_B_ml_per_liter) - PP_3 on PCB
  pump_bloom_output: pump_bloom_output      # GPIO7 - Bloom pump (NutrientPumpC → nutrient_C_ml_per_liter) - PP_4 on PCB

  # Shelly HTTP Switches (MVP: AirPump, WastewaterPump, GrowLight via Shelly Plus 4PM @ 192.168.0.130)
  air_pump_switch: air_pump_shelly_switch           # Shelly Socket 0 - Air pump for pH mixing
  wastewater_pump_switch: wastewater_pump_shelly_switch  # Shelly Socket 2 - Tank drainage
  grow_light_switch: grow_light_shelly_switch       # Shelly Socket 3 - Grow light

  # ActuatorSafetyGate reference (for state sync on Shelly poll - consolidated HTTP)
  actuator_safety_gate: actuator_safety

  # Tank Volume Configuration (for mL/L dosing calculations)
  # Tank Volume Delta: Measured volume between LOW and HIGH water level sensors
  # Used for normal daily feeding operations (auto-feed fills from LOW to HIGH)
  tank_volume_delta_liters: 27.4    # Volume from LOW to HIGH sensors | 57x37x13cm = 27.417L

  # Total Tank Volume: Measured volume from EMPTY to HIGH water level sensors
  # Used for complete reservoir change operations (drains to EMPTY, refills to HIGH)
  total_tank_volume_liters: 47.5    # Volume from EMPTY to HIGH sensors | 57x37x22.5cm = 47.498L

  # Magnetic Valve Flow Rate (for automated water addition)
  # IMPORTANT: Calibrate using 10s test button (even though valve is ON/OFF only)
  mag_valve_flow_rate_ml_s: 100.0    # Magnetic valve: mL/second when OPEN (CALIBRATED 2026-06-06: 300mL/3s)

  # Pump Calibration Configuration (flow rates and PWM intensities)
  # IMPORTANT: Update these values after calibration using 10s test buttons
  # Formula: flow_rate_ml_s = (measured_mL) / 10
  # Pump Mapping: Grow=NutrientPumpA, Micro=NutrientPumpB, Bloom=NutrientPumpC
  pump_ph_flow_rate_ml_s: 2.35        # pH pump: mL/second @ configured PWM (CALIBRATED 2026-06-06: 23.5mL/10s @ 100%)
  pump_ph_pwm_intensity: 100%        # pH pump: PWM intensity (0-100%, CALIBRATED: 100%@5V)
  pump_grow_flow_rate_ml_s: 1.75     # Grow pump (NutrientPumpA): mL/second @ configured PWM (CALIBRATED 2026-06-06: 17.5mL/10s @ 100%)
  pump_grow_pwm_intensity: 100%      # Grow pump (NutrientPumpA): PWM intensity (0-100%, CALIBRATED: 100%@5V)
  pump_micro_flow_rate_ml_s: 0.75    # Micro pump (NutrientPumpB): mL/second @ configured PWM (CALIBRATED 2026-06-06: 7.5mL/10s @ 100%)
  pump_micro_pwm_intensity: 100%     # Micro pump (NutrientPumpB): PWM intensity (0-100%, CALIBRATED: 100%@5V)
  pump_bloom_flow_rate_ml_s: 0.75    # Bloom pump (NutrientPumpC): mL/second @ configured PWM (CALIBRATED 2026-06-06: 7.5mL/10s @ 100%)
  pump_bloom_pwm_intensity: 100%     # Bloom pump (NutrientPumpC): PWM intensity (0-100%, CALIBRATED: 100%@5V)

  # pH Reading Configuration
  ph_reading_interval: 2h     # How often to check pH (default: 2 hours)
  ph_min: 5.5                  # Lower pH threshold (default: 5.5)
  ph_max: 6.2                  # Upper pH threshold (default: 6.2)
                               # If pH is outside this range, controller will
                               # transition to PH_PROCESSING state and decide
                               # whether to start pH correction

################################################################################
# PlantOS Unified Controller (Layer 1) - Phase 8
#
# Unified controller managing:
# - System FSM with 12 states
# - LED behaviors via LedBehaviorSystem
# - HAL integration for sensors/LED
# - SafetyGate integration for actuators
# - StatusLogger (owned internally, not injected)
# - PSM integration for crash recovery
#
# Architecture: Controller → SafetyGate → HAL → Hardware
################################################################################
alert_service:
  id: alerts

plantos_controller:
  id: unified_controller
  hal: hal                       # Hardware abstraction layer
  safety_gate: actuator_safety   # Actuator control with safety enforcement
  persistence: psm               # Persistent state manager for crash recovery
  calendar: plant_calendar       # Calendar manager for grow schedule and nutrient dosing
  time_source: sntp_time         # NTP time source for automatic day calculation
  alert_service: alerts          # Alert dispatching (log backend; future: Telegram, HA)

  # Grow Cycle Configuration
  # grow_start_date: Date when grow cycle day 1 started (YYYY-MM-DD format)
  # Controller calculates current day by comparing NTP time to this start date
  # Example: "2025-12-30" means Dec 30, 2025 is day 1 of the 120-day cycle
  # If not set, falls back to calendar manager's manual day counter (NVS-persisted)
  grow_start_date: "2025-12-30"

  # Night Mode Configuration
  night_mode_enabled: true      # Night mode enabled by default (22:00–09:00)
  night_mode_start_hour: 22     # Hour when night mode starts (0-23, default: 22 = 10 PM)
  night_mode_end_hour: 9        # Hour when night mode ends (0-23, default: 9 = 9 AM)
                                # During night mode: no pH correction, feeding, or water filling

  # Status Logger Configuration
  enable_status_reports: false  # Enable/disable periodic status reports (default: false, use "System Status Reports" switch)
  status_report_interval: 60s   # How often to print status reports (default: 30s)
  verbose_mode: false           # Enable instant verbose logging of all events (default: false)
                                # Verbose mode logs state changes, sensor readings, and actuator
                                # commands in real-time without waiting for periodic reports.
                                # Note: LED changes are automatically filtered out.
  enable_420_mode: true         # Enable 420 easter egg at 4:20 AM/PM (default: true)
                                # When enabled, displays ASCII art in status logs at 4:20

  # Enhanced Error Handling Configuration
  enhanced_error_handling: true # Enable enhanced error handling with retry logic (default: false)
                                # When enabled: duration adaptation, sensor retry with exponential
                                # backoff, comprehensive 4-part error messages, and RESOLVED state
                                # tracking. Disable for backward-compatible legacy behavior.

  # pH Dosing K-Factor
  # dose_ml = (current_pH - 5.85) × tank_L × K
  # Increase if pH corrections are too small; decrease if overdosing.
  # The EMA learning will refine this value automatically over time.
  ph_k_factor: 0.25

# Actuator Safety Gate (Layer 2) - Debouncing, Duration Limits, Soft-Start/Stop
# See components/actuator_safety_gate/README.md for complete documentation.
actuator_safety_gate:
  id: actuator_safety
  hal: hal  # Phase 2: Inject HAL dependency for hardware control

################################################################################
# EZO pH Sensor Component via I2C (Atlas Scientific)
#
# Production pH sensor using I2C communication with Atlas Scientific EZO circuit.
# Default I2C address: 0x61.
#
# Hardware Requirements:
# - Atlas Scientific EZO pH Circuit (UART mode)
# - pH probe (included with EZO kit)
# - UART connection to ESP32-C6 (TX=GPIO18, RX=GPIO19 via uart_bus)
# - ADUM1201 isolator: one channel per direction (TX→EZO, EZO→RX)
#
# Calibration:
# - Use ESPHome API services to calibrate (see api section)
# - Mid-point: pH 7.00 buffer solution (required first)
# - Low-point: pH 4.00 buffer solution (optional)
# - High-point: pH 10.00 buffer solution (optional)
#
# Temperature Compensation:
# - Configure temperature_compensation parameter below
# - Links to a temperature sensor for improved accuracy
# - Improves accuracy from ±0.1 pH to ±0.02 pH
#
# UART Protocol Details:
# - ASCII text commands terminated with \r
# - 300ms response delay required after each command (handled internally)
# - Baud rate: 9600
################################################################################
ezo_ph_uart:
  id: ezo_ph_uart_component
  uart_id: uart_bus
  update_interval: 5s
  verbose: false
  ph:
    name: "Nutrient Solution pH"
    id: ph_sensor_real
    accuracy_decimals: 2
    web_server:
      sorting_group_id: sg_sensors
      sorting_weight: 10
    filters:
      - sliding_window_moving_average:
          window_size: 5
          send_every: 1
      - lambda: |-
          if (x < 0.0 || x > 14.0) {
            ESP_LOGW("ezo_ph_uart", "pH value out of typical range: %.2f", x);
            return {};
          }
          return x;

  temperature_compensation: water_temperature

################################################################################
# Persistent State Manager - NVS-Based Critical Event Logging
#
# Manages critical event persistence across power cycles and crashes.
# Essential for operations that could cause damage if interrupted:
# - Chemical dosing (acid/base pumps)
# - Watering/valve operations
# - Calibration sequences
# - Any long-running critical process
#
# Features:
# - NVS (Non-Volatile Storage) persistence survives power loss
# - Time-based event age validation (requires NTP sync)
# - Recovery detection on boot
# - Atomic save/load operations
#
# Usage Example:
#   // Before starting critical operation
#   id(psm).logEvent("DOSING_ACID", 0);  // Status 0 = STARTED
#   turnOnAcidPump();
#
#   // After completing operation
#   turnOffAcidPump();
#   id(psm).clearEvent();  // Clear - operation completed
#
#   // On boot - check for recovery
#   if (id(psm).wasInterrupted(60)) {  // Within last 60 seconds
#       // Take recovery action (turn off pumps, etc.)
#   }
################################################################################
persistent_state_manager:
  id: psm

################################################################################
# WDT Manager - Hardware Watchdog Timer Management
#
# Manages the ESP32 hardware watchdog timer (WDT) to detect and recover from
# system hangs or crashes. The WDT must be regularly "fed" to indicate the
# system is healthy. If feeding stops, the WDT automatically resets the device.
#
# Features:
# - Hardware WDT initialization with 10-second timeout
# - Regular WDT feeding every 500ms during normal operation
# - Test mode: Simulates crash after 20 seconds to verify automatic reset
# - Non-blocking operation using millis() timing
#
# Configuration:
# - timeout: WDT timeout period (10 seconds)
# - feed_interval: How often to feed WDT (500ms)
# - test_mode: Enable crash simulation (true for testing)
# - crash_delay: Time before simulated crash (20 seconds)
#
# Expected Behavior (Test Mode):
# 1. Boot: "WDT initialized successfully"
# 2. 0-20s: Regular "WDT fed" messages every 500ms
# 3. 20s: "SIMULATED CRASH - Stopping WDT feeding"
# 4. ~30s: WDT timeout triggers automatic reboot
# 5. Device reboots and cycle repeats
#
# For Production: Set test_mode: false to disable crash simulation
################################################################################
wdt_manager:
  id: my_wdt
  timeout: 20s           # WDT timeout: 20 seconds (increased for 15s HTTP timeout)
  feed_interval: 500ms   # Feed WDT every 500 milliseconds
  test_mode: false        # Enable crash simulation for testing
  crash_delay: 20s       # Simulate crash after 20 seconds

################################################################################
# CalendarManager - Daily Schedule Management for 120-Day Grow Cycle
#
# Manages target pH values and nutrient dosing durations for each day.
# Current day is persisted to NVS and survives power cycles.
################################################################################
calendar_manager:
  id: plant_calendar

  # Safe mode: Disable automated time-based routines (manual control still works)
  safe_mode: false

  # Verbose mode: Enable detailed logging of all operations
  verbose: false

  # Status log interval: How often to report current day and schedule
  status_log_interval: 10min

  # Schedule JSON: 120-day schedule (currently showing days 1-5 as example)
  # Full production schedule would contain all 120 days
  # Doses are specified in mL per liter of tank volume (mL/L)
  # Actual mL dose = dose_mL_per_L × tank_volume_L
  # Example: For 10L tank with dose_A_ml_per_L = 1.5 → 15 mL actual dose
  schedule_json: >-
    [
    {"day": 1,   "ph_min": 5.8, "ph_max": 6.2, "dose_A_ml_per_L": 0.8,  "dose_B_ml_per_L": 0.8,  "dose_C_ml_per_L": 0.8,  "light_on_time": 960, "light_off_time": 480, "ec_target": 0.50, "ec_tolerance": 0.10},
    {"day": 2,   "ph_min": 5.8, "ph_max": 6.2, "dose_A_ml_per_L": 0.8,  "dose_B_ml_per_L": 0.8,  "dose_C_ml_per_L": 0.8,  "light_on_time": 960, "light_off_time": 480, "ec_target": 0.50, "ec_tolerance": 0.10},
    {"day": 3,   "ph_min": 5.8, "ph_max": 6.2, "dose_A_ml_per_L": 0.8,  "dose_B_ml_per_L": 0.8,  "dose_C_ml_per_L": 0.8,  "light_on_time": 960, "light_off_time": 480, "ec_target": 0.50, "ec_tolerance": 0.10},
    {"day": 4,   "ph_min": 5.8, "ph_max": 6.2, "dose_A_ml_per_L": 0.8,  "dose_B_ml_per_L": 0.8,  "dose_C_ml_per_L": 0.8,  "light_on_time": 960, "light_off_time": 480, "ec_target": 0.50, "ec_tolerance": 0.10},
    {"day": 5,   "ph_min": 5.8, "ph_max": 6.2, "dose_A_ml_per_L": 0.8,  "dose_B_ml_per_L": 0.8,  "dose_C_ml_per_L": 0.8,  "light_on_time": 960, "light_off_time": 480, "ec_target": 0.50, "ec_tolerance": 0.10},
    {"day": 6,   "ph_min": 5.8, "ph_max": 6.2, "dose_A_ml_per_L": 0.8,  "dose_B_ml_per_L": 0.8,  "dose_C_ml_per_L": 0.8,  "light_on_time": 960, "light_off_time": 480, "ec_target": 0.50, "ec_tolerance": 0.10},
    {"day": 7,   "ph_min": 5.8, "ph_max": 6.2, "dose_A_ml_per_L": 0.8,  "dose_B_ml_per_L": 0.8,  "dose_C_ml_per_L": 0.8,  "light_on_time": 960, "light_off_time": 480, "ec_target": 0.50, "ec_tolerance": 0.10},
    {"day": 8,   "ph_min": 5.8, "ph_max": 6.2, "dose_A_ml_per_L": 1.01, "dose_B_ml_per_L": 0.85, "dose_C_ml_per_L": 0.69, "light_on_time": 960, "light_off_time": 480, "ec_target": 0.80, "ec_tolerance": 0.20},
    {"day": 9,   "ph_min": 5.8, "ph_max": 6.2, "dose_A_ml_per_L": 1.23, "dose_B_ml_per_L": 0.91, "dose_C_ml_per_L": 0.59, "light_on_time": 960, "light_off_time": 480, "ec_target": 0.80, "ec_tolerance": 0.20},
    {"day": 10,  "ph_min": 5.8, "ph_max": 6.2, "dose_A_ml_per_L": 1.44, "dose_B_ml_per_L": 0.96, "dose_C_ml_per_L": 0.48, "light_on_time": 960, "light_off_time": 480, "ec_target": 0.80, "ec_tolerance": 0.20},
    {"day": 11,  "ph_min": 5.8, "ph_max": 6.2, "dose_A_ml_per_L": 1.44, "dose_B_ml_per_L": 0.96, "dose_C_ml_per_L": 0.48, "light_on_time": 960, "light_off_time": 480, "ec_target": 1.20, "ec_tolerance": 0.20},
    {"day": 12,  "ph_min": 5.8, "ph_max": 6.2, "dose_A_ml_per_L": 1.44, "dose_B_ml_per_L": 0.96, "dose_C_ml_per_L": 0.48, "light_on_time": 960, "light_off_time": 480, "ec_target": 1.20, "ec_tolerance": 0.20},
    {"day": 13,  "ph_min": 5.8, "ph_max": 6.2, "dose_A_ml_per_L": 1.44, "dose_B_ml_per_L": 0.96, "dose_C_ml_per_L": 0.48, "light_on_time": 960, "light_off_time": 480, "ec_target": 1.20, "ec_tolerance": 0.20},
    {"day": 14,  "ph_min": 5.8, "ph_max": 6.2, "dose_A_ml_per_L": 1.44, "dose_B_ml_per_L": 0.96, "dose_C_ml_per_L": 0.48, "light_on_time": 960, "light_off_time": 480, "ec_target": 1.20, "ec_tolerance": 0.20},
    {"day": 15,  "ph_min": 5.8, "ph_max": 6.2, "dose_A_ml_per_L": 1.44, "dose_B_ml_per_L": 0.96, "dose_C_ml_per_L": 0.48, "light_on_time": 960, "light_off_time": 480, "ec_target": 1.60, "ec_tolerance": 0.20},
    {"day": 16,  "ph_min": 5.8, "ph_max": 6.2, "dose_A_ml_per_L": 1.44, "dose_B_ml_per_L": 0.96, "dose_C_ml_per_L": 0.48, "light_on_time": 960, "light_off_time": 480, "ec_target": 1.60, "ec_tolerance": 0.20},
    {"day": 17,  "ph_min": 5.8, "ph_max": 6.2, "dose_A_ml_per_L": 1.44, "dose_B_ml_per_L": 0.96, "dose_C_ml_per_L": 0.48, "light_on_time": 960, "light_off_time": 480, "ec_target": 1.60, "ec_tolerance": 0.20},
    {"day": 18,  "ph_min": 5.8, "ph_max": 6.2, "dose_A_ml_per_L": 1.44, "dose_B_ml_per_L": 0.96, "dose_C_ml_per_L": 0.48, "light_on_time": 960, "light_off_time": 480, "ec_target": 1.60, "ec_tolerance": 0.20},
    {"day": 19,  "ph_min": 5.8, "ph_max": 6.2, "dose_A_ml_per_L": 1.44, "dose_B_ml_per_L": 0.96, "dose_C_ml_per_L": 0.48, "light_on_time": 960, "light_off_time": 480, "ec_target": 1.60, "ec_tolerance": 0.20},
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
    {"day": 110, "ph_min": 5.8, "ph_max": 6.2, "dose_A_ml_per_L": 0.64, "dose_B_ml_per_L": 1.28, "dose_C_ml_per_L": 1.92, "light_on_time": 960, "light_off_time": 240, "ec_target": 1.20, "ec_tolerance": 0.20},
    {"day": 111, "ph_min": 5.8, "ph_max": 6.2, "dose_A_ml_per_L": 0.64, "dose_B_ml_per_L": 1.28, "dose_C_ml_per_L": 1.92, "light_on_time": 960, "light_off_time": 240, "ec_target": 1.20, "ec_tolerance": 0.20},
    {"day": 112, "ph_min": 5.8, "ph_max": 6.2, "dose_A_ml_per_L": 0.64, "dose_B_ml_per_L": 1.28, "dose_C_ml_per_L": 1.92, "light_on_time": 960, "light_off_time": 240, "ec_target": 1.20, "ec_tolerance": 0.20},
    {"day": 113, "ph_min": 5.8, "ph_max": 6.2, "dose_A_ml_per_L": 0.64, "dose_B_ml_per_L": 1.28, "dose_C_ml_per_L": 1.92, "light_on_time": 960, "light_off_time": 240, "ec_target": 0.60, "ec_tolerance": 0.20},
    {"day": 114, "ph_min": 5.8, "ph_max": 6.2, "dose_A_ml_per_L": 0.64, "dose_B_ml_per_L": 1.28, "dose_C_ml_per_L": 1.92, "light_on_time": 960, "light_off_time": 240, "ec_target": 0.60, "ec_tolerance": 0.20},
    {"day": 115, "ph_min": 5.8, "ph_max": 6.2, "dose_A_ml_per_L": 0.64, "dose_B_ml_per_L": 1.28, "dose_C_ml_per_L": 1.92, "light_on_time": 960, "light_off_time": 240, "ec_target": 0.60, "ec_tolerance": 0.20},
    {"day": 116, "ph_min": 5.8, "ph_max": 6.2, "dose_A_ml_per_L": 0.64, "dose_B_ml_per_L": 1.28, "dose_C_ml_per_L": 1.92, "light_on_time": 960, "light_off_time": 240, "ec_target": 0.60, "ec_tolerance": 0.20},
    {"day": 117, "ph_min": 5.5, "ph_max": 6.5, "dose_A_ml_per_L": 0.0,  "dose_B_ml_per_L": 0.0,  "dose_C_ml_per_L": 0.0,  "light_on_time": 960, "light_off_time": 240, "ec_target": 0.15, "ec_tolerance": 0.15},
    {"day": 118, "ph_min": 5.5, "ph_max": 6.5, "dose_A_ml_per_L": 0.0,  "dose_B_ml_per_L": 0.0,  "dose_C_ml_per_L": 0.0,  "light_on_time": 960, "light_off_time": 240, "ec_target": 0.15, "ec_tolerance": 0.15},
    {"day": 119, "ph_min": 5.5, "ph_max": 6.5, "dose_A_ml_per_L": 0.0,  "dose_B_ml_per_L": 0.0,  "dose_C_ml_per_L": 0.0,  "light_on_time": 960, "light_off_time": 240, "ec_target": 0.15, "ec_tolerance": 0.15},
    {"day": 120, "ph_min": 5.5, "ph_max": 6.5, "dose_A_ml_per_L": 0.0,  "dose_B_ml_per_L": 0.0,  "dose_C_ml_per_L": 0.0,  "light_on_time": 960, "light_off_time": 240, "ec_target": 0.15, "ec_tolerance": 0.15}
    ]
################################################################################
switch:
  # === Air Pump Control ===
  - platform: template
    id: air_pump_cycling_switch
    name: "Air Pump Cycling"
    restore_mode: RESTORE_DEFAULT_OFF  # Default to Normal mode (24/7 ON)
    optimistic: true
    icon: "mdi:air-purifier"
    web_server:
      sorting_group_id: sg_controller_settings
      sorting_weight: 40
    turn_on_action:
      # Enable intermittent cycling for air pump
      # Uses periods configured via the "Air Pump ON/OFF Period" numbers
      # Starts with ON cycle immediately
      - lambda: |-
          uint32_t on_period = (uint32_t)id(air_pump_on_period).state;
          uint32_t off_period = (uint32_t)id(air_pump_off_period).state;

          ESP_LOGI("switch", "=== Air Pump Cycling ENABLED ===");
          ESP_LOGI("switch", "ON period: %u seconds", on_period);
          ESP_LOGI("switch", "OFF period: %u seconds", off_period);

          id(actuator_safety)->setCyclingPeriods("AirPump", on_period, off_period);
          id(actuator_safety)->enableCycling("AirPump", true);

          ESP_LOGI("switch", "Air pump will cycle: %us ON, %us OFF", on_period, off_period);
          ESP_LOGI("switch", "Starting with ON cycle");
          ESP_LOGI("switch", "================================");
    turn_off_action:
      # Disable intermittent cycling and enable Normal mode (24/7 ON)
      - lambda: |-
          ESP_LOGI("switch", "=== Air Pump: NORMAL MODE (24/7 ON) ===");
          id(actuator_safety)->enableCycling("AirPump", false);
          ESP_LOGI("switch", "Cycling disabled - air pump will run continuously");
          ESP_LOGI("switch", "Controller will turn ON pump within 30 seconds");
          ESP_LOGI("switch", "========================================");

  # === Safety Gate Control ===
  - platform: template
    id: safety_gate_enabled
    name: "Enable Actuator Safety Gate"
    optimistic: true
    restore_mode: RESTORE_DEFAULT_ON  # Safety gate enabled by default
    web_server:
      sorting_group_id: sg_controller_settings
      sorting_weight: 80
    turn_on_action:
      - lambda: |-
          ESP_LOGI("switch", "Actuator Safety Gate ENABLED");
          id(actuator_safety)->setEnabled(true);
    turn_off_action:
      - lambda: |-
          ESP_LOGW("switch", "Actuator Safety Gate DISABLED - manual control mode");
          id(actuator_safety)->setEnabled(false);

  # === Automatic EC/Feeding Control ===
  - platform: template
    id: auto_feeding_enabled_switch
    name: "Auto EC/Feeding Correction"
    icon: "mdi:flask-plus"
    web_server:
      sorting_group_id: sg_controller_settings
      sorting_weight: 120
    restore_mode: RESTORE_DEFAULT_ON  # Auto-feeding enabled by default
    optimistic: false  # State determined by lambda return value
    turn_on_action:
      - lambda: |-
          ESP_LOGI("switch", "====================================");
          ESP_LOGI("switch", "AUTO-FEEDING ENABLED");
          ESP_LOGI("switch", "====================================");
          ESP_LOGI("switch", "System will automatically trigger feeding when:");
          ESP_LOGI("switch", "  1. Water level reaches LOW (HIGH=OFF, LOW=OFF, EMPTY=ON)");
          ESP_LOGI("switch", "  2. Controller in IDLE state");
          ESP_LOGI("switch", "  3. NOT in NIGHT/SHUTDOWN/PAUSE/ERROR mode");
          ESP_LOGI("switch", "  4. Feeding not already triggered today");
          ESP_LOGI("switch", "====================================");

          // Save state to NVS
          id(psm).saveState("AutoFeedEnable", true);

          // Update controller state
          id(unified_controller).setAutoFeedingEnabled(true);
    turn_off_action:
      - lambda: |-
          ESP_LOGW("switch", "====================================");
          ESP_LOGW("switch", "AUTO-FEEDING DISABLED");
          ESP_LOGW("switch", "====================================");
          ESP_LOGW("switch", "Manual feeding only - no automatic triggers");
          ESP_LOGW("switch", "====================================");

          // Save state to NVS
          id(psm).saveState("AutoFeedEnable", false);

          // Update controller state
          id(unified_controller).setAutoFeedingEnabled(false);
    lambda: |-
      // Return cached value from controller (loaded from NVS at setup)
      // DO NOT call loadState() here - it allocates memory on each call!
      return id(unified_controller).isAutoFeedingEnabled();

  # === Automatic Weekly Reservoir Change Control ===
  - platform: template
    id: auto_reservoir_change_enabled_switch
    name: "Auto Reservoir Change"
    icon: "mdi:calendar-sync"
    web_server:
      sorting_group_id: sg_controller_settings
      sorting_weight: 90
    restore_mode: RESTORE_DEFAULT_OFF  # Disabled by default (manual control preferred)
    optimistic: false  # State determined by lambda return value
    turn_on_action:
      - lambda: |-
          ESP_LOGI("switch", "====================================");
          ESP_LOGI("switch", "AUTO RESERVOIR CHANGE ENABLED");
          ESP_LOGI("switch", "====================================");
          ESP_LOGI("switch", "System will automatically trigger reservoir change when:");
          ESP_LOGI("switch", "  1. Current day is the configured day of week");
          ESP_LOGI("switch", "  2. Controller in IDLE state");
          ESP_LOGI("switch", "  3. NOT in NIGHT/SHUTDOWN/PAUSE/ERROR mode");
          ESP_LOGI("switch", "  4. Reservoir change not already triggered this week");
          ESP_LOGI("switch", "====================================");

          // Save state to NVS
          id(psm).saveState("AutoResEnable", true);

          // Update controller state
          id(unified_controller).setAutoReservoirChangeEnabled(true);
    turn_off_action:
      - lambda: |-
          ESP_LOGW("switch", "====================================");
          ESP_LOGW("switch", "AUTO RESERVOIR CHANGE DISABLED");
          ESP_LOGW("switch", "====================================");
          ESP_LOGW("switch", "Manual reservoir change only - no automatic triggers");
          ESP_LOGW("switch", "====================================");

          // Save state to NVS
          id(psm).saveState("AutoResEnable", false);

          // Update controller state
          id(unified_controller).setAutoReservoirChangeEnabled(false);
    lambda: |-
      // Return cached value from controller (loaded from NVS at setup)
      return id(unified_controller).isAutoReservoirChangeEnabled();

  # === Auto pH Correction Toggle ===
  - platform: template
    id: auto_ph_correction_switch
    name: "Auto pH Correction"
    icon: "mdi:flask-outline"
    web_server:
      sorting_group_id: sg_controller_settings
      sorting_weight: 110
    restore_mode: RESTORE_DEFAULT_ON
    optimistic: false
    turn_on_action:
      - lambda: |-
          id(unified_controller)->setAutoPhCorrectionEnabled(true);
          id(psm).saveState("AutoPHCorr", true);
          ESP_LOGI("switch", "Auto pH correction ENABLED");
    turn_off_action:
      - lambda: |-
          id(unified_controller)->setAutoPhCorrectionEnabled(false);
          id(psm).saveState("AutoPHCorr", false);
          ESP_LOGW("switch", "Auto pH correction DISABLED");
    lambda: |-
      return id(unified_controller)->isAutoPhCorrectionEnabled();

  # === Auto Water Level Toggle ===
  - platform: template
    id: auto_water_level_switch
    name: "Auto Water Level"
    icon: "mdi:water-auto"
    web_server:
      sorting_group_id: sg_controller_settings
      sorting_weight: 130
    restore_mode: RESTORE_DEFAULT_OFF
    optimistic: false
    turn_on_action:
      - lambda: |-
          id(unified_controller)->setAutoFillEnabled(true);
          id(psm).saveState("AutoFillEn", true);
          ESP_LOGI("switch", "Auto water level ENABLED");
    turn_off_action:
      - lambda: |-
          id(unified_controller)->setAutoFillEnabled(false);
          id(psm).saveState("AutoFillEn", false);
          ESP_LOGW("switch", "Auto water level DISABLED");
    lambda: |-
      return id(unified_controller)->isAutoFillEnabled();

  # === 10 - Actuator Control (Manual Toggle Switches via Safety Gate) ===
  # These switches toggle actuators through the safety gate for monitored control
  # Safety gate will auto-shutoff if max duration exceeded
  # Note: optimistic=true, switches show intended state (not actual hardware state)
  - platform: template
    id: mag_valve_switch
    name: "Magnetic Valve"
    optimistic: true
    restore_mode: ALWAYS_OFF
    web_server:
      sorting_group_id: sg_actuators
      sorting_weight: 10
    turn_on_action:
      - lambda: |-
          if (!id(actuator_safety)->executeCommand("WaterValve", true, 0)) {
            ESP_LOGW("switch", "Magnetic Valve: ON command REJECTED by safety gate");
          }
    turn_off_action:
      - lambda: |-
          if (!id(actuator_safety)->executeCommand("WaterValve", false)) {
            ESP_LOGW("switch", "Magnetic Valve: OFF command REJECTED by safety gate");
          }

  - platform: template
    id: pump_ph_switch
    name: "pH Pump"
    optimistic: true
    restore_mode: ALWAYS_OFF
    web_server:
      sorting_group_id: sg_actuators
      sorting_weight: 20
    turn_on_action:
      - lambda: |-
          if (!id(actuator_safety)->executeCommand("AcidPump", true, 0)) {
            ESP_LOGW("switch", "pH Pump: ON command REJECTED by safety gate");
          }
    turn_off_action:
      - lambda: |-
          if (!id(actuator_safety)->executeCommand("AcidPump", false)) {
            ESP_LOGW("switch", "pH Pump: OFF command REJECTED by safety gate");
          }

  # Nutrient Pump Switches (Grow = NutrientPumpA, Micro = NutrientPumpB, Bloom = NutrientPumpC)
  - platform: template
    id: pump_grow_switch
    name: "Grow Pump"    # NutrientPumpA → nutrient_A_ml_per_liter (GPIO20)
    optimistic: true
    restore_mode: ALWAYS_OFF
    web_server:
      sorting_group_id: sg_actuators
      sorting_weight: 30
    turn_on_action:
      - lambda: |-
          if (!id(actuator_safety)->executeCommand("NutrientPumpA", true, 0)) {
            ESP_LOGW("switch", "Grow Pump: ON command REJECTED by safety gate");
          }
    turn_off_action:
      - lambda: |-
          if (!id(actuator_safety)->executeCommand("NutrientPumpA", false)) {
            ESP_LOGW("switch", "Grow Pump: OFF command REJECTED by safety gate");
          }

  - platform: template
    id: pump_micro_switch
    name: "Micro Pump"   # NutrientPumpB → nutrient_B_ml_per_liter (GPIO21)
    optimistic: true
    restore_mode: ALWAYS_OFF
    web_server:
      sorting_group_id: sg_actuators
      sorting_weight: 40
    turn_on_action:
      - lambda: |-
          if (!id(actuator_safety)->executeCommand("NutrientPumpB", true, 0)) {
            ESP_LOGW("switch", "Micro Pump: ON command REJECTED by safety gate");
          }
    turn_off_action:
      - lambda: |-
          if (!id(actuator_safety)->executeCommand("NutrientPumpB", false)) {
            ESP_LOGW("switch", "Micro Pump: OFF command REJECTED by safety gate");
          }

  - platform: template
    id: pump_bloom_switch
    name: "Bloom Pump"   # NutrientPumpC → nutrient_C_ml_per_liter (GPIO22)
    optimistic: true
    restore_mode: ALWAYS_OFF
    web_server:
      sorting_group_id: sg_actuators
      sorting_weight: 50
    turn_on_action:
      - lambda: |-
          if (!id(actuator_safety)->executeCommand("NutrientPumpC", true, 0)) {
            ESP_LOGW("switch", "Bloom Pump: ON command REJECTED by safety gate");
          }
    turn_off_action:
      - lambda: |-
          if (!id(actuator_safety)->executeCommand("NutrientPumpC", false)) {
            ESP_LOGW("switch", "Bloom Pump: OFF command REJECTED by safety gate");
          }

  # Shelly integration on/off (runtime). OFF: no polling, Shelly commands dropped,
  # WastewaterPump forced OFF first; tank drain and reservoir change are refused.
  # Polling runs in a HAL worker task (every 30s), not in an interval.
  - platform: template
    name: "Shelly Integration"
    id: shelly_integration_switch
    optimistic: true
    restore_mode: RESTORE_DEFAULT_ON
    icon: "mdi:power-socket-eu"
    web_server:
      sorting_group_id: sg_controller_settings
      sorting_weight: 5
    turn_on_action:
      - lambda: id(hal).setShellyEnabled(true);
    turn_off_action:
      - lambda: id(hal).setShellyEnabled(false);

  # === Shelly-Controlled Actuators (Shelly Plus 4PM @ 192.168.0.130) ===
  # AirPump on Socket 0, WastewaterPump on Socket 2, GrowLight on Socket 3
  # Socket 1 reserved for future expansion
  # Uses ASG for debouncing based on actual Shelly state (polled every 5s)

  # Air pump via Shelly Plus 4PM Socket 0
  - platform: template
    id: air_pump_shelly_switch
    name: "Air Pump"
    restore_mode: ALWAYS_OFF
    web_server:
      sorting_group_id: sg_actuators
      sorting_weight: 60
    lambda: |-
      // Return actual state from HAL (synced via polling)
      return id(hal).getShellySwitchState(0);
    turn_on_action:
      # Use ASG for debouncing with actual Shelly state
      - lambda: |-
          if (id(actuator_safety).executeCommand("AirPump", true, 0)) {
            ESP_LOGI("switch", "Air Pump (Shelly Socket 0): ASG approved ON");
          } else {
            ESP_LOGD("switch", "Air Pump (Shelly Socket 0): ASG rejected (already ON or debounced)");
          }
    turn_off_action:
      - lambda: |-
          if (id(actuator_safety).executeCommand("AirPump", false, 0)) {
            ESP_LOGI("switch", "Air Pump (Shelly Socket 0): ASG approved OFF");
          } else {
            ESP_LOGD("switch", "Air Pump (Shelly Socket 0): ASG rejected (already OFF or debounced)");
          }

  # Wastewater pump via Shelly Plus 4PM Socket 2
  - platform: template
    id: wastewater_pump_shelly_switch
    name: "Wastewater Pump"
    restore_mode: ALWAYS_OFF
    web_server:
      sorting_group_id: sg_actuators
      sorting_weight: 70
    lambda: |-
      // Return actual state from HAL (synced via polling)
      return id(hal).getShellySwitchState(2);
    turn_on_action:
      # Use ASG for debouncing with actual Shelly state
      - lambda: |-
          if (id(actuator_safety).executeCommand("WastewaterPump", true, 0)) {
            ESP_LOGI("switch", "Wastewater Pump (Shelly Socket 2): ASG approved ON");
          } else {
            ESP_LOGD("switch", "Wastewater Pump (Shelly Socket 2): ASG rejected (already ON or debounced)");
          }
    turn_off_action:
      - lambda: |-
          if (id(actuator_safety).executeCommand("WastewaterPump", false, 0)) {
            ESP_LOGI("switch", "Wastewater Pump (Shelly Socket 2): ASG approved OFF");
          } else {
            ESP_LOGD("switch", "Wastewater Pump (Shelly Socket 2): ASG rejected (already OFF or debounced)");
          }

  # Grow light via Shelly Plus 4PM Socket 3
  - platform: template
    id: grow_light_shelly_switch
    name: "Grow Light"
    restore_mode: ALWAYS_OFF
    web_server:
      sorting_group_id: sg_actuators
      sorting_weight: 80
    lambda: |-
      // Return actual state from HAL (synced via polling)
      return id(hal).getShellySwitchState(3);
    turn_on_action:
      # Use ASG for debouncing with actual Shelly state
      - lambda: |-
          if (id(actuator_safety).executeCommand("GrowLight", true, 0)) {
            ESP_LOGI("switch", "Grow Light (Shelly Socket 3): ASG approved ON");
          } else {
            ESP_LOGD("switch", "Grow Light (Shelly Socket 3): ASG rejected (already ON or debounced)");
          }
    turn_off_action:
      - lambda: |-
          if (id(actuator_safety).executeCommand("GrowLight", false, 0)) {
            ESP_LOGI("switch", "Grow Light (Shelly Socket 3): ASG approved OFF");
          } else {
            ESP_LOGD("switch", "Grow Light (Shelly Socket 3): ASG rejected (already OFF or debounced)");
          }

  # === pH Sensor Control ===
  - platform: template
    name: "Continuous pH Reading"
    id: continuous_ph_reading_switch
    optimistic: true
    web_server:
      sorting_group_id: sg_controller_settings
      sorting_weight: 180
    turn_on_action:
      then:
        - lambda: |-
            ESP_LOGI("switch", "Enabling continuous pH reading mode");
            id(ezo_ph_uart_component)->enable_continuous_reading();
    turn_off_action:
      then:
        - lambda: |-
            ESP_LOGI("switch", "Disabling continuous pH reading mode");
            id(ezo_ph_uart_component)->disable_continuous_reading();

  # === Night Mode Configuration ===

  - platform: template
    name: "Night Mode"
    id: night_mode_switch
    optimistic: true
    restore_mode: RESTORE_DEFAULT_ON
    icon: "mdi:weather-night"
    web_server:
      sorting_group_id: sg_controller_settings
      sorting_weight: 10
    turn_on_action:
      - lambda: |-
          ESP_LOGI("switch", "Night Mode ENABLED - no pH correction, feeding, or filling during night hours");
          id(unified_controller)->setNightModeConfig(true, id(night_start_hour).state, id(night_end_hour).state);
    turn_off_action:
      - lambda: |-
          ESP_LOGI("switch", "Night Mode DISABLED");
          id(unified_controller)->setNightModeConfig(false, id(night_start_hour).state, id(night_end_hour).state);

  # === Grow Light Schedule Control ===
  # When enabled, the controller will automatically control the grow light based on the calendar schedule.
  # When disabled (default), use Shelly scripts for direct light cycle control - more fail-proof.

  - platform: template
    name: "Grow Light Schedule"
    id: grow_light_schedule_switch
    optimistic: true
    restore_mode: RESTORE_DEFAULT_OFF
    icon: "mdi:lightbulb-auto"
    web_server:
      sorting_group_id: sg_controller_settings
      sorting_weight: 70
    turn_on_action:
      - lambda: |-
          ESP_LOGI("switch", "Grow Light Schedule ENABLED - controller will manage light based on calendar");
          id(unified_controller)->setGrowLightScheduleEnabled(true);
    turn_off_action:
      - lambda: |-
          ESP_LOGI("switch", "Grow Light Schedule DISABLED - use Shelly scripts for direct control");
          id(unified_controller)->setGrowLightScheduleEnabled(false);
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
