CodyMcCodeface69/plantOS-Hydromat/components/plantos_controller/controller.cpp

#include "controller.h"
#include "esphome/components/plantos_hal/hal.h"
#include "esphome/components/actuator_safety_gate/ActuatorSafetyGate.h"
#include "esphome/components/persistent_state_manager/persistent_state_manager.h"
#include "esphome/components/calendar_manager/CalendarManager.h"
#include "esphome/components/time/real_time_clock.h"
#include "esphome/components/alert_service/alert_service.h"
#include <algorithm> // for std::sort, std::min, std::max
#include <cmath>    // for std::sqrt

/*
╔════════════════════════════════════════════════════════════════════════════════════════╗
║                                                                                        ║
║                    PlantOS Controller - Unified FSM Implementation                     ║
║                                                                                        ║
║  IMPORTANT: For complete FSM documentation including state diagrams, transitions,     ║
║             triggers, and implementation guidelines, see:                              ║
║                                                                                        ║
║             /home/cody/plantOS-testlab/FSMINFO.md                                      ║
║                                                                                        ║
║  This file contains the implementation of all state handlers and transitions.          ║
║  FSMINFO.md is the authoritative source for FSM behavior and MUST be updated          ║
║  when making changes to states, transitions, actuator actions, or timeouts.           ║
║                                                                                        ║
╚════════════════════════════════════════════════════════════════════════════════════════╝
*/

namespace plantos_controller {

PlantOSController::PlantOSController() {
    // Initialize LED behavior system
    led_behaviors_ = std::make_unique<LedBehaviorSystem>();
}

// ============================================================================
// ESPHome Component Lifecycle
// ============================================================================

void PlantOSController::setup() {
    ESP_LOGI(TAG, "PlantOS Unified Controller initializing...");

    // Initialize status logger
    status_logger_.begin();

    // Verify critical dependencies
    if (!hal_) {
        ESP_LOGE(TAG, "HAL not configured - Controller cannot function!");
        return;
    }

    if (!safety_gate_) {
        ESP_LOGW(TAG, "SafetyGate not configured - Actuator control disabled");
    }

    if (psm_) {
        ESP_LOGI(TAG, "PSM configured - State persistence enabled");

        // Load auto-feeding state from NVS
        auto_feeding_enabled_ = psm_->loadState(NVS_KEY_AUTO_FEED_ENABLE, true);
        ESP_LOGI(TAG, "Auto-feeding: %s", auto_feeding_enabled_ ? "ENABLED" : "DISABLED");

        // Load auto-fill state from NVS (default OFF - safer)
        auto_fill_enabled_ = psm_->loadState(NVS_KEY_AUTO_FILL_ENABLE, false);
        ESP_LOGI(TAG, "Auto-fill: %s", auto_fill_enabled_ ? "ENABLED" : "DISABLED");

        // Load auto pH correction state from NVS (default ON)
        auto_ph_correction_enabled_ = psm_->loadState(NVS_KEY_AUTO_PH_CORR, true);
        ESP_LOGI(TAG, "Auto pH correction: %s", auto_ph_correction_enabled_ ? "ENABLED" : "DISABLED");

        // Load adaptive pH K-factor from NVS
        ph_K_ = psm_->loadFloat(NVS_KEY_PH_K, 0.07f);
        ESP_LOGI(TAG, "pH K-factor loaded from NVS: %.4f", ph_K_);

        // Load adaptive EC K-factor from NVS
        ec_K_feed_ = psm_->loadFloat(NVS_KEY_EC_K, 0.00015f);
        ESP_LOGI(TAG, "EC K-factor loaded from NVS: %.4f", ec_K_feed_);

        // Initialize last feed date (will be loaded from NVS on first check)
        last_auto_feed_date_ = 0;

        // Load calibration timestamps from NVS (Phase 7)
        last_ph_calibration_ts_ = (int64_t)psm_->loadInt32(NVS_KEY_PH_CALIB_TS, 0);
        last_ec_calibration_ts_ = (int64_t)psm_->loadInt32(NVS_KEY_EC_CALIB_TS, 0);
        ESP_LOGI(TAG, "pH last calibrated: %lld s, EC last calibrated: %lld s",
                 (long long)last_ph_calibration_ts_, (long long)last_ec_calibration_ts_);
    } else {
        ESP_LOGW(TAG, "PSM not configured - State persistence disabled");
    }

    // Register temperature change callback (ISR-safe - no logging in callback!)
    // Temperature sensor callbacks can be triggered from ISR context (ADC interrupts),
    // so we must NOT call ESP_LOGI or any FreeRTOS queue operations here.
    // Instead, we set a volatile flag and handle logging in the main loop.
    if (hal_->hasTemperature()) {
        hal_->onTemperatureChange([this](float temp) {
            // ISR-SAFE: Only update volatile members, no logging!
            last_temperature_ = temp;
            temperature_changed_ = true;
        });
        ESP_LOGI(TAG, "Temperature sensor callback registered (ISR-safe)");
    } else {
        ESP_LOGW(TAG, "Temperature sensor not available - temperature compensation disabled");
    }

    // Initialize periodic pH check timer
    last_ph_check_time_ = esphome::millis();
    if (hal_->hasTime()) {
        last_ph_check_timestamp_ = hal_->getCurrentTimestamp();
        ESP_LOGI(TAG, "Time source available - using clock-based pH scheduling");
    } else {
        last_ph_check_timestamp_ = 0;
        ESP_LOGW(TAG, "No time source - using fallback boot-time based pH scheduling");
    }

    uint32_t ph_interval_hours = hal_->get_ph_reading_interval() / 3600000;  // Convert ms to hours
    uint32_t ph_interval_days = ph_interval_hours / 24;

    if (ph_interval_days > 0) {
        ESP_LOGI(TAG, "Periodic pH monitoring: every %u day%s (%u hours)",
                 ph_interval_days, ph_interval_days > 1 ? "s" : "", ph_interval_hours);
    } else {
        ESP_LOGI(TAG, "Periodic pH monitoring: every %u hours", ph_interval_hours);
    }

    // Always start in INIT state for boot sequence
    ESP_LOGI(TAG, "Controller initialized - Starting INIT boot sequence");
    transitionTo(ControllerState::INIT);
}

void PlantOSController::loop() {
    if (!hal_) {
        return; // Cannot operate without HAL
    }

    // Update LED behavior for current state
    uint32_t elapsed = getStateElapsed();
    led_behaviors_->update(current_state_, elapsed, hal_);

    // Handle temperature change notifications (ISR-safe deferred logging)
    // The callback sets temperature_changed_ flag from ISR context,
    // and we do the actual logging here in the main loop to avoid
    // calling ESP_LOGI from ISR which causes alignment crashes on RISC-V.
    if (temperature_changed_) {
        temperature_changed_ = false;  // Clear flag
        if (status_logger_.isVerboseMode()) {
            ESP_LOGI(TAG, "Temperature changed: %.1f°C", last_temperature_);
        }
    }

    // Check if we should print periodic status report (or one was requested on demand)
    bool forced_report = status_report_requested_;
    if (status_logger_.shouldPrintStatusReport() || forced_report) {
        status_report_requested_ = false;
        // Update status logger with current pH before printing
        if (hal_->hasPhValue()) {
            status_logger_.updateStatus(hal_->readPH(), "");
        }

        // Update UART hardware status (EZO pH sensor)
        if (hal_) {
            std::vector<UARTDeviceInfo> uartDevices;
            std::string status = "";

            // Check if sensor is ready
            bool isReady = hal_->isPhSensorReady();

            // Add calibration status if available
            // Note: Calibration query would require async call, so we just show ready status
            if (isReady) {
                status = "Ready";
            } else {
                status = "Not responding";
            }

            uartDevices.push_back(UARTDeviceInfo(
                "EZO pH Sensor",
                "TX=GPIO18, RX=GPIO19 (uart_bus)",
                isReady,
                true,  // critical
                status
            ));

            status_logger_.updateUARTHardwareStatus(uartDevices);
        }

        // Update 1-Wire hardware status (DS18B20 temperature sensor)
        // Always report if configured, even if waiting for first reading
        std::vector<OneWireDeviceInfo> oneWireDevices;

        bool hasReading = hal_->hasTemperature();
        std::string status;
        float temp = 0.0f;

        if (hasReading) {
            temp = hal_->readTemperature();
            char statusBuf[32];
            snprintf(statusBuf, sizeof(statusBuf), "%.1f°C", temp);
            status = std::string(statusBuf);
        } else {
            status = "Waiting for first reading";
        }

        oneWireDevices.push_back(OneWireDeviceInfo(
            "DS18B20 Temperature",
            "GPIO3",
            hasReading,  // ready when has reading
            true,        // critical for pH compensation
            status
        ));

        status_logger_.updateOneWireHardwareStatus(oneWireDevices);

        // Update water temperature in sensor data section
        status_logger_.updateWaterTemperature(temp, hasReading);

        // Update EC sensor data in status logger
        status_logger_.updateEC(hal_->readEC(), hal_->hasECValue());

        // Update water level sensors in sensor data section (3-sensor system)
        bool hasWaterLevelSensors = hal_->hasWaterLevelSensors();
        bool highSensor = false;
        bool lowSensor = false;
        bool emptySensor = false;

        if (hasWaterLevelSensors) {
            highSensor = hal_->readWaterLevelHigh();
            lowSensor = hal_->readWaterLevelLow();
            emptySensor = hal_->readWaterLevelEmpty();
        }

        status_logger_.updateWaterLevelSensors(highSensor, lowSensor, emptySensor, hasWaterLevelSensors);

        // Update pump configurations in status logger
        std::vector<PumpConfigInfo> pumpConfigs;
        pumpConfigs.push_back(PumpConfigInfo(
            "pH Pump (AcidPump)",
            hal_->getPumpConfig("AcidPump").flow_rate_ml_s,
            hal_->getPumpConfig("AcidPump").pwm_intensity
        ));
        pumpConfigs.push_back(PumpConfigInfo(
            "Grow Pump (NutrientPumpA)",
            hal_->getPumpConfig("NutrientPumpA").flow_rate_ml_s,
            hal_->getPumpConfig("NutrientPumpA").pwm_intensity
        ));
        pumpConfigs.push_back(PumpConfigInfo(
            "Micro Pump (NutrientPumpB)",
            hal_->getPumpConfig("NutrientPumpB").flow_rate_ml_s,
            hal_->getPumpConfig("NutrientPumpB").pwm_intensity
        ));
        pumpConfigs.push_back(PumpConfigInfo(
            "Bloom Pump (NutrientPumpC)",
            hal_->getPumpConfig("NutrientPumpC").flow_rate_ml_s,
            hal_->getPumpConfig("NutrientPumpC").pwm_intensity
        ));
        status_logger_.updatePumpConfigurations(pumpConfigs);

        // Update PSM event info in status logger
        if (psm_) {
            if (psm_->hasEvent()) {
                esphome::persistent_state_manager::CriticalEventLog event = psm_->getLastEvent();
                status_logger_.updatePSMEvent(event.eventID, event.status, psm_->getEventAge());
            } else {
                // No event - clear PSM info in status logger
                status_logger_.updatePSMEvent("", 0, -1);
            }
        }

        // Update calendar status in status logger
        if (calendar_manager_) {
            // Use calendar manager's actual current day (not timestamp-based calculation)
            uint8_t currentDay = calendar_manager_->get_current_day();
            esphome::calendar_manager::DailySchedule schedule = calendar_manager_->get_schedule(currentDay);
            status_logger_.updateCalendarStatus(
                currentDay,
                schedule.target_ph_min,
                schedule.target_ph_max,
                schedule.nutrient_A_ml_per_liter,
                schedule.nutrient_B_ml_per_liter,
                schedule.nutrient_C_ml_per_liter,
                calendar_manager_->is_safe_mode(),
                schedule.ec_target,
                ec_target_multiplier_
            );
        }

        status_logger_.logStatus(forced_report);

        // Log water level status with ASCII art visualization (3-sensor system)
        if (hal_->hasWaterLevelSensors()) {
            bool high = hal_->readWaterLevelHigh();
            bool low = hal_->readWaterLevelLow();
            bool empty = hal_->readWaterLevelEmpty();
            status_logger_.logWaterLevelStatus(high, low, empty, true);
        } else {
            status_logger_.logWaterLevelStatus(false, false, false, false);  // Sensors offline
        }
    }

    // Call state-specific handler
    switch (current_state_) {
        case ControllerState::INIT:
            handleInit();
            break;

        case ControllerState::IDLE:
            handleIdle();
            break;

        case ControllerState::NIGHT:
            handleNight();
            break;

        case ControllerState::SHUTDOWN:
            handleShutdown();
            break;

        case ControllerState::PAUSE:
            handlePause();
            break;

        case ControllerState::ERROR:
            handleError();
            break;

        case ControllerState::PH_PROCESSING:
            handlePhProcessing();
            break;

        case ControllerState::PH_MEASURING:
            handlePhMeasuring();
            break;

        case ControllerState::PH_CALCULATING:
            handlePhCalculating();
            break;

        case ControllerState::PH_INJECTING:
            handlePhInjecting();
            break;

        case ControllerState::PH_MIXING:
            handlePhMixing();
            break;

        case ControllerState::PH_CALIBRATING:
            handlePhCalibrating();
            break;

        case ControllerState::FEEDING:
            handleFeeding();
            break;

        case ControllerState::WATER_FILLING:
            handleWaterFilling();
            break;

        case ControllerState::WATER_EMPTYING:
            handleWaterEmptying();
            break;

        case ControllerState::FEED_FILLING:
            handleFeedFilling();
            break;

        case ControllerState::EC_PROCESSING:
            handleEcProcessing();
            break;

        case ControllerState::EC_CALCULATING:
            handleEcCalculating();
            break;

        case ControllerState::EC_FEEDING:
            handleEcFeeding();
            break;

        case ControllerState::EC_MIXING:
            handleEcMixing();
            break;

        case ControllerState::EC_MEASURING:
            handleEcMeasuring();
            break;

        case ControllerState::EC_CALIBRATING:
            handleEcCalibrating();
            break;
    }

    // ========================================================================
    // Time-based Light Control
    // ========================================================================
    // Check if we should update grow light based on calendar schedule
    // Only run when:
    // - Grow light schedule is enabled (default: disabled, use Shelly scripts instead)
    // - System is operational (not in SHUTDOWN, PAUSE, or ERROR)
    if (grow_light_schedule_enabled_ && calendar_manager_ && time_source_ &&
        current_state_ != ControllerState::SHUTDOWN &&
        current_state_ != ControllerState::PAUSE &&
        current_state_ != ControllerState::ERROR) {

        // Get current time
        auto now = time_source_->now();
        if (now.is_valid()) {
            // Get today's schedule
            auto schedule = calendar_manager_->get_today_schedule();

            // Calculate current time in minutes since midnight
            uint16_t current_minutes = now.hour * 60 + now.minute;

            // Determine if light should be ON
            // Handle wraparound case (e.g., ON at 16:00, OFF at 08:00 means light is on overnight)
            bool should_be_on = false;
            if (schedule.light_on_time < schedule.light_off_time) {
                // Normal case: ON and OFF within same day (e.g., ON at 08:00, OFF at 16:00)
                should_be_on = (current_minutes >= schedule.light_on_time &&
                               current_minutes < schedule.light_off_time);
            } else {
                // Wraparound case: light is on overnight (e.g., ON at 16:00, OFF at 08:00)
                should_be_on = (current_minutes >= schedule.light_on_time ||
                               current_minutes < schedule.light_off_time);
            }

            // Track previous state to avoid redundant commands
            static bool previous_light_state = false;
            static bool first_run = true;

            // Update light state if changed (or on first run)
            // Uses requestPump to go through ASG for proper tracking
            if (first_run || previous_light_state != should_be_on) {
                if (should_be_on) {
                    ESP_LOGI(TAG, "Grow light schedule: Turning ON (Day %d, Schedule: %02d:%02d ON / %02d:%02d OFF)",
                             schedule.day_number,
                             schedule.light_on_time / 60, schedule.light_on_time % 60,
                             schedule.light_off_time / 60, schedule.light_off_time % 60);
                    requestPump("GrowLight", true, 0);  // 0 = no duration limit
                } else {
                    ESP_LOGI(TAG, "Grow light schedule: Turning OFF (Day %d, Schedule: %02d:%02d ON / %02d:%02d OFF)",
                             schedule.day_number,
                             schedule.light_on_time / 60, schedule.light_on_time % 60,
                             schedule.light_off_time / 60, schedule.light_off_time % 60);
                    requestPump("GrowLight", false);
                }
                previous_light_state = should_be_on;
                first_run = false;
            }
        }
    }
}

// ============================================================================
// State Handlers
// ============================================================================

void PlantOSController::handleInit() {
    // Boot sequence: Red → Yellow → Green (3 seconds)
    // LED behavior handles visual feedback

    uint32_t elapsed = getStateElapsed();

    // On first entry (elapsed < 100ms): Check PSM for persisted states
    // We check here (not in setup()) because PSM might initialize after controller
    if (elapsed < 100 && !boot_restore_pending_) {
        if (psm_) {
            ESP_LOGI(TAG, "Checking PSM for persisted state...");

            // Check if we were in SHUTDOWN or PAUSE state before power loss
            if (psm_->hasEvent()) {
                esphome::persistent_state_manager::CriticalEventLog event = psm_->getLastEvent();
                std::string eventID(event.eventID);

                // Check if event ID is non-empty (not a cleared event)
                if (!eventID.empty()) {
                    if (eventID == "STATE_SHUTDOWN") {
                        ESP_LOGW(TAG, "RECOVERY: SHUTDOWN state found in PSM (age: %lld sec) - will restore after INIT",
                                 psm_->getEventAge());
                        boot_restore_state_ = ControllerState::SHUTDOWN;
                        boot_restore_pending_ = true;
                    } else if (eventID == "STATE_PAUSE") {
                        ESP_LOGW(TAG, "RECOVERY: PAUSE state found in PSM (age: %lld sec) - will restore after INIT",
                                 psm_->getEventAge());
                        boot_restore_state_ = ControllerState::PAUSE;
                        boot_restore_pending_ = true;
                    } else if (eventID == "WATER_FILLING") {
                        ESP_LOGW(TAG, "RECOVERY: Interrupted WATER_FILLING operation found (age: %lld sec)", psm_->getEventAge());
                        ESP_LOGW(TAG, "RECOVERY: Force-closing water valve to prevent overflow");
                        // Close valve via SafetyGate
                        if (safety_gate_) {
                            safety_gate_->executeCommand(WATER_VALVE, false, 0);
                        }
                        // Clear PSM event
                        psm_->clearEvent();
                        ESP_LOGI(TAG, "RECOVERY: Water valve closed, PSM event cleared");
                    } else if (eventID == "WATER_EMPTYING") {
                        ESP_LOGW(TAG, "RECOVERY: Interrupted WATER_EMPTYING operation found (age: %lld sec)", psm_->getEventAge());
                        ESP_LOGW(TAG, "RECOVERY: Force-stopping wastewater pump");
                        // Stop pump via SafetyGate
                        if (safety_gate_) {
                            safety_gate_->executeCommand(WASTEWATER_PUMP, false, 0);
                        }
                        // Clear PSM event
                        psm_->clearEvent();
                        ESP_LOGI(TAG, "RECOVERY: Wastewater pump stopped, PSM event cleared");
                    } else {
                        // Some other operation was interrupted - log warning
                        ESP_LOGW(TAG, "RECOVERY: Interrupted operation found: %s (status: %d, age: %lld sec)",
                                 eventID.c_str(), event.status, psm_->getEventAge());
                        ESP_LOGW(TAG, "Operation was likely interrupted by power loss - check if recovery needed");
                        if (alert_service_) {
                            alert_service_->alert(alert_service::AlertLevel::WARNING,
                                "Operation interrupted",
                                "Operation '" + eventID + "' was interrupted by power loss (age: " +
                                std::to_string(psm_->getEventAge()) + "s) — verify system state");
                        }
                    }
                } else {
                    ESP_LOGD(TAG, "PSM event is empty (cleared) - no restoration needed");
                }
            } else {
                ESP_LOGI(TAG, "No PSM event found - clean boot");
            }
        }
    }

    // ========================================================================
    // ONE-TIME BOOT ACTIONS (Phase 8 - Enhanced Reboot Recovery)
    // Runs once during INIT, regardless of elapsed time.
    // Cooldowns, sensor check, reboot alert.
    // ========================================================================
    if (!boot_alert_sent_) {
        boot_alert_sent_ = true;
        uint32_t now = hal_->getSystemTime();

        last_sensor_health_check_time_ = now;
        ESP_LOGI(TAG, "BOOT: Cooldowns initialized");

        // Boot sensor check - log all available sensor readings
        ESP_LOGI(TAG, "BOOT SENSOR CHECK:");
        if (hal_->hasPhValue()) {
            ESP_LOGI(TAG, "  pH        : %.2f", hal_->readPH());
        } else {
            ESP_LOGW(TAG, "  pH        : NOT AVAILABLE");
        }
        if (hal_->hasECValue()) {
            ESP_LOGI(TAG, "  EC        : %.1f uS/cm (%.3f mS/cm)", hal_->readEC(), hal_->readEC() / 1000.0f);
        } else {
            ESP_LOGW(TAG, "  EC        : NOT AVAILABLE");
        }
        if (hal_->hasTemperature()) {
            ESP_LOGI(TAG, "  Temp      : %.1f\xC2\xB0""C", hal_->readTemperature());
        } else {
            ESP_LOGW(TAG, "  Temp      : NOT AVAILABLE");
        }
        if (hal_->hasWaterLevelSensors()) {
            ESP_LOGI(TAG, "  WaterLevel: HIGH=%s LOW=%s EMPTY=%s",
                     hal_->readWaterLevelHigh() ? "ON" : "off",
                     hal_->readWaterLevelLow()  ? "ON" : "off",
                     hal_->readWaterLevelEmpty() ? "ON" : "off");
        } else {
            ESP_LOGW(TAG, "  WaterLevel: NOT CONFIGURED");
        }

        // Reboot notification via AlertService
        if (alert_service_) {
            alert_service_->alert(alert_service::AlertLevel::INFO,
                "System rebooted",
                "PlantOS controller boot complete — all subsystems initializing");
        }
    }

    if (elapsed >= INIT_DURATION) {
        ESP_LOGI(TAG, "Boot sequence complete");

        // Check if we need to restore a persisted state from PSM
        if (boot_restore_pending_) {
            boot_restore_pending_ = false;

            if (boot_restore_state_ == ControllerState::SHUTDOWN) {
                ESP_LOGW(TAG, "RECOVERY: Restoring SHUTDOWN state from power loss");
                if (alert_service_) {
                    alert_service_->alert(alert_service::AlertLevel::WARNING,
                        "State restored: SHUTDOWN",
                        "System was in SHUTDOWN before power loss — resuming SHUTDOWN");
                }
                transitionTo(ControllerState::SHUTDOWN);
            } else if (boot_restore_state_ == ControllerState::PAUSE) {
                ESP_LOGW(TAG, "RECOVERY: Restoring PAUSE state from power loss");
                if (alert_service_) {
                    alert_service_->alert(alert_service::AlertLevel::WARNING,
                        "State restored: PAUSE",
                        "System was in PAUSE before power loss — resuming PAUSE");
                }
                transitionTo(ControllerState::PAUSE);
            } else {
                // Default to IDLE
                transitionTo(ControllerState::IDLE);
            }
        } else {
            // Normal boot - no persisted state to restore
            transitionTo(ControllerState::IDLE);
        }
    }
}

void PlantOSController::handleIdle() {
    // Breathing green - waiting for commands
    // This is the default ready state

    uint32_t elapsed = getStateElapsed();

    // Periodically check PSM for SHUTDOWN or PAUSE states every 5 seconds
    // This handles cases where:
    // 1. State was set while system was running
    // 2. State restoration from INIT failed due to timing issues
    // 3. Component initialization order caused PSM to be unavailable during INIT
    static uint32_t last_psm_check = 0;
    uint32_t now = hal_->getSystemTime();

    if (now - last_psm_check >= 5000) {  // Check every 5 seconds
        last_psm_check = now;

        if (psm_ && psm_->hasEvent()) {
            esphome::persistent_state_manager::CriticalEventLog event = psm_->getLastEvent();
            std::string eventID(event.eventID);

            ESP_LOGD(TAG, ">>> IDLE PSM CHECK: EventID='%s', Status=%d, Age=%lld sec",
                     eventID.c_str(), event.status, psm_->getEventAge());

            // Check for persistent states that should override IDLE
            if (!eventID.empty()) {
                if (eventID == "STATE_SHUTDOWN") {
                    ESP_LOGW(TAG, ">>> PSM check: SHUTDOWN state detected - transitioning from IDLE");
                    transitionTo(ControllerState::SHUTDOWN);
                    return;
                } else if (eventID == "STATE_PAUSE") {
                    ESP_LOGW(TAG, ">>> PSM check: PAUSE state detected - transitioning from IDLE");
                    transitionTo(ControllerState::PAUSE);
                    return;
                }
            }
        }
    }

    // ========================================================================
    // CALENDAR DAY AUTO-ADVANCE - Sync grow day to real-world local date
    // ========================================================================
    // Runs once the first time NTP time is valid, then every 60s. The calendar
    // manager advances the grow day by the number of local calendar days elapsed
    // since its last-synced date (handles midnight rollover during runtime and
    // catch-up after the device was powered off across one or more midnights).
    if (calendar_manager_ && hal_->hasTime()) {
        uint32_t nowMs = esphome::millis();
        if (!did_initial_date_sync_ || (nowMs - last_date_check_ms_) >= 60000) {
            int32_t today_ordinal = getLocalDateOrdinal();
            if (today_ordinal > 0) {
                calendar_manager_->sync_to_date(today_ordinal);
                did_initial_date_sync_ = true;
                last_date_check_ms_ = nowMs;
            }
        }
    }

    // ========================================================================
    // PERIODIC pH MONITORING - Time-based scheduling aligned to midnight
    // ========================================================================
    // Uses real-time clock to schedule pH checks at fixed intervals from 0:00
    // Example: 2-hour interval → checks at 0:00, 2:00, 4:00, ..., 22:00
    // Supports intervals up to 48 hours (2 days)
    //
    // Falls back to millis()-based scheduling if no time source available
    // ========================================================================

    uint32_t ph_interval_ms = hal_->get_ph_reading_interval();  // Default: 2 hours (7200000 ms)

    // Check if time source is available for clock-based scheduling
    if (hal_->hasTime()) {
        // TIME-BASED SCHEDULING (preferred)
        int64_t current_timestamp = hal_->getCurrentTimestamp();
        uint32_t ph_interval_seconds = ph_interval_ms / 1000;  // Convert ms to seconds

        // Check if we should trigger a pH check
        bool should_trigger = false;

        if (ph_interval_seconds >= 86400) {
            // MULTI-DAY INTERVAL (≥24 hours)
            // Example: 48h interval → check every 2 days at midnight
            // Calculate days since epoch and check if interval has passed
            int64_t days_since_epoch = current_timestamp / 86400;
            int64_t last_check_days = last_ph_check_timestamp_ / 86400;
            int64_t interval_days = ph_interval_seconds / 86400;

            if (days_since_epoch - last_check_days >= interval_days) {
                // Enough days have passed - trigger if we're past midnight
                uint32_t seconds_since_midnight = hal_->getSecondsSinceMidnight();
                if (seconds_since_midnight >= 60) {  // Wait 1 minute after midnight for clock stability
                    should_trigger = true;
                    ESP_LOGI(TAG, "Multi-day pH check: %lld days since last check (interval: %lld days)",
                             days_since_epoch - last_check_days, interval_days);
                }
            }
        } else {
            // DAILY INTERVAL (<24 hours)
            // Example: 2h interval → slots at 0:00, 2:00, 4:00, ..., 22:00
            uint32_t seconds_since_midnight = hal_->getSecondsSinceMidnight();
            uint32_t current_slot = seconds_since_midnight / ph_interval_seconds;

            // Calculate timestamp of current slot boundary
            int64_t day_start = current_timestamp - seconds_since_midnight;
            int64_t current_slot_timestamp = day_start + (current_slot * ph_interval_seconds);

            // Trigger if we've crossed into a new slot since last check
            if (current_slot_timestamp > last_ph_check_timestamp_) {
                should_trigger = true;
                uint32_t slot_hour = (current_slot * ph_interval_seconds) / 3600;
                uint32_t slot_minute = ((current_slot * ph_interval_seconds) % 3600) / 60;
                ESP_LOGI(TAG, "Daily pH check slot: %02u:%02u (slot %u of %u)",
                         slot_hour, slot_minute, current_slot, 86400 / ph_interval_seconds);
            }
        }

        if (should_trigger) {
            last_ph_check_timestamp_ = current_timestamp;
            last_ph_check_time_ = now;  // Update fallback timer too

            if (!auto_ph_correction_enabled_ || (night_mode_enabled_ && isNightModeHours())) {
                ESP_LOGD(TAG, "Automatic pH check skipped — %s",
                         !auto_ph_correction_enabled_ ? "auto pH correction disabled" : "night mode active");
            } else {
                ESP_LOGI(TAG, "========================================================");
                ESP_LOGI(TAG, "  AUTOMATIC pH CHECK (time-based: every %u hours)",
                         ph_interval_ms / 3600000);
                ESP_LOGI(TAG, "========================================================");

                transitionTo(ControllerState::PH_PROCESSING);
                return;  // Exit IDLE immediately
            }
        }
    } else {
        // FALLBACK: millis()-based scheduling (no time source available)
        if (now - last_ph_check_time_ >= ph_interval_ms) {
            last_ph_check_time_ = now;

            if (!auto_ph_correction_enabled_ || (night_mode_enabled_ && isNightModeHours())) {
                ESP_LOGD(TAG, "Automatic pH check skipped — %s",
                         !auto_ph_correction_enabled_ ? "auto pH correction disabled" : "night mode active");
            } else {
                ESP_LOGW(TAG, "========================================================");
                ESP_LOGW(TAG, "  AUTOMATIC pH CHECK (fallback mode: no time source)");
                ESP_LOGW(TAG, "  Using boot-time based interval: every %u hours", ph_interval_ms / 3600000);
                ESP_LOGW(TAG, "========================================================");

                transitionTo(ControllerState::PH_PROCESSING);
                return;  // Exit IDLE immediately
            }
        }
    }

    // ========================================================================
    // POST-FILL EC CHECK - triggered by auto_ec_check_pending_ after WATER_FILLING
    // Requires: auto-feeding enabled, not night mode hours
    // ========================================================================
    if (auto_ec_check_pending_ && auto_feeding_enabled_ && !(night_mode_enabled_ && isNightModeHours())) {
        ESP_LOGI(TAG, "========================================================");
        ESP_LOGI(TAG, "  EC CHECK TRIGGERED (post water fill)");
        ESP_LOGI(TAG, "========================================================");
        transitionTo(ControllerState::EC_PROCESSING);
        return;
    }

    // Check if night mode hours started - transition to NIGHT
    if (night_mode_enabled_ && isNightModeHours()) {
        ESP_LOGI(TAG, "Night mode hours started - transitioning to NIGHT state");
        transitionTo(ControllerState::NIGHT);
        return;
    }

    // ========================================================================
    // SHELLY HEALTH CHECK - Ping Shelly device periodically (every 30 seconds)
    // ========================================================================
    checkShellyHealth();

    // ========================================================================
    // AUTOMATIC FEEDING CHECK - Once per day when water level reaches LOW
    // ========================================================================
    if (shouldTriggerAutoFeeding()) {
        ESP_LOGI(TAG, "========================================");
        ESP_LOGI(TAG, "AUTO-FEEDING TRIGGERED");
        ESP_LOGI(TAG, "========================================");
        ESP_LOGI(TAG, "[AUTO-FEEDING] Water level at LOW - triggering daily feed");

        // Record today's date
        int64_t today = getCurrentDateTimestamp();
        if (today > 0) {
            last_auto_feed_date_ = today;

            // Save to NVS with unique key per date
            if (psm_) {
                char date_key[32];
                snprintf(date_key, sizeof(date_key), "AUTOFEED_%lld", (long long)today);
                psm_->logEvent(date_key, 0);  // 0 = STARTED

                ESP_LOGI(TAG, "[AUTO-FEEDING] Stored trigger date: %lld", (long long)today);
            }
        }

        // Start feeding sequence
        startFeed();
        return;
    }

    // ========================================================================
    // AUTOMATIC WATER FILL CHECK - When EMPTY sensor triggers (Phase 6)
    // ========================================================================
    if (auto_fill_enabled_ && hal_ && hal_->hasWaterLevelSensors()) {
        // Trigger when tank is empty (HIGH=OFF, LOW=OFF, EMPTY=ON)
        // and not in night mode / not auto-feeding about to trigger
        bool high = hal_->readWaterLevelHigh();
        bool low = hal_->readWaterLevelLow();
        bool empty = hal_->readWaterLevelEmpty();
        bool tank_empty = (!high && !low && empty);

        if (tank_empty && !(night_mode_enabled_ && isNightModeHours())) {
            ESP_LOGI(TAG, "========================================");
            ESP_LOGI(TAG, "AUTO-FILL TRIGGERED");
            ESP_LOGI(TAG, "========================================");
            ESP_LOGI(TAG, "[AUTO-FILL] EMPTY sensor active - starting water fill sequence");
            startFillTank();
            return;
        }
    }

    // ========================================================================
    // AUTOMATIC RESERVOIR CHANGE CHECK - Once per week on configured day
    // ========================================================================
    if (shouldTriggerAutoReservoirChange()) {
        ESP_LOGI(TAG, "========================================");
        ESP_LOGI(TAG, "  AUTO RESERVOIR CHANGE TRIGGERED");
        ESP_LOGI(TAG, "  (Weekly schedule - Day %d)", auto_reservoir_change_day_);
        ESP_LOGI(TAG, "========================================");

        // Record this week's trigger
        int64_t current_week = getCurrentWeekNumber();
        if (current_week > 0) {
            last_auto_reservoir_change_week_ = current_week;

            // Save to NVS with unique key per week
            if (psm_) {
                char week_key[32];
                snprintf(week_key, sizeof(week_key), "AUTORES_%lld", (long long)current_week);
                psm_->logEvent(week_key, 0);  // 0 = STARTED

                ESP_LOGI(TAG, "[AUTO-RES] Stored trigger week: %lld", (long long)current_week);
            }
        }

        // Start reservoir change sequence
        startReservoirChange();
        return;
    }

    // ========================================================================
    // SENSOR HEALTH CHECKS - Periodic (Phase 7)
    // Temperature alerts, plausibility checks, calibration reminders
    // ========================================================================
    if (now - last_sensor_health_check_time_ >= SENSOR_HEALTH_CHECK_INTERVAL_MS) {
        last_sensor_health_check_time_ = now;
        checkTemperatureAlerts();
        checkSensorPlausibility();
        checkWaterLevelPlausibility();
        checkCalibrationReminders();
    }
}

void PlantOSController::handleNight() {
    // Dim breathing green - night mode active
    // Similar to IDLE but no automatic pH monitoring, feeding, or water management

    uint32_t elapsed = getStateElapsed();

    // Periodically check PSM for SHUTDOWN or PAUSE states every 5 seconds
    // This handles cases where:
    // 1. State was set while system was running
    // 2. State restoration from INIT failed due to timing issues
    // 3. Component initialization order caused PSM to be unavailable during INIT
    static uint32_t last_psm_check = 0;
    uint32_t now = hal_->getSystemTime();

    if (now - last_psm_check >= 5000) {  // Check every 5 seconds
        last_psm_check = now;

        if (psm_ && psm_->hasEvent()) {
            esphome::persistent_state_manager::CriticalEventLog event = psm_->getLastEvent();
            std::string eventID(event.eventID);

            ESP_LOGD(TAG, ">>> NIGHT PSM CHECK: EventID='%s', Status=%d, Age=%lld sec",
                     eventID.c_str(), event.status, psm_->getEventAge());

            // Check for persistent states that should override NIGHT
            if (!eventID.empty()) {
                if (eventID == "STATE_SHUTDOWN") {
                    ESP_LOGW(TAG, ">>> PSM check: SHUTDOWN state detected - transitioning from NIGHT");
                    transitionTo(ControllerState::SHUTDOWN);
                    return;
                } else if (eventID == "STATE_PAUSE") {
                    ESP_LOGW(TAG, ">>> PSM check: PAUSE state detected - transitioning from NIGHT");
                    transitionTo(ControllerState::PAUSE);
                    return;
                }
            }
        }
    }

    // Check if night mode hours ended - transition back to IDLE
    if (!night_mode_enabled_ || !isNightModeHours()) {
        if (!night_mode_enabled_) {
            ESP_LOGI(TAG, "Night mode disabled - transitioning to IDLE state");
        } else {
            ESP_LOGI(TAG, "Night mode hours ended - transitioning to IDLE state");
        }
        transitionTo(ControllerState::IDLE);
        return;
    }

    // During night mode: No automatic pH monitoring, no feeding, no water management
    // Manual operations are still prevented by checking night mode in public API methods
}

void PlantOSController::handleShutdown() {
    // Solid yellow LED handled by LedBehaviorSystem
    // All actuators OFF, calendar/time-based events disabled
    // Persists across power cycles - must use setToIdle() to exit

    uint32_t elapsed = getStateElapsed();

    // On entry: Turn off all pumps and valves for safety (only once!)
    if (!state_entry_executed_) {
        state_entry_executed_ = true;
        turnOffAllPumps();
        ESP_LOGI(TAG, "SHUTDOWN state ACTIVE - all actuators OFF, calendar disabled");

        // Persist SHUTDOWN state to NVS
        if (psm_) {
            ESP_LOGW(TAG, ">>> SAVING TO PSM: STATE_SHUTDOWN (status=1)");
            psm_->logEvent("STATE_SHUTDOWN", 1);  // 1 = ENTERED_SHUTDOWN

            // Verify it was saved
            if (psm_->hasEvent()) {
                auto event = psm_->getLastEvent();
                ESP_LOGW(TAG, ">>> PSM VERIFICATION: EventID='%s', Status=%d",
                         event.eventID, event.status);
            }
        } else {
            ESP_LOGE(TAG, ">>> PSM NOT AVAILABLE - SHUTDOWN STATE NOT PERSISTED!");
        }

        // Update status logger
        status_logger_.updateMaintenanceMode(true);

        return;
    }

    // Stay in this state until setToIdle() is called
    // No automatic exit - persists across reboots
}

void PlantOSController::handlePause() {
    // Solid orange LED handled by LedBehaviorSystem
    // Actuators maintain current state, calendar/time-based events disabled
    // Persists across power cycles - must use setToIdle() to exit

    uint32_t elapsed = getStateElapsed();

    // On entry: Log state change (only once!)
    if (!state_entry_executed_) {
        state_entry_executed_ = true;
        ESP_LOGI(TAG, "PAUSE state ACTIVE - actuators maintained, calendar disabled");

        // Persist PAUSE state to NVS
        if (psm_) {
            ESP_LOGW(TAG, ">>> SAVING TO PSM: STATE_PAUSE (status=1)");
            psm_->logEvent("STATE_PAUSE", 1);  // 1 = ENTERED_PAUSE

            // Verify it was saved
            if (psm_->hasEvent()) {
                auto event = psm_->getLastEvent();
                ESP_LOGW(TAG, ">>> PSM VERIFICATION: EventID='%s', Status=%d",
                         event.eventID, event.status);
            }
        } else {
            ESP_LOGE(TAG, ">>> PSM NOT AVAILABLE - PAUSE STATE NOT PERSISTED!");
        }

        return;
    }

    // Stay in this state until setToIdle() is called
    // No automatic exit - persists across reboots
}

void PlantOSController::handleError() {
    // Fast red flash LED handled by LedBehaviorSystem
    // Error condition with automatic recovery to INIT after 5 seconds

    uint32_t elapsed = getStateElapsed();

    // On entry: Turn off all pumps for safety (only once!)
    if (!state_entry_executed_) {
        state_entry_executed_ = true;
        turnOffAllPumps();
        ESP_LOGE(TAG, "ERROR state: All pumps OFF for safety");
        return;
    }

    // Wait 5 seconds to display error
    if (elapsed >= ERROR_DURATION) {
        if (ENHANCED_ERROR_HANDLING_ENABLED) {
            // Resolve all active alerts (keep history for debugging)
            ESP_LOGI(TAG, "Error timeout - resolving alerts and restarting to INIT");

            // Original alerts
            status_logger_.resolveAlert("PH_CRITICAL");
            status_logger_.resolveAlert("PH_MAX_ATTEMPTS");
            status_logger_.resolveAlert("SENSOR_CRITICAL");
            status_logger_.resolveAlert("PH_SENSOR_CRITICAL");

            // New alerts from Phase 7
            status_logger_.resolveAlert("NO_PH_READINGS");
            status_logger_.resolveAlert("PUMP_REJECTION_ACID");
            status_logger_.resolveAlert("PUMP_REJECTION_NUTRIENT_A");
            status_logger_.resolveAlert("PUMP_REJECTION_NUTRIENT_B");
            status_logger_.resolveAlert("PUMP_REJECTION_NUTRIENT_C");
            status_logger_.resolveAlert("PUMP_REJECTION_WATER_VALVE");
            status_logger_.resolveAlert("PUMP_REJECTION_WASTEWATER");
            status_logger_.resolveAlert("PH_SENSOR_HARDWARE_FAILURE");
            status_logger_.resolveAlert("CALIBRATION_FAILED_MID");
            status_logger_.resolveAlert("CALIBRATION_FAILED_LOW");
            status_logger_.resolveAlert("CALIBRATION_FAILED_HIGH");
            status_logger_.resolveAlert("HARDWARE_HAL_MISSING");

            // Hardware detection alerts from Phase 8
            status_logger_.resolveAlert("HARDWARE_WATER_SENSOR_HIGH");
            status_logger_.resolveAlert("HARDWARE_WATER_SENSOR_EMPTY");
            status_logger_.resolveAlert("HARDWARE_WATER_SENSORS_MISSING");
        } else {
            // Legacy: clear alerts (backward compatible)
            ESP_LOGI(TAG, "Error timeout - clearing alerts and restarting to INIT");
            status_logger_.clearAlert("PH_CRITICAL");
            status_logger_.clearAlert("PH_MAX_ATTEMPTS");
            status_logger_.resolveAlert("SENSOR_CRITICAL");
        }

        transitionTo(ControllerState::INIT);
    }
}

void PlantOSController::handlePhMeasuring() {
    // Yellow pulse - stabilizing pH reading (5 minutes)
    // All pumps OFF for accurate measurement

    uint32_t elapsed = getStateElapsed();

    // On entry: Turn off all pumps for stabilization (only once!)
    if (!state_entry_executed_) {
        state_entry_executed_ = true;
        turnOffAllPumps();

        // Select stabilization duration based on context (Logikplan.md Phase 5)
        uint32_t stabilize_ms = PH_MEASURING_DURATION;
        if (ph_post_fill_stabilize_) {
            stabilize_ms = POST_FILL_STABILIZE_MS;
            ESP_LOGI(TAG, "pH measuring: All pumps OFF for 10-min stabilization (post water fill)");
        } else if (ph_post_feed_stabilize_) {
            stabilize_ms = POST_FEED_STABILIZE_MS;
            ESP_LOGI(TAG, "pH measuring: All pumps OFF for 5-min stabilization (post EC feeding)");
        } else {
            ESP_LOGI(TAG, "pH measuring: All pumps OFF for %.0fs stabilization",
                     stabilize_ms / 1000.0f);
        }

        // Consume the stabilization intent flags: latch the chosen duration for
        // this measuring run and clear the flags immediately, so they can never
        // linger past a single PH_MEASURING entry (e.g. if this state is aborted).
        ph_measuring_duration_ms_ = stabilize_ms;
        ph_post_fill_stabilize_ = false;
        ph_post_feed_stabilize_ = false;

        ph_readings_.clear(); // Reset readings buffer

        // Send temperature compensation before starting pH measurements
        sendTemperatureCompensation();

        return;
    }

    // Take pH readings every 5 seconds
    uint32_t reading_interval = elapsed / 5000; // Every 5 seconds
    if (reading_interval > state_counter_) {
        state_counter_ = reading_interval;

        if (hasPhValue()) {
            // Sensor has value - check if recovering from failures
            if (ENHANCED_ERROR_HANDLING_ENABLED && sensor_retry_state_.consecutive_failures > 0) {
                ESP_LOGI(TAG, "pH sensor recovered after %u failures", sensor_retry_state_.consecutive_failures);
                sensor_retry_state_.reset();
                status_logger_.resolveAlert("PH_SENSOR_CRITICAL");
            }

            float ph = readPH();
            ph_readings_.push_back(ph);
            ESP_LOGI(TAG, "pH reading #%d: %.2f", ph_readings_.size(), ph);

            // Check for critical pH (out of safe range 5.0-7.5)
            if (ph < 5.0f || ph > 7.5f) {
                ESP_LOGE(TAG, "CRITICAL pH DETECTED: %.2f (safe range: 5.0-7.5)", ph);

                // Log critical pH event to PSM for persistence
                if (psm_) {
                    // Only log once per measurement cycle to avoid spam
                    if (ph_readings_.size() == 1) {
                        psm_->logEvent("PH_CRITICAL", 2);  // 2 = ERROR status
                        ESP_LOGW(TAG, "Critical pH event logged to PSM for recovery tracking");
                    }
                }

                // Add alert to status logger
                std::string alert_msg = "pH outside safe range: " + std::to_string(ph) + " (safe: 5.0-7.5)";
                status_logger_.updateAlertStatus("PH_CRITICAL", alert_msg);
            } else {
                // pH back in safe range - clear critical event if it exists
                if (psm_ && ph_readings_.size() == 1) {
                    // Check if there's a PH_CRITICAL event and clear it
                    if (psm_->hasEvent()) {
                        esphome::persistent_state_manager::CriticalEventLog event = psm_->getLastEvent();
                        std::string eventID(event.eventID);
                        if (eventID == "PH_CRITICAL") {
                            psm_->clearEvent();
                            status_logger_.clearAlert("PH_CRITICAL");
                            ESP_LOGI(TAG, "pH returned to safe range - cleared PH_CRITICAL event");
                        }
                    }
                }
            }
        } else {
            // Sensor has no value - implement retry logic with exponential backoff
            if (ENHANCED_ERROR_HANDLING_ENABLED) {
                sensor_retry_state_.recordFailure();

                if (!sensor_retry_state_.shouldRetry()) {
                    // Max retries exceeded - abort with comprehensive error
                    ESP_LOGE(TAG, "pH sensor not responding after %u attempts - aborting measurement",
                             sensor_retry_state_.consecutive_failures);

                    status_logger_.updateAlertWithContext(
                        "PH_SENSOR_CRITICAL",
                        "pH sensor not responding after " + std::to_string(sensor_retry_state_.consecutive_failures) + " attempts",
                        "Sensor has no value: hasPhValue() returned false for " +
                            std::to_string(sensor_retry_state_.consecutive_failures) + " consecutive readings",
                        "Check sensor wiring (UART TX=GPIO18, RX=GPIO19), verify sensor power (5V), try sensor calibration from web UI",
                        "pH measurement phase, " + std::to_string(ph_readings_.size()) +
                            " readings collected before failure",
                        "Aborting to IDLE. System will retry pH correction on next cycle.",
                        0
                    );

                    sensor_retry_state_.reset();

                    // Clear any PH_CRITICAL event since measurement failed
                    if (psm_ && psm_->hasEvent()) {
                        esphome::persistent_state_manager::CriticalEventLog event = psm_->getLastEvent();
                        std::string eventID(event.eventID);
                        if (eventID == "PH_CRITICAL") {
                            psm_->clearEvent();
                        }
                    }

                    transitionTo(ControllerState::IDLE);
                    return;
                }

                // Check if backoff period is complete
                uint32_t current_time = hal_ ? hal_->getSystemTime() : 0;
                if (!sensor_retry_state_.isBackoffComplete(current_time)) {
                    // Still in backoff - wait
                    uint32_t wait_time = (current_time - sensor_retry_state_.last_failure_time) / 1000;
                    uint32_t backoff_sec = sensor_retry_state_.backoff_delay_ms / 1000;
                    ESP_LOGD(TAG, "Sensor backoff: waiting %u/%u seconds",
                             wait_time, backoff_sec);
                    return;
                }

                // Backoff complete - ready for retry
                ESP_LOGW(TAG, "pH sensor retry attempt %u/%u (backoff: %u ms)",
                         sensor_retry_state_.consecutive_failures,
                         sensor_retry_state_.MAX_SENSOR_RETRIES,
                         sensor_retry_state_.backoff_delay_ms);
            } else {
                // Legacy behavior - just log warning
                ESP_LOGW(TAG, "pH sensor has no value - waiting for reading");
            }
        }
    }

    // Wait for stabilization period (duration latched at entry - see entry block above)
    if (elapsed < ph_measuring_duration_ms_) {
        return;
    }

    // Measurement period complete - calculate robust average
    if (ph_readings_.empty()) {
        ESP_LOGE(TAG, "No pH readings collected - aborting correction");

        // Set comprehensive alert before ERROR transition
        status_logger_.updateAlertWithContext(
            "NO_PH_READINGS",
            "No pH readings collected during 5-minute measurement phase",
            "Sensor returned no values: hasPhValue() was false for entire measurement period",
            "Check pH sensor UART connection (TX=GPIO18, RX=GPIO19), verify sensor power (5V), try sensor calibration from web UI",
            "pH correction aborted during measurement phase after 5 minutes",
            "System will return to IDLE and can retry on next cycle",
            0
        );

        // Clear any PH_CRITICAL event since measurement failed
        if (psm_ && psm_->hasEvent()) {
            esphome::persistent_state_manager::CriticalEventLog event = psm_->getLastEvent();
            std::string eventID(event.eventID);
            if (eventID == "PH_CRITICAL") {
                psm_->clearEvent();
            }
        }

        transitionTo(ControllerState::ERROR);
        return;
    }

    ph_current_ = calculateRobustPhAverage();
    ESP_LOGI(TAG, "pH stabilization complete. Robust average: %.2f (from %d readings)",
             ph_current_, ph_readings_.size());

    transitionTo(ControllerState::PH_CALCULATING);
}

void PlantOSController::handlePhCalculating() {
    // Yellow fast blink - determining pH adjustment
    // Decision point: Does pH need correction?

    // Get pH target range from calendar schedule for current grow day
    float target_min = PH_TARGET_MIN; // Fallback: 5.5
    float target_max = PH_TARGET_MAX; // Fallback: 6.5

    if (calendar_manager_) {
        // Use calendar manager's actual current day (not timestamp-based calculation)
        uint8_t current_day = calendar_manager_->get_current_day();
        auto schedule = calendar_manager_->get_schedule(current_day);
        target_min = schedule.target_ph_min;
        target_max = schedule.target_ph_max;
        ESP_LOGI(TAG, "pH: %.2f, Target (day %d): %.2f-%.2f (dose to midpoint: %.2f)",
                 ph_current_, current_day, target_min, target_max, (target_min + target_max) / 2.0f);
    } else {
        ESP_LOGI(TAG, "pH: %.2f, Target (default): %.2f-%.2f (dose to midpoint: %.2f)",
                 ph_current_, target_min, target_max, (target_min + target_max) / 2.0f);
    }

    // Check if pH is within target range
    if (ph_current_ >= target_min && ph_current_ <= target_max) {
        ESP_LOGI(TAG, "pH within target range - no correction needed");

        // Update K-factor if acid was actually dosed in this cycle
        if (ph_attempt_count_ > 0 && ph_cycle_total_ml_ > 0.1f) {
            updatePhKFactor(ph_cycle_start_ph_, ph_current_, ph_cycle_total_ml_);
        }

        // Record successful completion of pH correction operation
        recordOperationStep("pH_CORRECTION_SUCCESS");

        // Resolve any active pH-related alerts
        status_logger_.resolveAlert("PH_TOO_LOW");
        if (ENHANCED_ERROR_HANDLING_ENABLED) {
            status_logger_.resolveAlert("PH_CRITICAL");
            status_logger_.resolveAlert("NO_PH_READINGS");
            status_logger_.resolveAlert("PUMP_REJECTION_ACID");
            status_logger_.resolveAlert("PH_SENSOR_CRITICAL");
        }

        // Clear PSM event - pH correction complete
        if (psm_) {
            psm_->clearEvent();
        }

        transitionTo(ControllerState::IDLE);
        return;
    }

    // Check if pH is too low (cannot correct without a base pump)
    if (ph_current_ < target_min) {
        ESP_LOGW(TAG, "pH too low (%.2f < %.2f) - no base pump available, raising alert", ph_current_, target_min);
        char reason_buf[80];
        snprintf(reason_buf, sizeof(reason_buf), "pH %.2f below minimum %.2f", ph_current_, target_min);
        status_logger_.updateAlertWithContext(
            "PH_TOO_LOW",
            reason_buf,
            "pH too acidic — manual base addition required",
            "Detected in PH_CALCULATING after measurement cycle",
            "No base pump configured in system",
            "Add base solution manually or check acid pump for leaks"
        );
        transitionTo(ControllerState::IDLE);
        return;
    }

    // pH is too high - calculate required acid dose to reach midpoint of target range
    float ph_dose_target = (target_min + target_max) / 2.0f;
    float dose_ml = calculateAcidDoseML(ph_current_, ph_dose_target);

    // Check minimum dose threshold (avoid tiny corrections)
    if (dose_ml < 0.5f) {
        ESP_LOGI(TAG, "Calculated dose too small (%.1f mL < 0.5 mL) - skipping correction", dose_ml);
        transitionTo(ControllerState::IDLE);
        return;
    }

    // Convert mL to seconds using HAL pumpflow
    float dose_seconds = hal_->pumpflow("AcidPump", dose_ml);
    uint32_t dose_ms = static_cast<uint32_t>(dose_seconds * 1000.0f);

    // Check max attempts to prevent infinite loops
    if (ph_attempt_count_ >= MAX_PH_ATTEMPTS) {
        ESP_LOGE(TAG, "Max pH correction attempts reached (%d) - aborting", MAX_PH_ATTEMPTS);
        // Phase 7: Update alert status here
        transitionTo(ControllerState::IDLE);
        return;
    }

    // Proceed with injection
    ph_dose_ml_ = dose_ml;
    ph_dose_duration_ms_ = dose_ms;
    ph_attempt_count_++;

    // Track cycle start pH for K-factor learning (only on first injection)
    if (ph_attempt_count_ == 1) {
        ph_cycle_start_ph_ = ph_current_;
        ph_cycle_total_ml_ = 0.0f;
        ph_cycle_water_filled_ = false;
        ph_cycle_aborted_ = false;
        ESP_LOGI(TAG, "pH correction cycle started: start_pH=%.2f", ph_cycle_start_ph_);
    }

    ESP_LOGI(TAG, "pH correction needed: %.2f → %.2f (dose: %.1f mL = %.2f sec, attempt %d/%d)",
             ph_current_, target_max, dose_ml, dose_seconds, ph_attempt_count_, MAX_PH_ATTEMPTS);

    transitionTo(ControllerState::PH_INJECTING);
}

void PlantOSController::handlePhInjecting() {
    // Cyan pulse - acid dosing in progress
    // Air pump + Acid pump active (or acid pump only if no air pump)

    uint32_t elapsed = getStateElapsed();

    // On entry: Activate pumps (only once!)
    if (!state_entry_executed_) {
        state_entry_executed_ = true;

        // Calculate injection duration in seconds (round up)
        uint32_t injection_sec = (ph_dose_duration_ms_ + 999) / 1000;

        // Calculate mixing duration (same as handlePhMixing does)
        uint32_t mixing_duration_ms = calculatePhMixingDuration();
        uint32_t mixing_sec = (mixing_duration_ms + 999) / 1000;

        ESP_LOGI(TAG, "Starting acid injection: %.1f mL (%.2f sec)", ph_dose_ml_, injection_sec / 1.0f);

        // OPTIONAL: air pump cycling during pH injection — disabled based on test results.
        // Re-enable if poor acid mixing or pH measurement drift is observed.
        // if (safety_gate_) {
        //     uint32_t total_air_pump_sec = injection_sec + mixing_sec;
        //     std::vector<uint32_t> pattern = {total_air_pump_sec};
        //     if (!safety_gate_->setAirPumpPattern(pattern, true)) {
        //         ESP_LOGW(TAG, "AirPump pattern rejected - falling back to simple ON");
        //         requestPump(AIR_PUMP, true, 0);
        //     } else {
        //         ESP_LOGI(TAG, "AirPump pattern sent: %u sec", total_air_pump_sec);
        //     }
        // }

        // Request acid pump via SafetyGate with adaptive duration (will auto-adapt if needed)
        if (!requestPumpAdaptive(ACID_PUMP, true, injection_sec, false)) {
            ESP_LOGE(TAG, "Acid pump rejected by SafetyGate even after adaptation - aborting");
            // OPTIONAL: stop air pump sequence on abort — disabled (air pump not used during pH injection).
            // if (safety_gate_) { safety_gate_->stopAirPumpSequence(true); }

            // Set comprehensive alert before ERROR transition
            status_logger_.updateAlertWithContext(
                "PUMP_REJECTION_ACID",
                "Acid pump rejected by SafetyGate",
                "SafetyGate rejected acid pump command even after duration adaptation",
                "Check acid pump wiring, verify pump not stuck, check SafetyGate max duration config",
                "pH correction attempt " + std::to_string(ph_attempt_count_ + 1) + "/" +
                    std::to_string(MAX_PH_ATTEMPTS) + ", injection phase",
                "Aborting pH correction. Will retry on next cycle.",
                0
            );

            transitionTo(ControllerState::ERROR);
            return;
        }

        ESP_LOGI(TAG, "Acid pump active - dosing %.1f mL", ph_dose_ml_);

        // CRITICAL FIX: Reset timer to start from NOW (after HTTP delays)
        // The AirPump HTTP request is async, but we reset timer for consistency.
        state_start_time_ = hal_->getSystemTime();
        ESP_LOGD(TAG, "Timer reset: injection duration starts now");

        return;
    }

    // Wait for injection duration + 200ms safety margin
    uint32_t total_duration = ph_dose_duration_ms_ + 200;

    if (elapsed >= total_duration) {
        // Injection complete - explicitly stop acid pump
        requestPump(ACID_PUMP, false);

        // Accumulate total mL dosed in this correction cycle
        ph_cycle_total_ml_ += ph_dose_ml_;
        ESP_LOGI(TAG, "Acid dosing complete: %.1f mL added (cycle total: %.2f mL) - starting mixing phase",
                 ph_dose_ml_, ph_cycle_total_ml_);

        transitionTo(ControllerState::PH_MIXING);
    }
}

void PlantOSController::handlePhMixing() {
    // Blue pulse - mixing after acid injection
    // Air pump runs to distribute acid throughout tank (duration varies by tank volume)
    // NOTE: AirPump is controlled via Shelly pattern API - pattern was sent in PH_INJECTING
    uint32_t elapsed = getStateElapsed();

    // On entry: Calculate mixing duration for timer only (air pump already running via pattern)
    if (!state_entry_executed_) {
        state_entry_executed_ = true;

        // Calculate mixing duration based on tank volume (linear: 1.7L→30s, 70L→120s)
        ph_mixing_duration_ms_ = calculatePhMixingDuration();

        ESP_LOGI(TAG, "Mixing phase: waiting %.1f seconds (air pump controlled by Shelly pattern)",
                 ph_mixing_duration_ms_ / 1000.0f);

        // No air pump commands here - Shelly pattern handles the full injection+mixing duration
    }

    if (elapsed >= ph_mixing_duration_ms_) {
        ESP_LOGI(TAG, "pH mixing complete (%.1f seconds)", ph_mixing_duration_ms_ / 1000.0f);

        // OPTIONAL: restore air pump cycling after pH mixing — disabled (air pump not used during pH correction).
        // Re-enable if mixing quality needs improvement:
        // if (safety_gate_ && safety_gate_->isCyclingEnabled(AIR_PUMP)) {
        //     ESP_LOGI(TAG, "Restoring AirPump cycling pattern");
        //     safety_gate_->enableCycling(AIR_PUMP, true);
        // }

        // Loop back to PH_MEASURING to verify correction
        // Will continue until pH is in range OR max attempts reached
        ESP_LOGI(TAG, "Re-measuring pH to verify correction (attempt %d/%d)",
                 ph_attempt_count_, MAX_PH_ATTEMPTS);

        transitionTo(ControllerState::PH_MEASURING);
    }
}

void PlantOSController::handlePhCalibrating() {
    // Yellow fast blink - pH sensor calibration with robust averaging
    // 3-point calibration sequence: Mid (7.00) → Low (4.00) → High (10.01)
    // Each point waits for stable readings before proceeding

    if (!hal_) {
        ESP_LOGE(TAG, "HAL not configured - cannot calibrate");
        transitionTo(ControllerState::ERROR);
        return;
    }

    // Check if sensor hardware is actually connected and responding
    if (!hal_->isPhSensorReady()) {
        ESP_LOGE(TAG, "pH sensor hardware not responding - calibration aborted");
        ESP_LOGE(TAG, "Check UART connection (TX=GPIO18, RX=GPIO19) and power to sensor");

        // Set comprehensive alert before ERROR transition
        status_logger_.updateAlertWithContext(
            "PH_SENSOR_HARDWARE_FAILURE",
            "pH sensor hardware not responding",
            "Sensor readiness check failed: isPhSensorReady() returned false",
            "Check UART connection (TX=GPIO18, RX=GPIO19), verify sensor power (5V), inspect sensor LED status",
            "Calibration aborted during initialization",
            "Fix hardware connection and retry calibration from web UI",
            0
        );

        // Ensure verbose mode is off even on error
        hal_->setPhVerbose(false);
        transitionTo(ControllerState::ERROR);
        return;
    }

    uint32_t now = esphome::millis();
    uint32_t elapsed = now - calib_step_start_time_;

    switch (calib_step_) {
        // ====================================================================
        // MID-POINT CALIBRATION (pH 7.00)
        // ====================================================================
        case CalibrationStep::MID_PROMPT:
            if (elapsed < 100) {  // Log prompt once at start
                ESP_LOGI(TAG, "");
                ESP_LOGI(TAG, "===========================================================");
                ESP_LOGI(TAG, "  STEP 1/3: MID-POINT CALIBRATION (pH 7.00)");
                ESP_LOGI(TAG, "===========================================================");
                ESP_LOGI(TAG, "1. Insert pH probe into pH 7.00 buffer solution");
                ESP_LOGI(TAG, "2. Waiting %d seconds for stability check...", CALIB_PROMPT_DURATION / 1000);
                ESP_LOGI(TAG, "");
            }

            if (elapsed >= CALIB_PROMPT_DURATION) {
                ESP_LOGI(TAG, "Starting stability check for mid-point calibration...");

                // Send temperature compensation before calibration readings
                sendTemperatureCompensation();

                resetCalibrationBatch();
                calib_step_ = CalibrationStep::MID_STABILIZING;
                calib_step_start_time_ = now;
            }
            break;

        case CalibrationStep::MID_STABILIZING:
            // Take readings (20 per batch, 1/second, 5 batches with 30s wait between)
            if (calib_readings_in_batch_ < CALIB_READINGS_PER_BATCH) {
                // Log when starting a new batch
                if (calib_readings_in_batch_ == 0 && calib_current_batch_ < CALIB_TOTAL_BATCHES) {
                    // Only log once when starting the batch (avoid spamming)
                    static int last_logged_batch = -1;
                    if (last_logged_batch != calib_current_batch_) {
                        ESP_LOGI(TAG, "MID: Starting batch %d/%d - Taking %d readings at 1-second intervals",
                                calib_current_batch_ + 1, CALIB_TOTAL_BATCHES, CALIB_READINGS_PER_BATCH);
                        last_logged_batch = calib_current_batch_;
                    }
                }

                // Time to take next reading?
                if (now - calib_last_reading_time_ >= CALIB_READING_INTERVAL) {
                    float ph_value;
                    if (hal_->takeSinglePhReading(ph_value)) {
                        calib_batch_sum_ += ph_value;
                        calib_readings_in_batch_++;
                        calib_last_reading_time_ = now;
                        ESP_LOGD(TAG, "MID: Batch %d, Reading %d/%d: pH %.2f",
                                calib_current_batch_ + 1, calib_readings_in_batch_,
                                CALIB_READINGS_PER_BATCH, ph_value);
                    } else {
                        ESP_LOGW(TAG, "Failed to take pH reading - retrying");
                    }
                }
            } else {
                // Batch complete - calculate average
                float batch_avg = calib_batch_sum_ / CALIB_READINGS_PER_BATCH;
                calib_batch_averages_[calib_current_batch_] = batch_avg;
                ESP_LOGI(TAG, "MID: Batch %d/%d complete - Average: pH %.2f (Total readings: %d)",
                        calib_current_batch_ + 1, CALIB_TOTAL_BATCHES, batch_avg,
                        (calib_current_batch_ + 1) * CALIB_READINGS_PER_BATCH);

                calib_current_batch_++;

                if (calib_current_batch_ >= CALIB_TOTAL_BATCHES) {
                    // All batches complete - check stability
                    if (checkCalibrationStability()) {
                        ESP_LOGI(TAG, "MID: Readings are STABLE - proceeding to calibration");
                        calib_step_ = CalibrationStep::MID_CALIBRATE;
                        calib_step_start_time_ = now;
                    } else {
                        ESP_LOGW(TAG, "MID: Readings NOT stable - restarting stability check");
                        resetCalibrationBatch();
                    }
                } else {
                    // Wait 30 seconds before next batch
                    ESP_LOGI(TAG, "MID: Waiting %d seconds before next batch...", CALIB_BATCH_WAIT / 1000);
                    calib_batch_complete_time_ = now;
                    calib_readings_in_batch_ = 0;  // Reset for next batch
                    calib_batch_sum_ = 0.0f;
                }
            }

            // Handle wait between batches
            if (calib_readings_in_batch_ == 0 && calib_current_batch_ > 0 &&
                calib_current_batch_ < CALIB_TOTAL_BATCHES) {
                if (now - calib_batch_complete_time_ < CALIB_BATCH_WAIT) {
                    // Still waiting
                    return;
                }
            }
            break;

        case CalibrationStep::MID_CALIBRATE:
            ESP_LOGI(TAG, "Sending mid-point calibration command at pH 7.00...");
            if (!hal_->startPhCalibration(7.00f, 0)) {  // 0 = mid
                ESP_LOGE(TAG, "MID: Calibration command FAILED");

                // Set comprehensive alert before ERROR transition
                status_logger_.updateAlertWithContext(
                    "CALIBRATION_FAILED_MID",
                    "Mid-point calibration command failed (pH 7.00)",
                    "HAL calibration command returned false for mid-point (pH 7.00)",
                    "Verify pH sensor in pH 7.00 buffer solution, check sensor stability, retry calibration",
                    "3-point calibration: Step 1 of 3 (mid-point) failed",
                    "Calibration aborted. Verify buffer solution and sensor condition, then retry.",
                    0
                );

                // Ensure verbose mode is off even on error
                hal_->setPhVerbose(false);
                transitionTo(ControllerState::ERROR);
                return;
            } else {
                ESP_LOGI(TAG, "✓ MID: Calibration command sent successfully");
            }
            calib_step_ = CalibrationStep::MID_COMPLETE;
            calib_step_start_time_ = now;
            break;

        case CalibrationStep::MID_COMPLETE:
            if (elapsed >= 1000) {  // Wait 1s for command to complete
                ESP_LOGI(TAG, "MID: Mid-point calibration complete!");
                calib_step_ = CalibrationStep::LOW_PROMPT;
                calib_step_start_time_ = now;
            }
            break;

        // ====================================================================
        // LOW-POINT CALIBRATION (pH 4.00)
        // ====================================================================
        case CalibrationStep::LOW_PROMPT:
            if (elapsed < 100) {
                ESP_LOGI(TAG, "");
                ESP_LOGI(TAG, "===========================================================");
                ESP_LOGI(TAG, "  STEP 2/3: LOW-POINT CALIBRATION (pH 4.00)");
                ESP_LOGI(TAG, "===========================================================");
                ESP_LOGI(TAG, "1. Remove probe and rinse with distilled water");
                ESP_LOGI(TAG, "2. Insert pH probe into pH 4.00 buffer solution");
                ESP_LOGI(TAG, "3. Waiting %d seconds for stability check...", CALIB_PROMPT_DURATION / 1000);
                ESP_LOGI(TAG, "");
            }

            if (elapsed >= CALIB_PROMPT_DURATION) {
                ESP_LOGI(TAG, "Starting stability check for low-point calibration...");

                // Send temperature compensation before calibration readings
                sendTemperatureCompensation();

                resetCalibrationBatch();
                calib_step_ = CalibrationStep::LOW_STABILIZING;
                calib_step_start_time_ = now;
            }
            break;

        case CalibrationStep::LOW_STABILIZING:
            // Same logic as MID_STABILIZING
            if (calib_readings_in_batch_ < CALIB_READINGS_PER_BATCH) {
                // Log when starting a new batch
                if (calib_readings_in_batch_ == 0 && calib_current_batch_ < CALIB_TOTAL_BATCHES) {
                    // Only log once when starting the batch (avoid spamming)
                    static int last_logged_batch = -1;
                    if (last_logged_batch != calib_current_batch_) {
                        ESP_LOGI(TAG, "LOW: Starting batch %d/%d - Taking %d readings at 1-second intervals",
                                calib_current_batch_ + 1, CALIB_TOTAL_BATCHES, CALIB_READINGS_PER_BATCH);
                        last_logged_batch = calib_current_batch_;
                    }
                }

                if (now - calib_last_reading_time_ >= CALIB_READING_INTERVAL) {
                    float ph_value;
                    if (hal_->takeSinglePhReading(ph_value)) {
                        calib_batch_sum_ += ph_value;
                        calib_readings_in_batch_++;
                        calib_last_reading_time_ = now;
                        ESP_LOGD(TAG, "LOW: Batch %d, Reading %d/%d: pH %.2f",
                                calib_current_batch_ + 1, calib_readings_in_batch_,
                                CALIB_READINGS_PER_BATCH, ph_value);
                    }
                }
            } else {
                float batch_avg = calib_batch_sum_ / CALIB_READINGS_PER_BATCH;
                calib_batch_averages_[calib_current_batch_] = batch_avg;
                ESP_LOGI(TAG, "LOW: Batch %d/%d complete - Average: pH %.2f (Total readings: %d)",
                        calib_current_batch_ + 1, CALIB_TOTAL_BATCHES, batch_avg,
                        (calib_current_batch_ + 1) * CALIB_READINGS_PER_BATCH);

                calib_current_batch_++;

                if (calib_current_batch_ >= CALIB_TOTAL_BATCHES) {
                    if (checkCalibrationStability()) {
                        ESP_LOGI(TAG, "LOW: Readings are STABLE - proceeding to calibration");
                        calib_step_ = CalibrationStep::LOW_CALIBRATE;
                        calib_step_start_time_ = now;
                    } else {
                        ESP_LOGW(TAG, "LOW: Readings NOT stable - restarting stability check");
                        resetCalibrationBatch();
                    }
                } else {
                    ESP_LOGI(TAG, "LOW: Waiting %d seconds before next batch...", CALIB_BATCH_WAIT / 1000);
                    calib_batch_complete_time_ = now;
                    calib_readings_in_batch_ = 0;
                    calib_batch_sum_ = 0.0f;
                }
            }

            if (calib_readings_in_batch_ == 0 && calib_current_batch_ > 0 &&
                calib_current_batch_ < CALIB_TOTAL_BATCHES) {
                if (now - calib_batch_complete_time_ < CALIB_BATCH_WAIT) {
                    return;
                }
            }
            break;

        case CalibrationStep::LOW_CALIBRATE:
            ESP_LOGI(TAG, "Sending low-point calibration command at pH 4.00...");
            if (!hal_->startPhCalibration(4.00f, 1)) {  // 1 = low
                ESP_LOGE(TAG, "LOW: Calibration command FAILED");

                // Set comprehensive alert before ERROR transition
                status_logger_.updateAlertWithContext(
                    "CALIBRATION_FAILED_LOW",
                    "Low-point calibration command failed (pH 4.00)",
                    "HAL calibration command returned false for low-point (pH 4.00)",
                    "Verify pH sensor in pH 4.00 buffer solution, check sensor stability, retry calibration",
                    "3-point calibration: Step 2 of 3 (low-point) failed",
                    "Calibration aborted. Verify buffer solution and sensor condition, then retry.",
                    0
                );

                // Ensure verbose mode is off even on error
                hal_->setPhVerbose(false);
                transitionTo(ControllerState::ERROR);
                return;
            } else {
                ESP_LOGI(TAG, "✓ LOW: Calibration command sent successfully");
            }
            calib_step_ = CalibrationStep::LOW_COMPLETE;
            calib_step_start_time_ = now;
            break;

        case CalibrationStep::LOW_COMPLETE:
            if (elapsed >= 1000) {
                ESP_LOGI(TAG, "LOW: Low-point calibration complete!");
                calib_step_ = CalibrationStep::HIGH_PROMPT;
                calib_step_start_time_ = now;
            }
            break;

        // ====================================================================
        // HIGH-POINT CALIBRATION (pH 10.01)
        // ====================================================================
        case CalibrationStep::HIGH_PROMPT:
            if (elapsed < 100) {
                ESP_LOGI(TAG, "");
                ESP_LOGI(TAG, "===========================================================");
                ESP_LOGI(TAG, "  STEP 3/3: HIGH-POINT CALIBRATION (pH 10.01)");
                ESP_LOGI(TAG, "===========================================================");
                ESP_LOGI(TAG, "1. Remove probe and rinse with distilled water");
                ESP_LOGI(TAG, "2. Insert pH probe into pH 10.01 buffer solution");
                ESP_LOGI(TAG, "3. Waiting %d seconds for stability check...", CALIB_PROMPT_DURATION / 1000);
                ESP_LOGI(TAG, "");
            }

            if (elapsed >= CALIB_PROMPT_DURATION) {
                ESP_LOGI(TAG, "Starting stability check for high-point calibration...");

                // Send temperature compensation before calibration readings
                sendTemperatureCompensation();

                resetCalibrationBatch();
                calib_step_ = CalibrationStep::HIGH_STABILIZING;
                calib_step_start_time_ = now;
            }
            break;

        case CalibrationStep::HIGH_STABILIZING:
            // Same logic as MID_STABILIZING and LOW_STABILIZING
            if (calib_readings_in_batch_ < CALIB_READINGS_PER_BATCH) {
                // Log when starting a new batch
                if (calib_readings_in_batch_ == 0 && calib_current_batch_ < CALIB_TOTAL_BATCHES) {
                    // Only log once when starting the batch (avoid spamming)
                    static int last_logged_batch = -1;
                    if (last_logged_batch != calib_current_batch_) {
                        ESP_LOGI(TAG, "HIGH: Starting batch %d/%d - Taking %d readings at 1-second intervals",
                                calib_current_batch_ + 1, CALIB_TOTAL_BATCHES, CALIB_READINGS_PER_BATCH);
                        last_logged_batch = calib_current_batch_;
                    }
                }

                if (now - calib_last_reading_time_ >= CALIB_READING_INTERVAL) {
                    float ph_value;
                    if (hal_->takeSinglePhReading(ph_value)) {
                        calib_batch_sum_ += ph_value;
                        calib_readings_in_batch_++;
                        calib_last_reading_time_ = now;
                        ESP_LOGD(TAG, "HIGH: Batch %d, Reading %d/%d: pH %.2f",
                                calib_current_batch_ + 1, calib_readings_in_batch_,
                                CALIB_READINGS_PER_BATCH, ph_value);
                    }
                }
            } else {
                float batch_avg = calib_batch_sum_ / CALIB_READINGS_PER_BATCH;
                calib_batch_averages_[calib_current_batch_] = batch_avg;
                ESP_LOGI(TAG, "HIGH: Batch %d/%d complete - Average: pH %.2f (Total readings: %d)",
                        calib_current_batch_ + 1, CALIB_TOTAL_BATCHES, batch_avg,
                        (calib_current_batch_ + 1) * CALIB_READINGS_PER_BATCH);

                calib_current_batch_++;

                if (calib_current_batch_ >= CALIB_TOTAL_BATCHES) {
                    if (checkCalibrationStability()) {
                        ESP_LOGI(TAG, "HIGH: Readings are STABLE - proceeding to calibration");
                        calib_step_ = CalibrationStep::HIGH_CALIBRATE;
                        calib_step_start_time_ = now;
                    } else {
                        ESP_LOGW(TAG, "HIGH: Readings NOT stable - restarting stability check");
                        resetCalibrationBatch();
                    }
                } else {
                    ESP_LOGI(TAG, "HIGH: Waiting %d seconds before next batch...", CALIB_BATCH_WAIT / 1000);
                    calib_batch_complete_time_ = now;
                    calib_readings_in_batch_ = 0;
                    calib_batch_sum_ = 0.0f;
                }
            }

            if (calib_readings_in_batch_ == 0 && calib_current_batch_ > 0 &&
                calib_current_batch_ < CALIB_TOTAL_BATCHES) {
                if (now - calib_batch_complete_time_ < CALIB_BATCH_WAIT) {
                    return;
                }
            }
            break;

        case CalibrationStep::HIGH_CALIBRATE:
            ESP_LOGI(TAG, "Sending high-point calibration command at pH 10.01...");
            if (!hal_->startPhCalibration(10.01f, 2)) {  // 2 = high
                ESP_LOGE(TAG, "HIGH: Calibration command FAILED");

                // Set comprehensive alert before ERROR transition
                status_logger_.updateAlertWithContext(
                    "CALIBRATION_FAILED_HIGH",
                    "High-point calibration command failed (pH 10.01)",
                    "HAL calibration command returned false for high-point (pH 10.01)",
                    "Verify pH sensor in pH 10.01 buffer solution, check sensor stability, retry calibration",
                    "3-point calibration: Step 3 of 3 (high-point) failed",
                    "Calibration aborted. Verify buffer solution and sensor condition, then retry.",
                    0
                );

                // Ensure verbose mode is off even on error
                hal_->setPhVerbose(false);
                transitionTo(ControllerState::ERROR);
                return;
            } else {
                ESP_LOGI(TAG, "✓ HIGH: Calibration command sent successfully");
            }
            calib_step_ = CalibrationStep::HIGH_COMPLETE;
            calib_step_start_time_ = now;
            break;

        case CalibrationStep::HIGH_COMPLETE:
            if (elapsed >= 1000) {
                ESP_LOGI(TAG, "HIGH: High-point calibration complete!");
                calib_step_ = CalibrationStep::COMPLETE;
                calib_step_start_time_ = now;
            }
            break;

        // ====================================================================
        // CALIBRATION COMPLETE
        // ====================================================================
        case CalibrationStep::COMPLETE:
            ESP_LOGI(TAG, "");
            ESP_LOGI(TAG, "===========================================================");
            ESP_LOGI(TAG, "  3-POINT pH CALIBRATION COMPLETE!");
            ESP_LOGI(TAG, "===========================================================");
            ESP_LOGI(TAG, "Remove probe from buffer solution");
            ESP_LOGI(TAG, "Rinse with distilled water and return to tank");
            ESP_LOGI(TAG, "System returning to IDLE state...");
            ESP_LOGI(TAG, "");

            // Disable verbose mode - calibration complete
            hal_->setPhVerbose(false);
            ESP_LOGI(TAG, "Verbose mode DISABLED - returning to normal operation");

            // Query calibration status to verify
            hal_->queryPhCalibrationStatus();

            // Clear any calibration failure alerts from previous attempts
            status_logger_.resolveAlert("CALIBRATION_FAILED_MID");
            status_logger_.resolveAlert("CALIBRATION_FAILED_LOW");
            status_logger_.resolveAlert("CALIBRATION_FAILED_HIGH");

            // Save pH calibration timestamp for reminder tracking (Phase 7)
            if (psm_ && hal_ && hal_->hasTime()) {
                last_ph_calibration_ts_ = hal_->getCurrentTimestamp();
                psm_->saveInt32(NVS_KEY_PH_CALIB_TS, (int32_t)last_ph_calibration_ts_);
                ESP_LOGI(TAG, "pH calibration timestamp saved: %lld", (long long)last_ph_calibration_ts_);
                status_logger_.clearAlert("PH_CALIBRATION_DUE");
            }

            // Clear PSM event
            if (psm_) {
                psm_->clearEvent();
            }

            // Reset calibration state
            calib_step_ = CalibrationStep::IDLE;

            // Return to IDLE
            transitionTo(ControllerState::IDLE);
            break;

        case CalibrationStep::IDLE:
        default:
            ESP_LOGW(TAG, "Unexpected calibration step");
            transitionTo(ControllerState::IDLE);
            break;
    }
}

void PlantOSController::handleFeeding() {
    // EC-dependent feeding: splits the day's total calendar dose into installments of 1/5,
    // doses A → B → C per installment, then mixes and measures EC.
    // Repeats until EC target is reached (or FEEDING_MANUAL_MAX_CYCLES safety cap).
    // If no EC target is configured (ec_target == 0), falls back to single-pass fixed dose.
    //
    // This state is a setup stage only — it calculates doses and immediately hands off
    // to the EC_FEEDING → EC_MIXING → EC_MEASURING loop.

    if (!hal_ || !calendar_manager_) {
        ESP_LOGW(TAG, "[FEEDING] Missing HAL or CalendarManager - aborting");
        if (psm_) psm_->clearEvent();
        transitionTo(ControllerState::IDLE);
        return;
    }

    sendTemperatureCompensation();

    uint8_t current_day = calendar_manager_->get_current_day();
    auto schedule = calendar_manager_->get_schedule(current_day);

    float tank_volume_liters = is_reservoir_change_
        ? hal_->getTotalTankVolume()
        : hal_->getTankVolumeDelta();

    ESP_LOGI(TAG, "[FEEDING] Day %d | %s volume: %.1fL | EC target: %.0f uS/cm",
             current_day,
             is_reservoir_change_ ? "TOTAL" : "DELTA",
             tank_volume_liters,
             schedule.ec_target);

    if (tank_volume_liters <= 0.0f) {
        ESP_LOGW(TAG, "[FEEDING] Tank volume unavailable — using 10 L fallback");
        tank_volume_liters = 10.0f;
    }

    // Full calendar dose (EC target multiplier is applied to the EC target, not the dose itself)
    float full_a = schedule.nutrient_A_ml_per_liter * tank_volume_liters;
    float full_b = schedule.nutrient_B_ml_per_liter * tank_volume_liters;
    float full_c = schedule.nutrient_C_ml_per_liter * tank_volume_liters;

    if (schedule.ec_target > 0.0f) {
        // EC-dependent mode: divide total dose into installments of 1/5 and iterate
        ec_dose_A_ml_ = full_a / 5.0f;
        ec_dose_B_ml_ = full_b / 5.0f;
        ec_dose_C_ml_ = full_c / 5.0f;

        ec_pre_feeding_ = hal_->hasECValue() ? hal_->readEC() : 0.0f;
        ec_total_ml_per_L_ = 0.0f;
        ec_attempt_count_ = 0;
        feeding_manual_mode_ = true;

        ESP_LOGI(TAG, "[FEEDING] EC mode: installment A=%.2f mL  B=%.2f mL  C=%.2f mL (1/5 of full dose)",
                 ec_dose_A_ml_, ec_dose_B_ml_, ec_dose_C_ml_);
        ESP_LOGI(TAG, "[FEEDING] EC before dosing: %.1f uS/cm  Target: %.0f uS/cm",
                 ec_pre_feeding_, schedule.ec_target);

        if (psm_) psm_->logEvent("EC_FEEDING", 0);
        transitionTo(ControllerState::EC_FEEDING);
    } else {
        // Fixed-dose fallback: single pass A → B → C when EC target not configured
        ec_dose_A_ml_ = full_a;
        ec_dose_B_ml_ = full_b;
        ec_dose_C_ml_ = full_c;
        feeding_manual_mode_ = false;

        ESP_LOGI(TAG, "[FEEDING] Fixed-dose mode (no EC target): A=%.2f mL  B=%.2f mL  C=%.2f mL",
                 ec_dose_A_ml_, ec_dose_B_ml_, ec_dose_C_ml_);

        if (psm_) psm_->logEvent("EC_FEEDING", 0);
        transitionTo(ControllerState::EC_FEEDING);
    }
}

void PlantOSController::handleFeedFilling() {
    // Blue solid LED handled by LedBehaviorSystem (same as WATER_FILLING)
    // This is the first phase of the Feed operation

    uint32_t elapsed = getStateElapsed();

    // Calculate max fill duration based on tank volume and valve flow rate
    // Formula: duration = (tank_volume_mL / valve_flow_rate_mL_s) × 1.2 (20% safety margin)
    uint32_t max_fill_duration_ms = 600000;  // Default fallback: 10 minutes
    uint32_t max_fill_duration_sec = 600;    // For SafetyGate command

    if (hal_) {
        // Select tank volume based on operation context:
        // - Normal feed: fills from LOW to HIGH → use delta volume
        // - Reservoir change: fills from EMPTY to HIGH → use total volume
        float tank_volume_L = is_reservoir_change_
            ? hal_->getTotalTankVolume()
            : hal_->getTankVolumeDelta();
        float tank_volume_mL = tank_volume_L * 1000.0f;

        // Use valveflow() to calculate fill duration for the appropriate tank volume
        float fill_duration_sec = hal_->valveflow(tank_volume_mL);

        // Add 20% safety margin
        fill_duration_sec *= 1.2f;

        max_fill_duration_ms = static_cast<uint32_t>(fill_duration_sec * 1000.0f);
        max_fill_duration_sec = static_cast<uint32_t>(fill_duration_sec);

        ESP_LOGI(TAG, "[FEED_FILLING] Calculated max fill time: %.1f sec (%.1fL %s volume with 20%% margin)",
                 fill_duration_sec, tank_volume_L,
                 is_reservoir_change_ ? "TOTAL" : "DELTA");
    } else {
        ESP_LOGW(TAG, "[FEED_FILLING] HAL not available - using fallback timeout of 10 min");
    }

    // ENTRY: Log and activate water valve (only once!)
    if (!state_entry_executed_) {
        state_entry_executed_ = true;
        ESP_LOGI(TAG, "[FEED_FILLING] Starting tank fill before nutrient dosing");

        // SAFETY: Abort if water level sensors are unavailable - filling blind
        // on a timeout with no level feedback risks tank overflow
        if (!hal_ || !hal_->hasWaterLevelSensors()) {
            ESP_LOGE(TAG, "[FEED_FILLING] SAFETY ABORT: water level sensors unavailable - refusing blind fill");

            if (ENHANCED_ERROR_HANDLING_ENABLED) {
                status_logger_.updateAlertWithContext(
                    "HARDWARE_WATER_SENSORS_MISSING",
                    "Water level sensors unavailable - fill aborted",
                    "hasWaterLevelSensors() returned false when starting FEED_FILLING",
                    "Check water level sensor configuration in plantOS.yaml and HAL wiring (HIGH=GPIO17, LOW=GPIO23, EMPTY=GPIO22)",
                    "Feed sequence aborted before filling to prevent overflow",
                    "Fix sensor configuration before feeding.",
                    0
                );
            }

            // Clear flags
            auto_ph_correction_pending_ = false;

            // Clear PSM event
            if (psm_) {
                psm_->clearEvent();
            }

            // Abort sequence
            transitionTo(ControllerState::IDLE);
            return;
        }

        // Safety check - verify tank is EMPTY before filling (all 3 sensors OFF)
        {
            bool high_sensor = hal_->readWaterLevelHigh();
            bool low_sensor = hal_->readWaterLevelLow();
            bool empty_sensor = hal_->readWaterLevelEmpty();

            // Tank must be empty: All sensors OFF
            bool tank_is_empty = (!high_sensor && !low_sensor && !empty_sensor);

            if (!tank_is_empty) {
                ESP_LOGE(TAG, "[FEED_FILLING] SAFETY ABORT: Tank not empty before fill");
                ESP_LOGE(TAG, "[FEED_FILLING] Sensors: HIGH=%s, LOW=%s, EMPTY=%s",
                         high_sensor ? "ON" : "OFF",
                         low_sensor ? "ON" : "OFF",
                         empty_sensor ? "ON" : "OFF");
                ESP_LOGE(TAG, "[FEED_FILLING] Tank must be completely drained before feeding");

                // Clear flags
                auto_ph_correction_pending_ = false;

                // Clear PSM event
                if (psm_) {
                    psm_->clearEvent();
                }

                // Abort sequence
                transitionTo(ControllerState::IDLE);
                return;
            }

            ESP_LOGI(TAG, "[FEED_FILLING] Safety check passed - tank empty (all sensors OFF)");
        }

        // Request water valve open with calculated max duration
        if (safety_gate_) {
            bool approved = safety_gate_->executeCommand(WATER_VALVE, true, max_fill_duration_sec);

            if (!approved) {
                ESP_LOGE(TAG, "[FEED_FILLING] SafetyGate rejected WaterValve command");

                // Clear flags
                auto_ph_correction_pending_ = false;

                // Clear PSM event
                if (psm_) {
                    psm_->clearEvent();
                }

                transitionTo(ControllerState::IDLE);
                return;
            }
        }

        ESP_LOGI(TAG, "[FEED_FILLING] Water valve OPENED (max duration: %d sec)", max_fill_duration_sec);
        return;
    }

    // MONITOR: Check water level sensors (if available)
    if (hal_->hasWaterLevelSensors()) {
        bool high_sensor = hal_->readWaterLevelHigh();
        bool low_sensor = hal_->readWaterLevelLow();

        // SUCCESS: Tank full when BOTH sensors are ON
        if (high_sensor && low_sensor) {
            ESP_LOGI(TAG, "[FEED_FILLING] BOTH sensors ON - tank full");
            ESP_LOGI(TAG, "[FEED_FILLING] Water level: HIGH=ON, LOW=ON");

            // Close water valve
            if (safety_gate_) {
                safety_gate_->executeCommand(WATER_VALVE, false, 0);
            }

            ESP_LOGI(TAG, "[FEED_FILLING] Fill complete - proceeding to nutrient dosing");

            // Transition to FEEDING (nutrients)
            // Note: auto_ph_correction_pending_ flag is already set
            transitionTo(ControllerState::FEEDING);
            return;
        }

        // LOG: Progress update every 5 seconds
        static uint32_t last_progress_log = 0;
        if (elapsed - last_progress_log >= 5000) {
            ESP_LOGI(TAG, "[FEED_FILLING] Filling in progress... HIGH=%s, LOW=%s",
                     high_sensor ? "ON" : "OFF", low_sensor ? "ON" : "OFF");
            last_progress_log = elapsed;
        }
    }

    // TIMEOUT: Safety backup - calculated max fill time
    if (elapsed >= max_fill_duration_ms) {
        ESP_LOGW(TAG, "[FEED_FILLING] Timeout reached (%d sec) - closing valve", max_fill_duration_sec);

        // Close water valve
        if (safety_gate_) {
            safety_gate_->executeCommand(WATER_VALVE, false, 0);
        }

        // Alert if sensors were expected but didn't trigger
        if (hal_->hasWaterLevelSensors()) {
            ESP_LOGE(TAG, "[FEED_FILLING] BOTH sensors never triggered - possible sensor failure or low water pressure");
        }

        ESP_LOGI(TAG, "[FEED_FILLING] Proceeding to nutrient dosing despite timeout");
        transitionTo(ControllerState::FEEDING);
        return;
    }
}

// ============================================================================
// EC Feeding State Handlers
// ============================================================================

void PlantOSController::handleEcProcessing() {
    // Yellow pulse - check EC reading and decide if feeding is needed
    if (!hal_) {
        transitionTo(ControllerState::ERROR);
        return;
    }

    // Guard: EC sensor must have a valid reading
    if (!hal_->hasECValue()) {
        ESP_LOGW(TAG, "[EC_PROCESSING] No EC reading available - skipping EC check");
        auto_ec_check_pending_ = false;
        transitionAfterEcSkipped();
        return;
    }

    // Guard: CalendarManager required for EC targets
    if (!calendar_manager_) {
        ESP_LOGD(TAG, "[EC_PROCESSING] No calendar manager - skipping EC check");
        auto_ec_check_pending_ = false;
        transitionAfterEcSkipped();
        return;
    }

    auto schedule = calendar_manager_->get_today_schedule();

    // Guard: EC feeding must be configured for today (ec_target == 0 means disabled)
    if (schedule.ec_target <= 0.0f) {
        ESP_LOGD(TAG, "[EC_PROCESSING] EC target not configured for day %d - skipping",
                 calendar_manager_->get_current_day());
        auto_ec_check_pending_ = false;
        transitionAfterEcSkipped();
        return;
    }

    // Guard: 4-hour minimum interval between actual feedings
    if (hal_->hasTime() && last_ec_feeding_timestamp_ > 0) {
        int64_t current_ts = hal_->getCurrentTimestamp();
        int64_t elapsed_s = current_ts - last_ec_feeding_timestamp_;
        if (elapsed_s < EC_MIN_INTERVAL_S) {
            int64_t wait_s = EC_MIN_INTERVAL_S - elapsed_s;
            ESP_LOGI(TAG, "[EC_PROCESSING] 12h guard: %lld/%lld s elapsed - %lld s remaining",
                     elapsed_s, EC_MIN_INTERVAL_S, wait_s);
            auto_ec_check_pending_ = false;
            transitionAfterEcSkipped();
            return;
        }
    }

    float ec_current = hal_->readEC();  // µS/cm
    float ec_target = schedule.ec_target * ec_target_multiplier_;  // calendar target scaled by slider
    float ec_min = ec_target - schedule.ec_tolerance;
    float ec_max = ec_target + schedule.ec_tolerance * 1.5f;

    ESP_LOGI(TAG, "[EC_PROCESSING] EC=%.1f uS/cm, target=%.0f (cal %.0f x %.2f) ±%.0f (min=%.0f, max=%.0f)",
             ec_current, ec_target, schedule.ec_target, ec_target_multiplier_,
             schedule.ec_tolerance, ec_min, ec_max);

    // Over-concentration: wait for natural evaporation to lower EC
    if (ec_current > ec_max) {
        ESP_LOGW(TAG, "[EC_PROCESSING] EC over-concentration (%.1f > %.1f uS/cm) - no feeding, add plain water",
                 ec_current, ec_max);
        status_logger_.updateAlertStatus("EC_HIGH", "EC over-concentration - add plain water or wait");
        auto_ec_check_pending_ = false;
        transitionAfterEcSkipped();
        return;
    }

    // EC in acceptable window - no feeding needed
    if (ec_current >= ec_min) {
        ESP_LOGD(TAG, "[EC_PROCESSING] EC in range [%.2f-%.2f] - no feeding needed", ec_min, ec_max);
        status_logger_.resolveAlert("EC_HIGH");
        auto_ec_check_pending_ = false;
        transitionAfterEcSkipped();
        return;
    }

    // EC below minimum - feeding required
    ESP_LOGI(TAG, "[EC_PROCESSING] EC low (%.3f < %.3f) - starting feeding cycle", ec_current, ec_min);

    // Store initial EC and reset cycle state for K-factor calculation
    ec_pre_feeding_ = ec_current;
    ec_total_ml_per_L_ = 0.0f;
    ec_attempt_count_ = 0;
    ec_cycle_water_filled_ = false;

    // Log PSM event for crash recovery
    if (psm_) {
        psm_->logEvent("EC_FEEDING", 0);  // 0 = STARTED
    }

    transitionTo(ControllerState::EC_CALCULATING);
}

void PlantOSController::handleEcCalculating() {
    // Yellow fast blink - calculating EC-based nutrient doses
    if (!hal_ || !calendar_manager_) {
        ESP_LOGW(TAG, "[EC_CALCULATING] Missing dependencies - aborting");
        if (psm_) psm_->clearEvent();
        transitionTo(ControllerState::IDLE);
        return;
    }

    // Use current EC reading for delta (may differ from ec_pre_feeding_ on retries)
    float ec_current = hal_->hasECValue() ? hal_->readEC() : ec_pre_feeding_;
    auto schedule = calendar_manager_->get_today_schedule();
    float ec_target = schedule.ec_target * ec_target_multiplier_;  // calendar target scaled by slider
    float delta_ec = ec_target - ec_current;

    if (delta_ec <= 10.0f) {  // 0.01 mS/cm = 10 µS/cm
        ESP_LOGI(TAG, "[EC_CALCULATING] EC already at or above target - no dosing needed");
        if (psm_) psm_->clearEvent();
        transitionTo(ControllerState::IDLE);
        return;
    }

    // Total dose in mL/L using adaptive K-factor
    float total_ml_per_L = delta_ec / ec_K_feed_;

    // Tank volume for absolute dose calculation
    float tank_volume_L = hal_->getTankVolumeDelta();
    if (tank_volume_L <= 0.0f) {
        ESP_LOGW(TAG, "[EC_CALCULATING] Tank volume unavailable - using 10L fallback");
        tank_volume_L = 10.0f;
    }

    // A:B:C ratio from CalendarManager
    float r_A = schedule.nutrient_A_ml_per_liter;
    float r_B = schedule.nutrient_B_ml_per_liter;
    float r_C = schedule.nutrient_C_ml_per_liter;
    float r_total = r_A + r_B + r_C;

    if (r_total <= 0.0f) {
        ESP_LOGW(TAG, "[EC_CALCULATING] No nutrient ratios for day %d - skipping",
                 calendar_manager_->get_current_day());
        if (psm_) psm_->clearEvent();
        transitionTo(ControllerState::IDLE);
        return;
    }

    // Calculate absolute doses per pump, capped at calendar max dose
    ec_dose_A_ml_ = std::min((r_A / r_total) * total_ml_per_L * tank_volume_L, r_A * tank_volume_L);
    ec_dose_B_ml_ = std::min((r_B / r_total) * total_ml_per_L * tank_volume_L, r_B * tank_volume_L);
    ec_dose_C_ml_ = std::min((r_C / r_total) * total_ml_per_L * tank_volume_L, r_C * tank_volume_L);

    // Accumulate mL/L for K-factor update after mixing
    float dosed_total_ml = ec_dose_A_ml_ + ec_dose_B_ml_ + ec_dose_C_ml_;
    ec_total_ml_per_L_ += (tank_volume_L > 0.0f) ? (dosed_total_ml / tank_volume_L) : 0.0f;

    ESP_LOGI(TAG, "[EC_CALCULATING] EC delta=%.1f uS/cm, K=%.6f, total=%.3f mL/L",
             delta_ec, ec_K_feed_, total_ml_per_L);
    ESP_LOGI(TAG, "[EC_CALCULATING] Doses: A=%.2f mL, B=%.2f mL, C=%.2f mL (tank %.1fL)",
             ec_dose_A_ml_, ec_dose_B_ml_, ec_dose_C_ml_, tank_volume_L);

    transitionTo(ControllerState::EC_FEEDING);
}

void PlantOSController::handleEcFeeding() {
    // Orange pulse - sequential nutrient pump A → B → C (EC-calculated doses)
    uint32_t elapsed = getStateElapsed();
    static uint32_t current_ec_duration_ms = 0;

    // Use state_counter_ as pump index (0=A, 1=B, 2=C, 3=done)
    const char* pump_name = nullptr;
    float dose_ml = 0.0f;

    if (state_counter_ == 0) {
        pump_name = NUTRIENT_PUMP_A;
        dose_ml = ec_dose_A_ml_;
    } else if (state_counter_ == 1) {
        pump_name = NUTRIENT_PUMP_B;
        dose_ml = ec_dose_B_ml_;
    } else if (state_counter_ == 2) {
        pump_name = NUTRIENT_PUMP_C;
        dose_ml = ec_dose_C_ml_;
    } else {
        // All pumps complete - accumulate mL/L for K-factor update, then mix
        if (hal_) {
            float tank_L = hal_->getTankVolumeDelta();
            if (tank_L > 0.0f) {
                float dosed_ml = ec_dose_A_ml_ + ec_dose_B_ml_ + ec_dose_C_ml_;
                ec_total_ml_per_L_ += dosed_ml / tank_L;
            }
        }
        if (is_mother_mix_) {
            is_mother_mix_ = false;
            ESP_LOGI(TAG, "[EC_FEEDING] Mother mix complete → IDLE");
            if (psm_) psm_->clearEvent();
            transitionTo(ControllerState::IDLE);
        } else {
            ESP_LOGI(TAG, "[EC_FEEDING] Nutrient dosing complete (total so far: %.4f mL/L) - starting mixing",
                     ec_total_ml_per_L_);
            transitionTo(ControllerState::EC_MIXING);
        }
        return;
    }

    // On entry for each pump: calculate duration and activate (only once per pump)
    if (!state_entry_executed_) {
        state_entry_executed_ = true;

        if (dose_ml > 0.0f && hal_) {
            float duration_sec = hal_->pumpflow(pump_name, dose_ml);
            current_ec_duration_ms = static_cast<uint32_t>(duration_sec * 1000.0f);
            ESP_LOGI(TAG, "[EC_FEEDING] %s: %.2f mL = %.2f sec (%d ms)",
                     pump_name, dose_ml, duration_sec, current_ec_duration_ms);
        } else {
            current_ec_duration_ms = 0;
        }

        if (current_ec_duration_ms > 0) {
            uint32_t duration_sec = (current_ec_duration_ms + 999) / 1000;
            if (!requestPumpAdaptive(pump_name, true, duration_sec, false)) {
                ESP_LOGE(TAG, "[EC_FEEDING] %s rejected by SafetyGate - aborting EC feeding", pump_name);
                if (psm_) psm_->clearEvent();
                transitionTo(ControllerState::IDLE);
                return;
            }
            state_start_time_ = hal_->getSystemTime();
        } else {
            ESP_LOGI(TAG, "[EC_FEEDING] %s dose=0 - skipping", pump_name);
            state_counter_++;
            state_entry_executed_ = false;  // allow entry block to run for next pump
            state_start_time_ = hal_->getSystemTime();
        }
        return;
    }

    // Wait for pump duration + 200ms safety margin
    if (elapsed < current_ec_duration_ms + 200) {
        return;
    }

    // Turn off pump explicitly
    if (safety_gate_) {
        safety_gate_->executeCommand(pump_name, false, 0);
    }
    ESP_LOGI(TAG, "[EC_FEEDING] %s complete", pump_name);

    // Advance to next pump
    state_counter_++;
    state_entry_executed_ = false;  // allow entry block to run for next pump
    state_start_time_ = hal_->getSystemTime();
}

void PlantOSController::handleEcMixing() {
    // Blue pulse - 5 minute mixing after EC nutrient dosing
    // AirPump controlled externally (Shelly pattern); we just wait for mixing to complete
    static constexpr uint32_t EC_MIXING_DURATION_MS = 300000;  // 5 minutes

    uint32_t elapsed = getStateElapsed();

    if (!state_entry_executed_) {
        state_entry_executed_ = true;
        ESP_LOGI(TAG, "[EC_MIXING] Waiting 5 minutes for nutrients to mix");
    }

    if (elapsed >= EC_MIXING_DURATION_MS) {
        ESP_LOGI(TAG, "[EC_MIXING] Mixing complete - measuring EC");
        transitionTo(ControllerState::EC_MEASURING);
    }
}

void PlantOSController::handleEcMeasuring() {
    // Yellow pulse - re-measure EC after mixing, update K-factor, decide next step
    static constexpr uint32_t EC_SETTLE_MS = 30000;  // 30s settle time before reading

    uint32_t elapsed = getStateElapsed();

    if (!state_entry_executed_) {
        state_entry_executed_ = true;
        ec_attempt_count_++;
        uint8_t max_attempts = feeding_manual_mode_ ? FEEDING_MANUAL_MAX_CYCLES : MAX_EC_ATTEMPTS;
        ESP_LOGI(TAG, "[EC_MEASURING] Installment %d/%d - waiting %.0fs for EC to stabilize",
                 ec_attempt_count_, max_attempts, EC_SETTLE_MS / 1000.0f);
        return;
    }

    if (elapsed < EC_SETTLE_MS) {
        return;
    }

    if (!hal_->hasECValue()) {
        ESP_LOGW(TAG, "[EC_MEASURING] No EC reading available - aborting cycle");
        feeding_manual_mode_ = false;
        if (psm_) psm_->clearEvent();
        transitionTo(ControllerState::IDLE);
        return;
    }

    float ec_after = hal_->readEC();
    ESP_LOGI(TAG, "[EC_MEASURING] EC after installment: %.1f uS/cm (pre-cycle: %.1f, delta: +%.1f)",
             ec_after, ec_pre_feeding_, ec_after - ec_pre_feeding_);

    // Update adaptive K-factor based on observed EC response
    updateEcKFactor(ec_pre_feeding_, ec_after, ec_total_ml_per_L_);

    // Record timestamp to enforce 4h minimum interval between automatic feedings
    if (hal_->hasTime()) {
        last_ec_feeding_timestamp_ = hal_->getCurrentTimestamp();
    }

    // Get target to check if we're in range
    float ec_min = 0.0f;
    float ec_target = 0.0f;
    if (calendar_manager_) {
        auto schedule = calendar_manager_->get_today_schedule();
        ec_target = schedule.ec_target * ec_target_multiplier_;  // calendar target scaled by slider
        ec_min = ec_target - schedule.ec_tolerance;
    }

    uint8_t max_attempts = feeding_manual_mode_ ? FEEDING_MANUAL_MAX_CYCLES : MAX_EC_ATTEMPTS;
    bool in_range = (ec_min > 0.0f) && (ec_after >= ec_min);
    bool max_attempts_reached = (ec_attempt_count_ >= max_attempts);

    if (in_range) {
        ESP_LOGI(TAG, "[EC_MEASURING] EC target reached (%.1f >= %.1f uS/cm) after %d installment(s)",
                 ec_after, ec_min, ec_attempt_count_);
        feeding_manual_mode_ = false;
        status_logger_.resolveAlert("EC_HIGH");
        status_logger_.resolveAlert("EC_LOW");
    } else if (max_attempts_reached) {
        ESP_LOGW(TAG, "[EC_MEASURING] Max installments (%d) reached - EC still %.1f uS/cm (target %.0f)",
                 max_attempts, ec_after, ec_target);
        feeding_manual_mode_ = false;
        status_logger_.updateAlertStatus("EC_LOW",
            "EC below target after max feeding installments - check nutrient supply");
    } else if (feeding_manual_mode_) {
        // Manual feeding: use same pre-calculated installment doses (not K-factor recalculation)
        ESP_LOGI(TAG, "[EC_MEASURING] EC still low (%.1f < %.1f uS/cm) - giving installment %d",
                 ec_after, ec_min, ec_attempt_count_ + 1);
        transitionTo(ControllerState::EC_FEEDING);
        return;
    } else {
        // Automated EC correction: retry with K-factor recalculated dose
        ESP_LOGI(TAG, "[EC_MEASURING] EC still low (%.1f < %.1f uS/cm) - retry %d/%d",
                 ec_after, ec_min, ec_attempt_count_, MAX_EC_ATTEMPTS);
        transitionTo(ControllerState::EC_CALCULATING);
        return;
    }

    // Always check pH after EC feeding (nutrients shift pH)
    ESP_LOGI(TAG, "[EC_MEASURING] EC cycle complete - triggering pH check (5-min stabilization)");

    // Reset pH state for clean correction cycle
    ph_attempt_count_ = 0;
    ph_readings_.clear();
    ph_current_ = 0.0f;
    ph_dose_ml_ = 0.0f;
    ph_dose_duration_ms_ = 0;
    ph_cycle_start_ph_ = 0.0f;
    ph_cycle_total_ml_ = 0.0f;
    ph_cycle_water_filled_ = false;
    ph_cycle_aborted_ = false;

    // Use extended stabilization: nutrients need time to distribute before accurate pH reading
    ph_post_feed_stabilize_ = true;

    if (psm_) {
        psm_->clearEvent();
        psm_->logEvent("PH_CORRECTION", 0);  // 0 = STARTED
    }

    transitionTo(ControllerState::PH_PROCESSING);
}
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
