CodyMcCodeface69/plantOS-Hydromat/components/plantos_hal/hal.h

#pragma once

#include <string>
#include <functional>
#include <map>
#include <vector>
#include <atomic>
#include <freertos/FreeRTOS.h>
#include <freertos/queue.h>
#include <freertos/task.h>
#include "esphome/core/component.h"
#include "esphome/core/time.h"
#include "esphome/components/time/real_time_clock.h"

// Forward declarations
namespace esphome {
namespace light {
class LightState;
}
namespace sensor {
class Sensor;
}
namespace binary_sensor {
class BinarySensor;
}
namespace switch_ {
class Switch;
}
namespace output {
class FloatOutput;
}
namespace ezo_ph_uart {
class EZOPHUARTComponent;
}
namespace actuator_safety_gate {
class ActuatorSafetyGate;
}
}  // namespace esphome

namespace tds_sensor {
class TDSSensor;
}  // namespace tds_sensor

namespace plantos_hal {

/**
 * Pump Configuration Structure
 *
 * Stores calibration data for each pump to enable accurate dosing
 * by converting mL volumes to time durations.
 */
struct PumpConfig {
    std::string pump_id;          // Pump identifier (e.g., "AcidPump")
    float flow_rate_ml_s;         // Flow rate in mL/second at configured PWM
    float pwm_intensity;          // PWM intensity (0.0-1.0, default 1.0 = 100%)

    PumpConfig()
        : pump_id(""),
          flow_rate_ml_s(1.0f),   // Default: 1 mL/s
          pwm_intensity(1.0f) {}   // Default: 100% PWM

    PumpConfig(const std::string& id, float flow_rate, float pwm)
        : pump_id(id),
          flow_rate_ml_s(flow_rate),
          pwm_intensity(pwm) {}
};

/**
 * Hardware Abstraction Layer (HAL) Interface
 *
 * This interface provides platform-agnostic access to all hardware components.
 * No direct GPIO, I2C, or hardware API calls should exist above this layer.
 *
 * Layer 3 (Foundation): Hardware Abstraction
 * - Actuators: Controlled by SafetyGate (Layer 2)
 * - Sensors: Read by Controller (Layer 1)
 * - User Feedback: LED control by Controller LED behaviors
 * - System: Time management
 */
class HAL {
public:
    virtual ~HAL() = default;

    // ============================================================================
    // ACTUATORS - Called by SafetyGate ONLY
    // ============================================================================

    /**
     * Set pump state (ON/OFF) - Legacy method for backward compatibility
     * @param pumpId Pump identifier (e.g., "AcidPump", "NutrientPumpA", "AirPump")
     * @param state true = ON, false = OFF
     */
    virtual void setPump(const std::string& pumpId, bool state) = 0;

    /**
     * Set pump state with PWM intensity control
     * @param pumpId Pump identifier (e.g., "AcidPump", "NutrientPumpA")
     * @param state true = ON, false = OFF
     * @param pwmIntensity PWM duty cycle (0.0-1.0, where 1.0 = 100%)
     */
    virtual void setPump(const std::string& pumpId, bool state, float pwmIntensity) = 0;

    /**
     * Calculate pump runtime duration for target volume (Pumpflow)
     * @param pumpId Pump identifier
     * @param targetML Target volume in milliliters
     * @return Duration in seconds (target_ml / flow_rate_ml_s)
     */
    virtual float pumpflow(const std::string& pumpId, float targetML) = 0;

    /**
     * Get pump configuration
     * @param pumpId Pump identifier
     * @return Pump configuration (flow_rate_ml_s, pwm_intensity)
     */
    virtual PumpConfig getPumpConfig(const std::string& pumpId) const = 0;

    /**
     * Set pump configuration
     * @param pumpId Pump identifier
     * @param flowRateMLPerSec Flow rate in mL/second at configured PWM
     * @param pwmIntensity PWM intensity (0.0-1.0)
     */
    virtual void setPumpConfig(const std::string& pumpId, float flowRateMLPerSec, float pwmIntensity) = 0;

    /**
     * Update only the PWM intensity for a pump (preserves configured flow rate)
     * Used by the §15 PWM sliders to configure duty cycle without activating the pump
     * @param pumpId Pump identifier
     * @param pwmIntensity PWM intensity (0.0-1.0)
     */
    virtual void setPumpPwm(const std::string& pumpId, float pwmIntensity) = 0;

    /**
     * Set tank volume delta (volume from LOW to HIGH sensor)
     * Used for normal daily feeding operations
     * @param volumeLiters Tank volume delta in liters
     */
    virtual void setTankVolumeDelta(float volumeLiters) = 0;

    /**
     * Get tank volume delta (volume from LOW to HIGH sensor)
     * Used for normal daily feeding operations
     * @return Tank volume delta in liters
     */
    virtual float getTankVolumeDelta() const = 0;

    /**
     * Set total tank volume (volume from EMPTY to HIGH sensor)
     * Used for complete reservoir change operations
     * @param volumeLiters Total tank volume in liters
     */
    virtual void setTotalTankVolume(float volumeLiters) = 0;

    /**
     * Get total tank volume (volume from EMPTY to HIGH sensor)
     * Used for complete reservoir change operations
     * @return Total tank volume in liters
     */
    virtual float getTotalTankVolume() const = 0;

    /**
     * Get tank volume (backward compatibility alias for getTankVolumeDelta)
     * @return Tank volume delta in liters
     * @deprecated Use getTankVolumeDelta() instead
     */
    virtual float getTankVolume() const { return getTankVolumeDelta(); }

    /**
     * Set magnetic valve flow rate
     * @param flowRateMLPerSec Flow rate in mL/second when valve is open
     */
    virtual void setMagValveFlowRate(float flowRateMLPerSec) = 0;

    /**
     * Get magnetic valve flow rate
     * @return Flow rate in mL/second
     */
    virtual float getMagValveFlowRate() const = 0;

    /**
     * Calculate valve open duration for target volume (valveflow)
     * @param targetML Target volume in milliliters
     * @return Duration in seconds (target_ml / mag_valve_flow_rate_ml_s)
     */
    virtual float valveflow(float targetML) = 0;

    /**
     * Set valve state (OPEN/CLOSED)
     * @param valveId Valve identifier (e.g., "WaterValve")
     * @param state true = OPEN, false = CLOSED
     */
    virtual void setValve(const std::string& valveId, bool state) = 0;

    /**
     * Get current pump state
     * @param pumpId Pump identifier
     * @return true if pump is ON, false if OFF
     */
    virtual bool getPumpState(const std::string& pumpId) const = 0;

    /**
     * Get current valve state
     * @param valveId Valve identifier
     * @return true if valve is OPEN, false if CLOSED
     */
    virtual bool getValveState(const std::string& valveId) const = 0;

    /**
     * Check actual Shelly switch status via HTTP GET (future implementation)
     * @param pumpId Pump identifier
     * @return true if pump is ON according to Shelly, false if OFF
     *
     * NOTE: This is a stub for future implementation. Currently returns tracked state.
     * TODO: Query Shelly via HTTP GET /rpc/Switch.GetStatus?id=X
     * ESPHome's callback-based HTTP makes synchronous requests difficult.
     */
    virtual bool checkShellySwitchStatus(const std::string& pumpId) = 0;

    // ============================================================================
    // SHELLY PATTERN API - AirPump Sequence Control
    // ============================================================================

    /**
     * Set AirPump pattern via Shelly sequence API
     *
     * Sends a single HTTP request with alternating ON/OFF pattern.
     * Pattern format: [on_sec, off_sec, on_sec, ...] alternating, starting with ON.
     * Use 0 as first element to start with OFF.
     *
     * Shelly API: http://192.168.0.130/script/1/api?action=sequence&id=0&pattern=X,Y,Z&finalstate=F
     *
     * @param pattern Vector of durations in seconds [on, off, on, off, ...]
     * @param finalState Desired switch state after pattern completes (true=ON, false=OFF)
     * @return true if HTTP request was sent successfully
     *
     * Example: setAirPumpPattern({30, 120, 30}, true)
     *   → 30s ON, 120s OFF, 30s ON, then stays ON
     */
    virtual bool setAirPumpPattern(const std::vector<uint32_t>& pattern, bool finalState) = 0;

    /**
     * Stop any running AirPump sequence and set final state
     *
     * @param finalState Desired switch state after stop (true=ON, false=OFF)
     * @return true if HTTP request was sent successfully
     */
    virtual bool stopAirPumpSequence(bool finalState) = 0;

    /**
     * Check if a Shelly switch has a running sequence
     * Used to determine if we need to stop the sequence before sending commands
     *
     * @param switchId Shelly switch ID (0-3)
     * @return true if a sequence is running on this switch
     */
    virtual bool isSequenceRunning(uint8_t switchId) const = 0;

    /**
     * Ensure no sequence is running on a Shelly switch
     * If a sequence is running, sends stop command before returning
     * Call this before sending any HTTP command to a Shelly switch that might have sequences
     *
     * @param switchId Shelly switch ID (0-3)
     * @param finalState State to set after stopping (true=ON, false=OFF)
     */
    virtual void ensureNoSequenceRunning(uint8_t switchId, bool finalState) = 0;

    /**
     * Control a Shelly switch via HTTP through the sequence-aware API
     * This ensures any running sequences are properly stopped
     * Used by WebUI buttons for consistent behavior
     *
     * @param switchId Shelly switch ID (0-3)
     * @param state Desired switch state (true=ON, false=OFF)
     */
    virtual void setShellySwitch(uint8_t switchId, bool state) = 0;

    // ============================================================================
    // SENSORS - Called by Controller
    // ============================================================================

    /**
     * Read current pH value
     * @return pH value (0.0-14.0), or 0.0 if not available
     */
    virtual float readPH() = 0;

    /**
     * Check if pH sensor has valid reading
     * @return true if pH value is available
     */
    virtual bool hasPhValue() const = 0;

    /**
     * Register callback for pH value changes
     * @param callback Function to call when pH value updates
     */
    virtual void onPhChange(std::function<void(float)> callback) = 0;

    /**
     * Start pH sensor calibration at given point
     * @param calibrationPoint Calibration pH value (e.g., 4.0, 7.0, 10.0)
     * @param calibrationStep 0=mid, 1=low, 2=high
     * @return true if calibration command succeeded
     */
    virtual bool startPhCalibration(float calibrationPoint, int calibrationStep) = 0;

    virtual bool isPhSensorReady() const = 0;
    virtual void setPhVerbose(bool enable) = 0;
    virtual void queryPhCalibrationStatus() = 0;

    /**
     * Take a single pH reading immediately (blocking)
     * @param value Output parameter for pH value
     * @return true if reading was successful
     */
    virtual bool takeSinglePhReading(float &value) = 0;

    /**
     * Get the last pH reading from sensor
     * @return Most recent pH value
     */
    virtual float getLastPhReading() = 0;

    /**
     * Request pH sensor to take a reading
     * This triggers the sensor's update cycle
     */
    virtual void requestPhReading() = 0;

    /**
     * Get configured pH reading interval in milliseconds
     * @return Reading interval in ms
     */
    virtual uint32_t get_ph_reading_interval() const = 0;

    /**
     * Get configured minimum pH threshold
     * @return Minimum pH value
     */
    virtual float get_ph_min() const = 0;

    /**
     * Get configured maximum pH threshold
     * @return Maximum pH value
     */
    virtual float get_ph_max() const = 0;

    /**
     * Read water level
     * @return Water level (implementation-specific units)
     */
    virtual float readWaterLevel() = 0;

    /**
     * Check if water level sensor has valid reading
     * @return true if water level is available
     */
    virtual bool hasWaterLevel() const = 0;

    /**
     * Read water level HIGH sensor (XKC-Y23-V on GPIO17 - WTR_HI)
     * @return true if water is at or above HIGH level, false otherwise
     */
    virtual bool readWaterLevelHigh() = 0;

    /**
     * Read water level LOW sensor (XKC-Y23-V on GPIO23 - WTR_LO)
     * @return true if water is at or above LOW level, false otherwise
     */
    virtual bool readWaterLevelLow() = 0;

    /**
     * Read water level EMPTY sensor (XKC-Y23-V on GPIO22 - WTR_Empty)
     * @return true if water is at or above EMPTY level (minimum safe level), false otherwise
     */
    virtual bool readWaterLevelEmpty() = 0;

    /**
     * Check if water level sensors are configured and available
     * @return true if all THREE sensors (HIGH, LOW, EMPTY) are available
     */
    virtual bool hasWaterLevelSensors() const = 0;

    /**
     * Read light intensity from analog sensor
     * @return Light intensity raw ADC value (0.0-1.0 normalized, or raw voltage)
     */
    virtual float readLightIntensity() = 0;

    /**
     * Check if light intensity sensor has valid reading
     * @return true if light intensity value is available
     */
    virtual bool hasLightIntensity() const = 0;

    /**
     * Read temperature from DS18B20 sensor
     * @return Temperature in degrees Celsius, or 0.0 if not available
     */
    virtual float readTemperature() = 0;

    /**
     * Check if temperature sensor has valid reading
     * @return true if temperature value is available
     */
    virtual bool hasTemperature() const = 0;

    /**
     * Register callback for temperature value changes
     * @param callback Function to call when temperature value updates
     */
    virtual void onTemperatureChange(std::function<void(float)> callback) = 0;

    /**
     * Read EC (Electrical Conductivity) value from TDS sensor
     * @return EC value in uS/cm, or 0.0 if not available
     */
    virtual float readEC() = 0;

    /**
     * Check if EC sensor has valid reading
     * @return true if EC value is available
     */
    virtual bool hasECValue() const = 0;

    /**
     * Register callback for EC value changes
     * @param callback Function to call when EC value updates
     */
    virtual void onECChange(std::function<void(float)> callback) = 0;

    /**
     * Set EC sensor calibration factor (NVS-persisted scaling multiplier)
     * @param factor Calibration factor (0.1–5.0)
     * @return true if saved successfully
     */
    virtual bool setECCalibrationFactor(float factor) = 0;

    /**
     * Get current EC sensor calibration factor
     * @return Current calibration factor (1.0 = uncalibrated)
     */
    virtual float getECCalibrationFactor() const = 0;

    /**
     * Reset EC sensor calibration factor to 1.0 (factory default)
     * @return true if reset successfully
     */
    virtual bool resetECCalibrationFactor() = 0;

    /**
     * Send temperature compensation to pH sensor
     * @param temperature Temperature in degrees Celsius
     * @return true if compensation was successfully sent
     */
    virtual bool sendPhTemperatureCompensation(float temperature) = 0;

    // ============================================================================
    // USER FEEDBACK - Called by Controller (LED behaviors)
    // ============================================================================

    /**
     * Set system LED color and brightness
     * @param r Red component (0.0-1.0)
     * @param g Green component (0.0-1.0)
     * @param b Blue component (0.0-1.0)
     * @param brightness Overall brightness (0.0-1.0)
     */
    virtual void setSystemLED(float r, float g, float b, float brightness = 1.0f) = 0;

    /**
     * Turn off system LED
     */
    virtual void turnOffLED() = 0;

    /**
     * Check if LED is currently on
     * @return true if LED is on
     */
    virtual bool isLEDOn() const = 0;

    // ============================================================================
    // SYSTEM - Called by Controller
    // ============================================================================

    /**
     * Get system uptime in milliseconds
     * @return Milliseconds since system boot (equivalent to millis())
     */
    virtual uint32_t getSystemTime() const = 0;

    /**
     * Get current timestamp (Unix epoch seconds)
     * @return Unix timestamp (seconds since 1970-01-01 00:00:00 UTC), or 0 if time unavailable
     */
    virtual int64_t getCurrentTimestamp() const = 0;

    /**
     * Get seconds since midnight (0:00:00) of current day
     * Used for time-based scheduling aligned to daily boundaries
     * @return Seconds since midnight (0-86399), or 0 if time unavailable
     */
    virtual uint32_t getSecondsSinceMidnight() const = 0;

    /**
     * Check if time source is available and synchronized
     * @return true if time is available, false otherwise
     */
    virtual bool hasTime() const = 0;

    // ============================================================================
    // SHELLY HEALTH CHECK - Called by Controller for device monitoring
    // ============================================================================

    /**
     * Enable/disable the Shelly integration at runtime (web UI switch).
     * Disabled: no polling, Shelly commands are dropped. Disabling first queues a
     * WastewaterPump OFF so the drain pump is never left running unmanaged.
     */
    virtual void setShellyEnabled(bool enabled) = 0;
    virtual bool isShellyEnabled() const = 0;

    /**
     * Check if Shelly device is considered reachable
     * @return true if last ping was successful within timeout period
     */
    virtual bool isShellyReachable() const = 0;

    /**
     * Get Shelly device uptime from last successful ping
     * @return Uptime in seconds, or 0 if unknown
     */
    virtual uint32_t getShellyUptime() const = 0;

    /**
     * Manually update Shelly health status (e.g., after timeout or from YAML callback)
     * @param reachable Whether device is considered reachable
     * @param uptime Device uptime in seconds (0 if unknown)
     */
    virtual void updateShellyHealth(bool reachable, uint32_t uptime = 0) = 0;

    // ============================================================================
    // SHELLY STATE SYNCHRONIZATION - For debouncing and UI state
    // ============================================================================

    /**
     * Update Shelly switch state from external polling
     * Called from YAML when Shelly states are polled via HTTP
     * This updates the local state tracking to match actual device state
     *
     * @param switchId Shelly switch ID (0-3)
     * @param state Actual switch state from Shelly (true=ON, false=OFF)
     */
    virtual void updateShellySwitchState(uint8_t switchId, bool state) = 0;

    /**
     * Get tracked Shelly switch state
     *
     * @param switchId Shelly switch ID (0-3)
     * @return Tracked switch state (true=ON, false=OFF)
     */
    virtual bool getShellySwitchState(uint8_t switchId) const = 0;

    /**
     * Get timestamp of last Shelly state update
     * Used to determine if state is stale
     *
     * @return Timestamp in millis() of last successful state update
     */
    virtual uint32_t getLastShellyStateUpdate() const = 0;
};

/**
 * ESPHome HAL Implementation
 *
 * Wraps ESPHome APIs (light::LightState, sensor::Sensor, GPIO, etc.)
 * to provide a clean hardware abstraction layer.
 */
class ESPHomeHAL : public HAL, public esphome::Component {
public:
    ESPHomeHAL() = default;

    // Component lifecycle
    void setup() override;
    void loop() override;

    // Dependency injection (called from Python __init__.py)
    void set_led(esphome::light::LightState* led);
    void set_ph_sensor(esphome::sensor::Sensor* ph_sensor);
    void set_ph_sensor_component(esphome::ezo_ph_uart::EZOPHUARTComponent* ph_sensor_component);
    void set_temperature_sensor(esphome::sensor::Sensor* temperature_sensor);
    void set_water_level_high_sensor(esphome::binary_sensor::BinarySensor* sensor);
    void set_water_level_low_sensor(esphome::binary_sensor::BinarySensor* sensor);
    void set_water_level_empty_sensor(esphome::binary_sensor::BinarySensor* sensor);
    void set_ec_sensor(esphome::sensor::Sensor* ec_sensor);
    void set_tds_sensor_component(tds_sensor::TDSSensor* tds);
    void set_time_source(esphome::time::RealTimeClock* time_source);

    // Actuator output setters (Phase 2: Hardware Control)
    // NOTE: Using LEDC PWM outputs for pump control with variable intensity
    void set_mag_valve_output(esphome::output::FloatOutput* output);
    void set_pump_ph_output(esphome::output::FloatOutput* output);
    void set_pump_grow_output(esphome::output::FloatOutput* output);
    void set_pump_micro_output(esphome::output::FloatOutput* output);
    void set_pump_bloom_output(esphome::output::FloatOutput* output);
    void set_pump_wastewater_output(esphome::output::FloatOutput* output);

    // Shelly HTTP switch setters (MVP: AirPump, WastewaterPump, GrowLight via Shelly Plus 4PM)
    void set_air_pump_switch(esphome::switch_::Switch* sw);
    void set_wastewater_pump_switch(esphome::switch_::Switch* sw);
    void set_grow_light_switch(esphome::switch_::Switch* sw);

    // ActuatorSafetyGate setter (for state sync on Shelly poll)
    void set_actuator_safety_gate(esphome::actuator_safety_gate::ActuatorSafetyGate* asg);

    // Configuration setters
    void set_ph_reading_interval(uint32_t interval_ms) { ph_reading_interval_ms_ = interval_ms; }
    void set_ph_range(float min_ph, float max_ph) { ph_min_ = min_ph; ph_max_ = max_ph; }

    // Configuration getters
    uint32_t get_ph_reading_interval() const { return ph_reading_interval_ms_; }
    float get_ph_min() const { return ph_min_; }
    float get_ph_max() const { return ph_max_; }

    // HAL interface implementation
    void setPump(const std::string& pumpId, bool state) override;
    void setPump(const std::string& pumpId, bool state, float pwmIntensity) override;
    float pumpflow(const std::string& pumpId, float targetML) override;
    PumpConfig getPumpConfig(const std::string& pumpId) const override;
    void setPumpConfig(const std::string& pumpId, float flowRateMLPerSec, float pwmIntensity) override;
    void setPumpPwm(const std::string& pumpId, float pwmIntensity) override;
    void setTankVolumeDelta(float volumeLiters) override;
    float getTankVolumeDelta() const override;
    void setTotalTankVolume(float volumeLiters) override;
    float getTotalTankVolume() const override;
    void setMagValveFlowRate(float flowRateMLPerSec) override;
    float getMagValveFlowRate() const override;
    float valveflow(float targetML) override;
    void setValve(const std::string& valveId, bool state) override;
    bool getPumpState(const std::string& pumpId) const override;
    bool getValveState(const std::string& valveId) const override;
    bool checkShellySwitchStatus(const std::string& pumpId) override;
    bool setAirPumpPattern(const std::vector<uint32_t>& pattern, bool finalState) override;
    bool stopAirPumpSequence(bool finalState) override;
    bool isSequenceRunning(uint8_t switchId) const override;
    void ensureNoSequenceRunning(uint8_t switchId, bool finalState) override;
    void setShellySwitch(uint8_t switchId, bool state) override;

    float readPH() override;
    bool hasPhValue() const override;
    void onPhChange(std::function<void(float)> callback) override;
    bool startPhCalibration(float calibrationPoint, int calibrationStep) override;
    bool isPhSensorReady() const override;
    void setPhVerbose(bool enable) override;
    void queryPhCalibrationStatus() override;
    bool takeSinglePhReading(float &value) override;
    float getLastPhReading() override;
    void requestPhReading() override;

    float readWaterLevel() override;
    bool hasWaterLevel() const override;
    bool readWaterLevelHigh() override;
    bool readWaterLevelLow() override;
    bool readWaterLevelEmpty() override;
    bool hasWaterLevelSensors() const override;

    float readLightIntensity() override;
    bool hasLightIntensity() const override;

    float readTemperature() override;
    bool hasTemperature() const override;
    void onTemperatureChange(std::function<void(float)> callback) override;
    bool sendPhTemperatureCompensation(float temperature) override;

    float readEC() override;
    bool hasECValue() const override;
    void onECChange(std::function<void(float)> callback) override;
    bool setECCalibrationFactor(float factor) override;
    float getECCalibrationFactor() const override;
    bool resetECCalibrationFactor() override;

    void setSystemLED(float r, float g, float b, float brightness = 1.0f) override;
    void turnOffLED() override;
    bool isLEDOn() const override;

    uint32_t getSystemTime() const override;
    int64_t getCurrentTimestamp() const override;
    uint32_t getSecondsSinceMidnight() const override;
    bool hasTime() const override;

    // Shelly health check methods
    void setShellyEnabled(bool enabled) override;
    bool isShellyEnabled() const override { return shelly_enabled_; }
    bool isShellyReachable() const override;
    uint32_t getShellyUptime() const override;
    void updateShellyHealth(bool reachable, uint32_t uptime = 0) override;

    // Shelly state synchronization methods (callable from YAML)
    void updateShellySwitchState(uint8_t switchId, bool state) override;
    bool getShellySwitchState(uint8_t switchId) const override;
    uint32_t getLastShellyStateUpdate() const override;

private:
    // Hardware component references (injected via Python)
    esphome::light::LightState* led_{nullptr};
    bool led_is_on_{false};
    float led_r_{0.0f}, led_g_{0.0f}, led_b_{0.0f}, led_brightness_{0.0f};
    uint32_t led_last_update_ms_{0};
    static constexpr float LED_MIN_DELTA = 0.02f;         // Ignore changes below 2%
    static constexpr uint32_t LED_MIN_INTERVAL_MS = 50;   // Max 20 LED updates/s

    esphome::sensor::Sensor* ph_sensor_{nullptr};
    esphome::ezo_ph_uart::EZOPHUARTComponent* ph_sensor_component_{nullptr};
    esphome::sensor::Sensor* temperature_sensor_{nullptr};
    esphome::sensor::Sensor* ec_sensor_{nullptr};
    tds_sensor::TDSSensor* tds_sensor_component_{nullptr};
    esphome::binary_sensor::BinarySensor* water_level_high_sensor_{nullptr};
    esphome::binary_sensor::BinarySensor* water_level_low_sensor_{nullptr};
    esphome::binary_sensor::BinarySensor* water_level_empty_sensor_{nullptr};
    esphome::time::RealTimeClock* time_source_{nullptr};

    // Actuator GPIO outputs (Phase 2: Hardware Control - 6 actuators)
    // NOTE: Using FloatOutput (LEDC PWM) for variable pump intensity control
    esphome::output::FloatOutput* mag_valve_output_{nullptr};
    esphome::output::FloatOutput* pump_ph_output_{nullptr};
    esphome::output::FloatOutput* pump_grow_output_{nullptr};
    esphome::output::FloatOutput* pump_micro_output_{nullptr};
    esphome::output::FloatOutput* pump_bloom_output_{nullptr};
    esphome::output::FloatOutput* pump_wastewater_output_{nullptr};

    // Shelly HTTP switches (MVP: AirPump, WastewaterPump, GrowLight)
    esphome::switch_::Switch* air_pump_switch_{nullptr};
    esphome::switch_::Switch* wastewater_pump_switch_{nullptr};
    esphome::switch_::Switch* grow_light_switch_{nullptr};

    // ActuatorSafetyGate reference (for state sync on Shelly poll)
    esphome::actuator_safety_gate::ActuatorSafetyGate* actuator_safety_gate_{nullptr};

    // Shelly IP address
    static constexpr const char* SHELLY_IP = "192.168.0.130";

    // ------------------------------------------------------------------------
    // Shelly worker: all Shelly HTTP runs in its own FreeRTOS task so the main
    // loop (web UI, sensors, FSM) never blocks on the network. The task talks to
    // the main thread only through two queues and never logs; results are
    // logged and applied (ASG sync, switch publish) in loop().
    // ------------------------------------------------------------------------
    struct ShellyRequest {
        char url[256];
        char name[24];
        uint8_t attempts;
    };
    struct ShellyResult {
        char name[24];
        bool is_poll;
        bool ok;
        int16_t status;         // HTTP status, -1 = no connection
        uint32_t uptime;        // poll only
        int8_t states[4];       // poll only: -1 unknown, 0 off, 1 on
    };
    static constexpr uint32_t SHELLY_POLL_INTERVAL_MS = 30000;
    static constexpr uint32_t SHELLY_HTTP_TIMEOUT_MS = 2000;
    static constexpr uint32_t SHELLY_RETRY_DELAY_MS = 500;

    QueueHandle_t shelly_cmd_queue_{nullptr};
    QueueHandle_t shelly_result_queue_{nullptr};
    TaskHandle_t shelly_task_{nullptr};
    std::atomic<bool> shelly_enabled_{true};
    std::atomic<bool> shelly_poll_now_{true};
    bool shelly_disabled_warned_{false};
    uint8_t shelly_poll_failures_{0};

    // Queue a Shelly GET (main thread). Returns false if disabled or the queue is full.
    bool queueShellyRequest(const std::string& url, const char* name, uint8_t attempts = 2,
                            bool force = false);
    void handleShellyResult(const ShellyResult& result);
    static void shellyTaskEntry(void* arg);
    void shellyTaskLoop();

    // Actuator state tracking (for getPumpState/getValveState)
    std::map<std::string, bool> pump_states_;
    std::map<std::string, bool> valve_states_;

    // Pump configuration storage
    std::map<std::string, PumpConfig> pump_configs_;

    // Tank and valve configuration
    float tank_volume_delta_liters_{10.0f};      // Volume from LOW to HIGH (for normal daily feeding)
    float total_tank_volume_liters_{10.0f};      // Volume from EMPTY to HIGH (for reservoir change)
    float mag_valve_flow_rate_ml_s_{50.0f};     // Default: 50 mL/s (3 L/min)

    // Configuration parameters
    uint32_t ph_reading_interval_ms_{7200000};  // Default: 2 hours
    float ph_min_{5.5f};                         // Default: pH 5.5
    float ph_max_{6.5f};                         // Default: pH 6.5

    // Shelly health tracking
    bool shelly_reachable_{false};
    uint32_t shelly_uptime_seconds_{0};
    uint32_t shelly_last_ping_ms_{0};

    // Shelly sequence tracking
    // Track which switches have active sequences running
    // This allows us to stop sequences before sending commands
    struct SequenceState {
        bool running{false};
        uint32_t start_time{0};
        uint32_t estimated_duration_ms{0};  // 0 = unknown/infinite
    };
    SequenceState shelly_sequences_[4];  // One per switch (0-3)

    // Shelly switch state tracking (from polling)
    // These are updated from YAML polling and used for debouncing
    bool shelly_switch_states_[4]{false, false, false, false};
    uint32_t shelly_state_update_time_{0};  // Last successful state update
};

} // namespace plantos_hal
