CodyMcCodeface69/plantOS-Hydromat/components/i2c_scanner/i2c_scanner.cpp

#include "i2c_scanner.h"
#include "esphome/core/log.h"
#include "esphome/core/hal.h"
#include "../plantos_controller/CentralStatusLogger.h"

namespace esphome {
namespace i2c_scanner {

static const char *const TAG = "I2CScanner";

void I2CScanner::setup() {
  ESP_LOGI(TAG, "I²C Scanner component initialized");

  // Perform boot-time scan if enabled
  if (scan_on_boot_ && !boot_scan_done_) {
    ESP_LOGI(TAG, "Performing boot-time I²C bus scan...");
    scanI2CBus();
    boot_scan_done_ = true;
  }

  // Initialize timing for periodic scans
  last_scan_time_ = millis();
}

void I2CScanner::loop() {
  // Only run periodic scans if interval > 0
  if (scan_interval_ == 0) {
    return;
  }

  // Non-blocking timing check
  uint32_t now = millis();
  uint32_t elapsed = now - last_scan_time_;

  if (elapsed >= scan_interval_) {
    scanI2CBus();
    last_scan_time_ = now;
  }
}

void I2CScanner::dump_config() {
  ESP_LOGCONFIG(TAG, "I²C Scanner:");
  LOG_I2C_DEVICE(this);
  ESP_LOGCONFIG(TAG, "  Scan on boot: %s", scan_on_boot_ ? "YES" : "NO");

  if (scan_interval_ > 0) {
    ESP_LOGCONFIG(TAG, "  Scan interval: %.1f seconds", scan_interval_ / 1000.0f);
  } else {
    ESP_LOGCONFIG(TAG, "  Scan interval: DISABLED (boot-time only)");
  }

  if (!critical_devices_.empty()) {
    ESP_LOGCONFIG(TAG, "  Critical devices (%d):", critical_devices_.size());
    for (const auto &device : critical_devices_) {
      ESP_LOGCONFIG(TAG, "    - 0x%02X: %s", device.address, device.name.c_str());
    }
  } else {
    ESP_LOGCONFIG(TAG, "  Critical devices: NONE");
  }
}
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
