CodyMcCodeface69/plantOS-Hydromat/(commit log)

2025-11-22 use dummy sensor in controller
2025-11-29 feat: Synchronized local PlantOS Testlab changes (v0.2)
    [pyvenv.cfg]
2025-11-29 Added ActuatorSafetyGate with DummyActuatorTrigger
2025-12-01 bugfix: web server working in mesh network again
    [plantOS.yaml]
2025-12-02 Fixed mesh (deco) compatibility for real, added buttons, simplified task run (no user prompt, defaults to serial flashing)
    [plantOS.yaml]
2025-12-03 verbose mode for controller incl web ui toggle button
2025-12-03 Added I2C Scan, Updated Status Logger
2025-12-04 Add ezo_ph component for Mikroe I2C Device
2025-12-04 Add Ramp up/down to Actuator Safety Gate
2025-12-06 FSM Unification Phase 6: Port Feeding and Water Management
    Implemented three critical state handlers for PlantOS unified controller:
    1. FEEDING State (handleFeeding)
    - Sequential nutrient pump activation: A → B → C
    - State counter tracking (0=A, 1=B, 2=C, 3=done)
    - SafetyGate approval for each pump
    - Hardcoded durations (5s/4s/3s) with Phase 7 TODO for Calendar
    - 200ms safety margin after each pump
    - Handles SafetyGate rejection gracefully
    - Supports zero-duration pumps (auto-skip)
    2. WATER_FILLING State (handleWaterFilling)
    - 30-second fill duration (matches old PlantOSLogic)
    - SafetyGate approval required
    - Explicit valve close after duration + 200ms mar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
    [controller.cpp]
2025-12-07 Fix Central Status Logger and Maintenance Modes
    [CentralStatusLogger.cpp, CentralStatusLogger.h, controller.cpp, controller.h, led_behavior.cpp, plantOS.yaml, solid_orange.cpp, solid_orange.h]
2025-12-07 Fix PSM Part 1
    [controller.cpp, controller.h, plantOS.yaml]
2025-12-07 Fix PSM Part 2
    [controller.cpp]
2025-12-07 Fix Central Status Logger
    [controller.cpp, i2c_scanner.cpp, plantOS.yaml]
2025-12-15 Add simple light sensor and change OTA flashing behavior in task run OTA=true
2025-12-16 ezo ph fixes pt1
    [CentralStatusLogger.cpp, CentralStatusLogger.h, controller.cpp, controller.h, ezo_ph_uart.cpp, ezo_ph_uart.h, hal.cpp, hal.h]
2025-12-16 ezo ph fixes pt2 (readings work)
    [ezo_ph_uart.cpp, ezo_ph_uart.h, plantOS.yaml]
2025-12-26 Add Actuator Implementation Pt1
2025-12-26 Fix Actuator WebUI Button
    [plantOS.yaml]
2025-12-27 Fix Wifi Mesh, fix Task reboot
    [plantOS.yaml]
2025-12-27 Add 1-wire device info logging
2025-12-28 Move Water Temp Sensor to GPIO23, Remove Wastewater Pump
2025-12-29 revamp pH sensor calibration mode, add verbose toggles (to be debugged)
2025-12-29 Add Pump Control UI, Debug ASG Debouncing when ASG is disabled
2025-12-30 Add mL handling for pumps and calendar
2025-12-30 Comments for Nutrient to Pump relation (Grow = Nutrient A, Micro =Nutrient B, Bloom = Nutrient C)
2025-12-30 Add water level sensor
2025-12-30 fix online check pt 2
    [plantOS.yaml]
2026-01-01 Move sensor info in central status logger, check to dos
2026-01-02 Add Time dummy buttons for minute and second
2026-01-02 Fix calendar and dummy clock interaction
    [controller.cpp]
2026-01-02 Add variable duration calculation and max times for controller actuator control, Update Central Status Logger Hardware Status
2026-01-02 Add Shelly switch with grow light, wastewater and airpump control logic
2026-01-02 Fix calman's current grow day controller implementation
    [controller.cpp]
2026-01-03 Add wastewater pump via shelly and controller night mode + FSMINFO.md as controller documentation (included in CLAUDE.md may lead to high token usage)
2026-01-03 pH correction states fine tuning
    [controller.cpp, controller.h, plantOS.yaml]
2026-01-03 Air Pump controller fixes
    [controller.cpp, controller.h, plantOS.yaml]
2026-01-05 Port Air Pump cycling fixes from Shelly-BLE Branch
    [controller.cpp, controller.h, hal.cpp, hal.h, plantOS.yaml]
2026-01-05 fix ph mixing state (air pump on)
    [controller.cpp]
2026-01-05 Fix HAL HTTP requests
    [hal.cpp, hal.h]
2026-01-05 Add Enhanced Error Handling
    [CentralStatusLogger.cpp, CentralStatusLogger.h, controller.cpp, controller.h, plantOS.yaml]
2026-01-11 Add Clock Based pH Correction, Fix Pump Activation Duration in Controller
    [controller.cpp, controller.h, hal.cpp, hal.h, plantOS.yaml]
2026-01-12 Fix Http Timeout and WDT
    [plantOS.yaml]
2026-01-13 Add BME280 Air Sensor
2026-01-13 Add Third Water Level Sensor (EMPTY) + Automatic Feeding System
2026-01-15 NOT WORKING! Tried re-implementing BME280 and fixing the resulting WDT errors and aborts
    [controller.cpp, controller.h, ezo_ph_uart.cpp, ezo_ph_uart.h, hal.cpp, hal.h]
2026-01-16 Fixed broken lambda (get AutoFeedEnabled from NVS caused memory overflow); Added esp idf monitor crash decoder to task run/snoop IDFMON=true
    [plantOS.yaml]
2026-01-16 Fix Shelly HTTP handling and controller behavior for Airpump
    [controller.cpp, controller.h, plantOS.yaml]
2026-01-17 Cleanup docs, Clean Up Web UI Controller Buttons, Adapt Controller Tank Drain Functions for 3 Sensor Water Level Design
2026-01-17 Fix pH Calibration Alert Clearing
    [controller.cpp, plantOS.yaml]
2026-01-17 Cleanup Codebase; Add Shelly API script to outsource rapid on/off switching
2026-01-18 Disable boot-time air pump HTTP activation
    Boot-time HTTP requests to Shelly cause socket exhaustion issues.
    Air pump should be manually enabled via Shelly app/web UI at boot.
    [plantOS.yaml]
2026-01-19 Fix on boot shelly http request (no more debouncing)
    [hal.cpp, plantOS.yaml]
2026-01-19 fix shelly uptime counter
    [hal.cpp]
2026-01-20 Add text sensor for alert state
2026-01-21 Update Pinout (Actuators on one side, Sensors on the other for hardware layout)
2026-02-22 Add TDS Sensor
2026-03-04 update Pinout with TDS Sensor
2026-03-07 Logicplan Phase 1
    [Hydroponik_Zielwerttabelle.csv]
2026-03-08 Add TDS Sensor Calibration
2026-03-08 Update TDS Sensor Calibration and Unit Logic
2026-03-10 Fix EC Calibration
2026-03-11 Add TDS verbose toggle
    [Hydroponik_Zielwerttabelle.csv]
2026-04-05 Add Hardware Documentation
    [BOM_HydromatMK1_PCB_HydromatMK1_2026-04-05.csv, ProPrj_HydromatMK1_2025-12-27_13-47-41_2026-04-05.epro]
2026-04-24 Re-Add ezo ph i2c component
2026-04-24 Add ezo i2c/uart switch helper and buttons
2026-04-25 fix ezo ph i2c pt1
    [ezo_ph.cpp, plantOS.yaml]
2026-04-25 fix ezo ph i2c pt2
    [ezo_ph.cpp, ezo_ph.h, plantOS.yaml]
2026-05-16 Revert to ezo ph UART and fix HAL violations in controller
    [controller.cpp, controller.h, hal.cpp, hal.h, plantOS.yaml]
2026-05-16 fix status logger labels sda/scl
    [controller.cpp]
2026-05-16 fix webui button for uart
    [plantOS.yaml]
2026-05-16 fix calibration query response
    [ezo_ph_uart.cpp]
2026-05-16 fix logging level cal query
    [plantOS.yaml]
2026-05-25 add wifi scan button
2026-05-25 fix wrong logic error for water level sensors
    [controller.cpp, controller.h]
2026-05-25 add controller state webui buttons
2026-05-25 switch to real time clock
2026-05-25 fix ntp clock 1
    [plantOS.yaml]
2026-05-26 add ntp sync button
2026-05-28 Add HIGH level sensor check to Mag Valve ASG control to prevent overflow in tank
2026-05-31 fix cal man and sntp
    [controller.cpp, controller.h, plantOS.yaml]
2026-05-31 fix nutrient slider logic (only manipulate ec target value)
    [CentralStatusLogger.cpp, CentralStatusLogger.h, controller.cpp, controller.h, plantOS.yaml]
2026-06-04 Fix PWM Sliders to control all HAL activations
    [hal.cpp, hal.h, plantOS.yaml]
2026-06-04 switch primary dns
2026-06-04 document motherplant chamber plan
2026-06-06 adjust flowrates to real setup
2026-06-07 Add mother plant nutrient dispenser button
2026-07-19 Fix stale pH stabilization flags leaking into manual pH correction
    [controller.cpp, controller.h]
2026-07-19 Refuse blind tank filling without water level sensors
2026-10-04 Rewrite CLAUDE.md to match current code and add web UI cleanup plan
2026-10-04 Throttle system LED updates and stop publishing the LED entity
    The FSM LED animation called LightState::perform() every loop, which pushed
    ~26 state events/s to the web UI plus MQTT/API publishes. The HAL now skips
    invisible changes and caps updates at 20 Hz; the light is internal.
    [hal.cpp, hal.h, plantOS.yaml]
2026-10-04 Make periodic log reports on-demand and lower log levels
    - Status report off by default, new 'Print Status Report' button
    - GPIO level dump moved from a 30s interval to a button, pinout corrected
    - Calendar status log every 10 min instead of 30 s
    - Logger compile level DEBUG, wifi/http_request WARN
    - DS18B20 label in status report fixed (GPIO3)
    [CentralStatusLogger.cpp, CentralStatusLogger.h, controller.cpp, controller.h, plantOS.yaml]
2026-10-04 Move debug-only entities into an optional packages/debug.yaml
    Verbose log switches, direct GPIO switches, HAL mirror text sensors and the
    Shelly/GPIO test buttons (29 entities) now live in a package that production
    builds leave out. PWM sliders stay in core and move to the Actuators group.
2026-10-04 Move Shelly HTTP into a HAL worker task and add a runtime on/off switch
    Shelly polls and commands no longer block the main loop: a FreeRTOS task in
    ESPHomeHAL does the HTTP (esp_http_client, 2s timeout) and hands results back
    through a queue. New web UI switch 'Shelly Integration' disables polling and
    commands; turning it off first stops the wastewater pump. Tank drain and
    reservoir change are refused (or aborted) while Shelly is disabled.
    [controller.cpp, hal.cpp, hal.h, plantOS.yaml]
2026-10-04 Embed the ESPHome 2025.4 web frontend instead of loading the latest one
    The default v3 www.js from oi.esphome.io is always the newest frontend. It
    expects a 'domain' field in SSE state events that ESPHome 2025.4 doesn't send
    and ignores such entities until it has seen 3 state events, so buttons,
    switches and numbers (one event each) never appeared. web_server local: true
    serves the version-matched frontend from flash.
    [plantOS.yaml]
